koorayworks/7spromax-case/design/DESIGN_NOTES.md

# 7sProMax 3Dプリントケース 設計メモ v1（試作ラウンド）

> **v2 で大幅に作り直した（2026-11-04）。最新の設計内容は §16 を正とすること。**
> §1〜§15 は v1 の記録で、FR4 前提・図面一律 inset・FR4穴基準のネジ計画などは
> v2 では採用していない。

生成スクリプト: `build_case.py`（build123d 0.13 + shapely、寸法は冒頭パラメータに集約）
座標系: DXFテンプレートの半分ローカル座標。X=奥行（0..114.29、x=114側が背面）、
Y=長さ（short: y=0 が階段/中央側、y=143.36 が外側端 ／ long: y=0 が外側端、y=177.23 が階段側）、Z=ケース底面基準。

## 1. 構成（本人の確定仕様）

- パーツは片側ごとに3点：**トップフレーム（枠）／スイッチプレート（別体）／ボトムケース**。
  白FR4ボトムプレートはボトムケース底の浅い凹みに収め、底側の層として再利用する。
- 有線のみ・傾斜なし（フラット）・連結スロット無し。本家の積層
  （アルミトップ／基板／アクリル積層／FR4ボトム）のうち、アクリル層（基板周囲の
  スペーサー兼ライトガイド、実測の隙間 3〜3.5mm 相当）はボトムケースの壁で置き換えた。
- プレート別体の理由（本人指示）: スイッチ穴69個の層を枠と一体にすると印刷品質が
  出ないため。プレートは平板として単体印刷する。

## 2. Z方向の積み上げ（ケース底面 z=0、総高 16.1 = 本家側面図 16.1 と一致）

| z範囲 | 内容 |
|---|---|
| 0 〜 1.3 | ボトムケース床（FR4凹みの下）※ネジ頭ザグリはここに取る |
| 1.3 〜 2.5 | **FR4ボトムプレート 1.2**（凹みに収納、凹み底 1.3） |
| 2.5 〜 5.7 | 隙間 3.2（実測 3〜3.5、本家アクリル積層相当。基板裏面LED・TRRS下端の逃げ） |
| 5.7 〜 7.3 | **基板 1.6**（下端 5.7 はボトムケース壁天端＋支持レッジで受ける） |
| 7.3 〜 9.5 | 隙間（ソケット上面 = 基板表面+2.0 → 9.3 の上に 0.2 逃げ） |
| 9.5 〜 11.0 | **スイッチプレート 1.5（別体）** |
| 11.0 〜 12.85 | フレームのリップ（プレート外周を上から押さえる帯） |
| 12.85 〜 16.1 | フレームのウェル壁（天面開口 = 図面ポケット + 0.25） |

参考: スイッチのステム上端は基板表面+14.5 → z=21.8 でケース天面より上（本家も同様）。
タクトスイッチは基板**裏面**実装（写真 7315/7316 で確認）で、ボタン先端は基板裏面の
約 5.0 下まで届く前提 → 後述のタクト逃げ窓が必要。

## 3. 平面の設計値

- 壁厚 **WALL = 2.6**（外形→内腔）。基板外形はケース外形の約 3〜3.9 内側（実測中央値）
  なので、基板と内壁の間には概ね 0.5〜1.3 の余裕がある。階段部は基板輪郭データの
  信頼性が低いため、追加クリアランス `STAIR_CLR`（現状 0、壁一律）を用意した。
- スイッチプレート外周 = 図面ポケット輪郭 + **3.0**（`PLATE_UNDERLAP`、リップの下に
  隠れる分）、フレーム内壁との隙間 **0.25**。天面開口 = ポケット + 0.25。
- FR4凹み: 外形から inset **0.8**（FR4外形 141.1×103.1 / 174.7×103.5 がほぼ全面に
  広がるため薄壁になる。FR4実物の輪郭は未計測で、当たりは試作片で確認）。
- 基板支持レッジ: 外形から inset 5.2 の内側境界を持つ帯（z 4.5〜5.7）で基板端を
  下から受ける。裏面LEDはスイッチ位置（最寄り行で縁から約15mm）にあるため干渉しない想定。
- 背面のリムは約 10mm（ポケット x=104.24 ↔ 外形 114.29）あり、本家イメージの
  「厚めのベゼル」感に寄せた。外形の角Rは図面どおり（設計者CADの輪郭をそのまま使用）。

## 4. スイッチプレートの固定方法（選択と理由）

**採用: 挟み込み**。プレート外周の帯（ポケット+3.0 の部分）を、トップフレーム内側の
リップ（z 11.0〜12.85、下面がプレート天面に接する）が上から押さえ、下からは
69個のスイッチのフランジ＋ソケットが受ける。プレート自体にネジは通さない。

- 印刷しやすさ: プレートは完全な平板（吊りボス除く）で、反り・サポートの心配が
  最小。ツメ方式は薄いツメの印刷再現性と耐久に不安が残るため見送り。
- ガタつき: 周囲全周をリップで押さえるため点固定より面で効く。面方向の位置決めは
  フレーム内壁（隙間 0.25）とスイッチ穴そのもので決まる。
- 例外: 基板深部のFR4穴に対応する位置には、プレート裏面に**吊りボス**を一体成形
  した（§5）。これはプレート固定ではなくケース締結用で、プレートの支持点も兼ねる。
- 組み立て順: 基板にスイッチを挿す → プレートを被せる（スイッチが位置決めになる）
  → フレームを被せて裏からネジ締め。

## 5. ネジ計画（FR4プレート実測穴 19個の使い分け）

下からネジを通し、フレーム側ボス／プレート裏の吊りボスへタッピングする
本家同様のサンドイッチ締結。インサートなし。
下穴径: M3 = **Ø2.8**、M2 = **Ø1.7**。床側は通し穴 Ø3.4/Ø2.4 + 頭ザグリ
（FR4下面直下まで、低頭ネジ前提）。

| 分類 | 意味 | short | long |
|---|---|---|---|
| boss | フレーム側ボス（基板の外 or 端から4mm以内の帯） | L1(M3) L9(M3) L3 L4 L7 L8 (M2) | R1(M3) R2(M3) R3 R4 R5 R8 (M2) |
| hang | プレート裏の吊りボス Ø7/Ø5.5（基板に取付穴がある前提） | L2(M3) | （なし） |
| pin | ボトムケースの位置決めピン（ネジなし） | L5 L6 | R6 R7 R9 R10 |

- 本家キット実績（M3×8 ×6、M2×12 ×9、M2×7 ×4 = 穴数 大6/小13 と一致）が裏付け。
  本設計のネジ本数は M3 5本・M2 8本（残りはピン）。分類は基板輪郭（スキャン）と
  変換（§9）の両方が暫定のため、試作結果で入れ替わり得る。
- 推奨ネジ: 端部ボス M3 → **M3×8**、端部ボス M2 → **M2×7**、
  吊りボス → **M3×10 / M2×10**（キットの ×12 は本設計では長すぎる）。
  頭は低頭（頭高 約1.2 以下、頭径 M3 Ø5.5 / M2 Ø4 前提）。
- ゴム足: 大穴（M3）ネジ位置に Ø11×深さ1.0 の足逃げを兼用（ネジ頭を隠す）。
  追加で short (100,18) / long (100,160) にも足逃げのみ設定。要・足の実寸確認。

## 6. パドル（エクストラスイッチ）まわり ※実物写真 7353/7354 のはまり方を正とした

- 実態: 追加タクト×3 は基板裏面のタブ上（外側角、マイコン隣）にあり、金属パドルは
  基板端を巻いてケース背面の縁を乗り越え、先端が天面の縁の上に出る。押す面は外周側。
- ケース側の対応:
  - 背面縁の**ポケット×3**（図面外形そのもの、幅約4.7・深さ約8.0、
    short: y=103.4〜128.1 / long: y=15.1〜39.9）をそのまま壁の凹みとして再現。
  - フレーム背面壁はポケット位置で **z=9.6（プレート下面付近）より上を開けた**
    （`PADDLE_NOTCH_Z0`）。パドルの帯が壁を乗り越える通り道。
  - ボトムケースにはポケット位置に**タクト逃げ窓**（x=98〜112.3、床〜基板下端まで）
    を開け、裏面タクトのボタン（基板裏面−5.0 想定）とパドルの巻き込みを逃がす。
    窓の下は開放（本家もFR4が届かない帯域と推定）。
    窓の長手方向の範囲はポケットちょうど（マージン 0）。広げるとポケット間の
    壁（歯）が切り離されて浮きソリッドになるため（§15）。
- パドルの正確な帯幅・曲げ位置は未実測。**trial_corner_short**（ポケット×3＋窓＋
  TRRS＋USB を含む角の切り出し）で実物と当てること。

## 7. 開口（推定位置・要実物確認）

- **USB**: 外側端の壁、x 中心 97（マイコン帯域 85〜110）、幅 10、z 10.3〜15.3。
  ProMicro の USB が外側端を向く前提（基板写真から推定）。マイコン実装後に実測して
  `USB_XC / USB_Z0 / USB_Z1` を補正すること。
- **TRRS**: 背面壁、外側端から 55mm（`TRRS_OFFSET`）、幅 9、z 7.75〜13.15
  （ジャック中心 = 基板表面+3.0）。写真推定で ±10mm 級の誤差があり得る。

## 8. アンダーグロー（本人の案をパラメータ化）

- **薄壁帯**: ボトムケースの壁の下側の帯（z **2.8〜4.4**、本家アクリル層相当の帯域）
  だけ壁厚を **1.0mm**（`GLOW_T`）にし、白フィラメントで基板裏面LEDの光を
  壁越しに透過・拡散させる想定。パラメータ: `GLOW_ENABLE / GLOW_T / GLOW_Z0 / GLOW_Z1`。
- 強度との兼ね合い: 帯の上下には通常壁厚 2.6 の壁が残り、床（2.6）と基板支持
  レッジ（帯の上）も通常厚なので、ケース全体の剛性は主にそちらで保つ。
  薄くするのは高さ 1.6 の帯のみ。**GLOW_T の下限目安は 0.8**（0.4ノズルで
  2ペリメータ）。これ未満は印刷欠け・割れのリスクが上がる。光が弱ければ
  帯を広げる（Z1 を上げる）より先に GLOW_T=0.8 を試す。
- なお半透明フィラメントの別パーツ層（本家アクリルの直接の代替）を挟む案も
  あり得るが、パーツ点数と組み立てが増えるため今回は見送り、オプションとして残す。

## 9. 未確定・要実物確認（重要）

1. **FR4プレート座標変換 `PLATE_TF`（最重要）**: プレート単体座標→ケース座標の
   共通基準点が写真に無いため推定。現値 tx=11.0（両半分）、short ty=134.2（鏡像）、
   long ty=39.4。根拠: 穴の列がスイッチ列間のストリートに乗る値（tx=16 では
   全列が約+5.5 ずれてスイッチ開口に重なることを確認し棄却）。
   **trial_boss_* に実物FR4を重ね、穴とボス/通し穴のズレ量を測って補正すること。**
   ズレが分かれば tx/ty を直して再生成するだけ。
2. **階段境界**: ケース側は図面外形（信頼可）を壁一律 2.6 で内側オフセット。
   基板側の階段輪郭はスキャン信頼性が低く、当たりは **trial_stair_*** で確認。
   干渉すれば `STAIR_CLR` 相当の逃げを追加する。
3. **USB / TRRS 開口位置**: §7 のとおり推定。全体印刷の前にマイコン・TRRS を
   実装した基板で位置を実測するのが確実。
4. **端部ボスの基板干渉**: 基板端 4mm 以内のボス（L8 等）は、基板側に切り欠き/
   取付穴がある前提。特に L8（階段寄り）・L4/R4（ソケットまで約1mm）は
   試作片と実基板で干渉確認。吊りボスは基板に穴が無ければ単に未使用（無害）。
5. **タクト裏面実装の前提**: ボタン突出量（裏面から約5.0）は側面写真の読み。
   違えばタクト窓の深さ・位置を調整（窓はパラメータ化済み）。
6. **FR4凹み**: FR4輪郭そのものは未計測（最大寸のみ）。凹みは外形基準の
   inset 0.8 で、実物が入らない場合は inset を広げる。
7. **L3/R5（マイコン角の小ボス）**: マイコン/タクトタブとの近接を角試作片で確認。
8. プレートの tact_wide 開口（図面の横長穴×6）の用途は未確定のまま図面どおり
   抜いた（プレートは別体平板なので、用途が違っても組み立てを阻げない）。

## 10. 設計者イメージ（7349〜7352、実物 7353/7354）から取り入れた点・見送った点

取り入れた:
- 厚めの背面リム（約10mm）とフラットな天面、図面由来の角R → 全体のプロポーション。
- スイッチがウェルに沈む見た目（プレート上面から天面まで約 5.1 の段差）。
- 外側角の無地エリア（マイコンカバー部）: フレームのその部分は開口のない壁とした。
- 裏面: ネジ止め前提の構成、四隅相当の丸い窪み（ゴム足逃げ Ø11）。
- パドルポケット×3 と、その部分だけ壁が低く/切り欠かれる実物の作り（§6）。

見送った（本人の確定仕様を優先）:
- カップ状の一体成形（スイッチ部ポケット）→ プレート別体のため、見た目だけ
  ウェル＋平板で寄せた。
- 連結スロット（背面の溝）→ 作らない。ただしパドルポケットは別物として残した。
- 側面リブ表現・丸い側面開口・端部スロープ → 装飾要素として今回は入れない
  （要望があればフレーム外壁に追加可能）。
- 裏面中央の大きな窓 → 強度と防塵のため入れず、床は全面あり（タクト窓を除く）。

## 11. A1 mini（180×180）配置の注意

- long 半分は 177.23×114.28 で、軸平行だと長手方向の余裕が **2.8mm** しかない。
  スカート/ブリムは付けられない前提。つばなしで置くか、対角配置（回転）にする。
  プレート（long）は 172.7×109.8 で少し余裕がある。
- short 半分は 143.36×114.29 で余裕あり。
- 試作片はすべて 180×180 に収まる。

## 12. 印刷メモ

- スイッチプレート: 吊りボスがあるため、**ボスを上向き**（天面をベッド側）で
  印刷するとボスがサポートなしで立つ。天面の仕上がりはテクスチャプレート推奨。
- トップフレーム: 天面を下にして印刷するとベゼル上面が綺麗に出る（内側の
  チャネルは上向きの凹みになりサポート不要な範囲）。ボスは下向きに立つため、
  印刷方向は要検討（今回は形状のみ）。
- ボトムケース: 底面を下（通常姿勢）。グロー帯を使う場合は白フィラメント前提。
- ネジ頭は低頭タイプ前提（§5）。足は Ø11 逃げに合う市販ゴム足＋両面テープ想定。

## 13. 試作片の当て方（印刷順）

1. **trial_boss_bottom_short / frame_short**（最優先）: 実物FR4プレート（L）を
   凹みに置き、裏から通し穴・表からボスの位置がFR4穴と合うか見る。
   ズレたら方向と量を測る → `PLATE_TF` を補正して再生成。long 側も同様
   （trial_boss_bottom_long / frame_long、R10・R6 帯と R2・R8 ボスを含む）。
2. **trial_stair_short / long**: 階段側 50mm のフル積層切り出し。実基板（捨て板を
   割った後）を差し込み、階段・前後壁・レッジの当たりを見る。
3. **trial_corner_short**: 背面-外側角。パドル実物をはめ、ポケット・ノッチ・
   タクト窓の通りと、TRRS/USB 開口のだいたいの位置感を見る。

## 14. 再生成

```
~/workspace/.venv-cad/bin/python ~/workspace/7spromax-case/design/build_case.py
~/workspace/.venv-cad/bin/python ~/workspace/7spromax-case/design/render_previews.py
```
（所要: build 約90秒。出力STLはすべて design/ 直下。XYはケース座標のまま、
Zはパーツごとに最小z=0へ落として書き出す（§15）ので、スライサーでそのまま
ベッドに置ける。）

## 15. STL書き出しの正規化とソリッド接合（2026-11-03 修正）

初版STLは組立座標のまま書き出され、本体に融合していない浮きソリッドも
混ざっていたため、書き出しを正規化し、あわせて接合形状を直した。

- **Z落とし**: 各パーツは最小zが 0 になるよう平行移動して書き出す
  （向きは組立姿勢のまま）。XYはケース座標のまま。
- **単一ソリッド化**: 書き出し時に独立ソリッドを融合し、体積
  `DROP_VOL=10mm³` 未満の独立ソリッドは残骸として除去する。設計上意図した
  別ソリッドは存在しない（位置決めピンはボトムケースに融合、吊りボスは
  プレートに融合させる設計に変更）。試作片のクリップでも同じ処理を行い、
  積層試作では面接触で融合しない場合に僅かに重ねて融合し直す。
- **フレーム側ボスの接合アーム**（`ARM_*`）: ボス柱がフレーム本体に届かず
  浮いていた位置（short L4/L8/L9、long R2/R3/R4/R8）に、基板上面〜プレート
  下面の帯（z 7.35〜9.45）で柱から本体材料まで届く腕を追加した。この帯は
  ソケット上面（9.3）より上で基板とは干渉しない。L8 の腕は階段側へ
  ストリート沿いに伸びる形で、試作片での当たり確認対象。
- **吊りボスの食い込み**（`HANG_OVERLAP=0.5`）: 吊りボス上端をプレート
  スラブへ 0.5mm 食い込ませて確実に融合させる（従来は面接触のみ）。
  あわせて位置決めピンは FR4凹みの床へ 0.3mm（`PIN_EMBED`）、基板支持
  レッジはボトム壁へ 0.3mm（`LEDGE_EMBED`）食い込ませた。
- **R1 の再分類**: long の R1 はプレート外周から遠く「耳」が届かず、かつ
  その位置にはフレーム本体（ベゼル）があるため、吊りボスではなく
  フレーム本体への直接タップ（boss）に変更した（§5 の表を更新済み）。
  long 側の hang は無し。ネジ総数（M3 5本・M2 8本）は変わらない。
- **タクト窓マージン 0**: §6 のとおり。初版は窓の Y マージン ±3.5 で
  ポケット間の壁の歯が切り離され、44面の浮きソリッド×2 になっていた。
- **プレートのフィン除去**（`FIN_EPS=0.15`）: 階段際のキーなど、スイッチ穴が
  プレート外周に接する/近い箇所（実測の近接 0.002〜0.05、外周と平行な
  エッジ含む）は、穴周囲 0.15 を外形から除いて開口を外形の notch として
  取り込む。フィン（厚さ 0.02 以下）や穴壁と外周壁の接線接触があると
  STL が non-manifold になるための対策で、対象は short 4穴・long 5穴。
  該当キーの開口は材料側で最大 0.15 広がる。
- **検証結果**: 全13ファイルとも「単一コンポーネント・最小z=0・
  non-manifold エッジ 0（watertight）」を確認済み（頂点溶接ベースの
  独自チェッカで STL 実ファイルを検証）。

## 16. v2 への作り直し（2026-11-04）

v1 の実物合わせで3点の不適合が判明し、本人の新方針（FR4廃止）と新しい
実測データ（分割済み基板スキャン解析 `template/PCB_SCAN2_NOTES.md`、
基板外形 `pcb_outline2_*.csv`、基板ネジ穴候補 `pcb_screw_holes.csv`、
パドル実測 `PADDLE_MEASUREMENTS.md`）に基づき作り直した。

不適合の内訳（根拠は PCB_SCAN2_NOTES）:
- 階段: キャビティが図面外形の一律 inset で、実基板の歯と位相が合わず
  −0.7〜−3.6mm 級の干渉。「輪郭は合って見えるのに基板が入らない」状態だった。
- スイッチプレート穴: 14.95mm角（アルミトップのクリアランス開口の流用）では
  MX スイッチがパチ留めされず保持できない。穴位置自体は実測 RMS 0.17mm で正しい。
- パドル: ポケット幅が羽根込み 8.7mm に対して不足し、パドルが入らない。

### 16.1 構成と Z 積み上げ（FR4廃止）

- 構成は **トップフレーム／スイッチプレート／基板／ボトムケース** の3パーツ
  （白FR4ボトムプレートは使わない）。外形・総高 16.1 は v1 のまま維持。
- 床上面を旧 FR4 上面と同じ z=2.5 に置き、基板下面までの空間 3.2mm
  （基板裏面のダイオード・LED・裏面タブ上のタクト本体の逃げ）を確保した。

| z範囲 | 内容 |
|---|---|
| 0 〜 2.5 | ボトムケース床 |
| 2.5 〜 5.7 | 隙間 3.2（基板裏面部品の逃げ） |
| 4.4 〜 5.7 | 基板支持レッジ（キャビティ壁から基板縁の下へ 1.5 潜る帯） |
| 5.7 〜 7.3 | 基板 1.6 |
| 7.3 〜 9.5 | 隙間（ソケット上面 +2.0 の上に 0.2 逃げ） |
| 9.5 〜 11.0 | スイッチプレート 1.5（別体） |
| 11.0 〜 12.85 | フレームのリップ（プレート外周を上から押さえる帯） |
| 12.85 〜 16.1 | フレームのウェル壁 |

### 16.2 キャビティ（実測基板外形 + 0.5mm）

- ボトムケースのキャビティ壁は **実測基板外形（pcb_outline2）を全周
  +0.5mm オフセット**（丸ジョイント）した形状。階段も同じ規則で生成する
  ため、歯の位相は実基板と一致する。ケース外側の外形は従来どおり図面ベース。
- ただし基板が外形に 0.8mm 未満まで迫る箇所（階段の歯の側面・背面タブ先端）
  では、壁厚 0.8 を守るガード（外形の −0.8 との交差）が効いてクリアランスが
  0.5 を下回る。実測（基板輪郭 0.5mm 刻みサンプル、外形内側の点のみ）:
  中央値は両半分とも 0.500mm。最小は short ≈0.002（階段の歯側面、
  (64,14)・(83,23)・(93,25) 付近）、long ≈0.000（背面の張り出し部
  x≈113.5, y≈111〜113）。0.3 未満は全体の約 12% で、階段側面とタブ先端に
  集中する。ここは図面外形を維持する限り解消できないため、trial_stair で
  実物の入り具合を確認し、必要なら該当部の追加逃げを検討する。
- グロー帯（§8）は不変。ただし背面締結ネジの通り道はグロー帯と交差し、
  帯の高さではネジ軸が内側から見える（外側の 1.0mm 壁は残るため外観・強度
  への影響は小さいと判断）。

### 16.3 スイッチプレート穴（14.0mm角 + FDM補正）

- 穴は **14.0mm角（MX パチ留め標準）+ FDM補正 0.15 = モデル 14.15mm角**。
  位置は DXF 中心のまま（実測で正しいと確認済み、動かしていない）。
- 横長スロット（15.71×7.45mm、short 2 / long 4 = 計6か所）はスイッチ穴では
  ないため図面形状のまま抜く。スイッチ穴は short 28 + long 35 = 63。
- 外周近接穴の notch 取り込み（§15 の FIN_EPS）は継続（両半分とも4穴）。
- switch_plate_short は吊りボス下端（組立 z=7.35）が最下点になるため、
  書き出し STL の高さは 3.65mm。§16.6 のとおり溶接検証で単一ソリッドを
  確認済み（v1 で指摘された「浮き」は、耳がプレート外周に届かず union の
  最大ポリゴン選択で落ちてボスが単独化したのが一因。v2 では耳の可否を
  外周までの距離で判定し、届かない候補は採用しない）。

### 16.4 パドルまわり（実測エンベロープで再設計）

設計寸法（実測）: 羽根込み幅 **8.7**／ブロック幅 4.8／全長 **27.3**／
ブロック高さ約 8.5（推定）／バー厚 **2.7**（ファイル内の 1.5〜2.0 は
本人が実物で再読した 2.7 に置き換える）。

- ボトムケース: タクト中心（実測、short y=102.6/110.9/121.7、
  long y=14.0/23.5/35.9）基準で、幅 **9.9**（= 8.7 + 片側クリアランス
  0.6 ×2）の窓を床から基板下面まで全て抜く。近接する窓はマージされる
  （short: [97.6, 115.9] と [116.8, 126.7]、long: [9.1, 28.4] と
  [30.9, 40.8]）。窓間の壁の歯は床を介してつながるためボトム側は残す。
  窓の x 範囲は 97.0 〜 外形の外（ブロック占有 x≈101〜111 と
  バーの張り出しをカバー）。
- トップフレーム: パドル帯全体（short y=97.6〜126.7、long y=9.1〜40.8）を
  x≥100 で基板上面から天面まで全高で開ける。帯ごとに開けると帯間の歯が
  両側を切られて浮きソリッド化した（試作ビルドで short 18mm³ の薄片、
  long 127mm³ の歯を確認）ため、フレーム側は帯全体を 1 区間で開ける。
  バー（厚 2.7）の通り道は全高で確保される。
- パドル先端はケース背面の外まで達する想定（全長 27.3 に対し、
  タクト中心から背面外形まで約 8mm）で、開口は外側まで抜けている。

### 16.5 ネジ計画 v2（FR4穴基準を廃止）

v1 の前提（FR4 穴位置に基板の取付穴がある）は実測で否定された
（基板ネジ穴候補と FR4 穴の最寄り距離は最小でも 5.0mm）。組み直し:

**背面締結（ケース同士、主締結）**: 実測基板の背面縁は外形まで
1.7〜2.9mm に迫る区間が多く、背面リム一律には置けない。基板縁が
後退する「湾」の区間を y 方向に走査して自動検出し、階段側／中央／
外側の 3 帯域から M3 を選んだ（置けない帯域は M2 でも再走査）。
- short: M3 (111.54, 29) / (110.24, 129) の 2 本。中央帯域（y 50〜94）は
  TRRS 帯と基板縁の接近のため M3・M2 とも置けず、締結なし
  （レッジ＋キャビティ＋リップで位置決めする前提。試作で要確認）。
- long: M3 (111.50, 7) / (111.52, 87) / (111.53, 117) の 3 本。
- 仕様: 床側は通し穴 Ø3.4 + 頭ザグリ Ø6.5×深さ 1.3、フレーム側は
  タッピング下穴 Ø2.8・深さ 6.6。推奨ネジは **M3×12 低頭**
  （床下の壁 5.7 を通して約 6 かかる）。

**吊りボス（基板ネジ穴を通す、副締結）**: pcb_screw_holes の HIGH/MEDIUM
全候補を、ボス Ø7（M3）がスイッチ開口から 3.8 以上離れ、プレート上に
載る（または耳が外周まで 4.5 以内で届く）条件で自動判定した。
- short (52.62, 133.69) MEDIUM: **採用**（プレート内、開口まで 5.46）。
  プレート裏の吊りボス Ø7、タップ Ø2.8・深さ 3.3、推奨 **M3×10**
  （基板穴 Ø≈4.3 を通す）。
- short (16.49, 135.16) HIGH: 不採用。プレート外周まで 6.59 あり耳が
  届かない（コーナー部はプレートがカバーしない）。
- short (29.03, 129.78) / (29.22, 105.26) MEDIUM: 不採用
  （開口まで 1.52 / 1.33 < 3.80）。
- long (9.08, 110.36) / (9.85, 136.01) HIGH: 不採用（開口まで
  2.03 / 1.40 < 3.80。M2 用 Ø5.5 ボスでも必要 3.05 に届かない）。
- long (14.68, 3.31) MEDIUM: 不採用（プレート外周まで 8.68）。
- 結果: 前面帯にケース締結は無い（前面の壁は約 3.5mm で FDM タッピング
  には薄すぎるため。前面はレッジとリップで保持する）。v1 の位置決め
  ピン（FR4 穴基準）も廃止した。
- ゴム足逃げ Ø11×1.0 は全ネジ位置 + FEET_EXTRA に付く。

### 16.6 試作片と STL 検証（v2）

試作片の構成を変更した:
- **trial_stair_short / long**: 新キャビティの階段当たり確認（従来枠組み）。
- **trial_corner_short**: 新しいパドル窓・通路の当たり確認。
- **trial_screw_short / long**（新規、旧 trial_boss_* の後継）:
  背面締結と吊りボス帯のフル積層切り出し。short は y=118〜146.4
  （背面 M3 (110.24,129) と吊りボス (52.62,133.69) を含む）、
  long は y=100〜180.2（背面 M3 (111.53,117) を含む）。
- **trial_plate_holes**（新規）: 47.6×38.1×厚 1.5 の小片に実寸穴
  （14.15mm角）をピッチ 19.05 で 2×2。スイッチ単体でパチ留めの
  保持感だけを先に確認するためのもの。
- trial_boss_bottom / trial_boss_frame（FR4 重ね確認用）は廃止し、
  STL も削除した。

書き出し検証（`verify_stl.py`、頂点溶接ベースで STL 実ファイルを再解析）:

| ファイル | tris | コンポーネント | 最小z | non-manifold |
|---|---|---|---:|---:|
| bottom_case_short.stl | 10586 | 1 | 0.000 | 0 |
| bottom_case_long.stl | 8750 | 1 | 0.000 | 0 |
| switch_plate_short.stl | 2732 | 1 | 0.000 | 0 |
| switch_plate_long.stl | 2560 | 1 | 0.000 | 0 |
| top_frame_short.stl | 1458 | 1 | 0.000 | 0 |
| top_frame_long.stl | 2112 | 1 | 0.000 | 0 |
| trial_stair_short.stl | 8236 | 1 | 0.000 | 0 |
| trial_stair_long.stl | 3764 | 1 | 0.000 | 0 |
| trial_corner_short.stl | 2304 | 1 | 0.000 | 0 |
| trial_screw_short.stl | 5696 | 1 | 0.000 | 0 |
| trial_screw_long.stl | 6452 | 1 | 0.000 | 0 |
| trial_plate_holes.stl | 92 | 1 | 0.000 | 0 |

再生成コマンドは §14 に `verify_stl.py` を加えた以下:
```
~/workspace/.venv-cad/bin/python ~/workspace/7spromax-case/design/build_case.py
~/workspace/.venv-cad/bin/python ~/workspace/7spromax-case/design/render_previews.py
~/workspace/.venv-cad/bin/python ~/workspace/7spromax-case/design/verify_stl.py ~/workspace/7spromax-case/design/*.stl
```

### 16.7 v2 の未確定・要実物確認

1. 階段の実クリアランス（§16.2）: trial_stair で基板が入るか確認。
   干渉する場合は該当 flank のみ追加逃げ（外形側の壁を 0.8 未満にする
   局所変更）を検討する。
2. short 中央帯域（y 50〜94）に背面ネジが無い構成の効き具合。
3. USB / TRRS 開口位置は v1 の推定のまま（§7）。マイコン実装後に実測推奨。
4. パドルのブロック高さ約 8.5 は推定値。ただし通路は全高で開けてあり、
   窓も床まで抜けているため、高さ方向の余裕は十分なはず。
5. 吊りボス採用は short の 1 か所のみ。効きが弱ければ、開口近接で
   不採用にした候補を Ø5.5（M2）ボスで再評価する余地がある。

## 17. v2.1 への改修（2026-11-04）

v2 の実物・形状チェックで見つかった問題（§16.7 と本節冒頭）の修正に、
2つの追加方針を反映した改修:

- **試作回数の最小化**（本人方針）: 仮想検証を組立一括で厚くし、試作片は
  1回の印刷セッションに集約する（§17.6、§17.7）。
- **側面バンドの別パーツ化**（本人方針）: 本家のアクリル層に相当する
  白い側面バンドを独立パーツにする（§17.5）。

積層構成（色分け）: **黒ボトムトレイ → 白い側面バンド → 基板 →
黒プレート → 黒フレーム**。総高 16.1 は v2 から不変。FR4 ボトム
プレートは無し（v2 決定どおり）。
§13・§16.7 の試作片に関する記述は本節（§17.6、§17.9）で置き換える。

### 17.1 修正1: トップフレーム×基板の干渉（最重要）

- 症状: フレーム下帯（z 5.7〜7.3）が基板外形と **約1,559mm³ 干渉**し、
  基板を入れるとフレームが座らない。原因はフレーム内壁が
  「プレート外形+0.25」で、キャビティ輪郭（基板+0.5、ただし最小壁
  0.8mm のクリップ付き）より内側に入る箇所があったこと（背面帯で
  最大 6.2mm、クリップ起因でもタブ先端で 78.7mm³）。
- 修正: フレーム下帯（z 5.7〜9.5）の内壁を **クリップなしの
  基板+0.5（`cavity_full`）** に合わせた。プレート帯（9.5〜11.0）は
  従来のプレート帯域+0.25 のまま（境界は 0.05 重ね）。トレイ/バンド側は
  従来どおりクリップ付きキャビティで最小壁 0.8 を守る（基板下面より
  下なので干渉は起きない）。
- 再検証（§17.7）: フレーム下降スイープ（h=2.0/1.0/0.5/0.25/0）×
  基板は short/long とも **全て 0.000mm³**。基板→フレーム下帯内壁の
  平坦クリアランスは最小 0.499 / 中央値 0.500、0.3 未満のサンプル
  **0件**（クリップ付きキャビティに残っていた継ぎ目・タブ先端の
  ≈0 点は、フレーム側では解消）。

### 17.2 修正2: パドル通路のタクト別スロット化

- 現状の帯全高開放を廃止し、実物写真 7354 の完成形（バーが背面壁を
  横向きに貫く）に合わせてタクト別スロットにした: 中心 **y±3.0
  （幅6.0）、z 6.2〜10.1、x 内側端 104**。上壁（10.1〜16.1）・下壁・
  タクト間の壁が残る。
- バンド/トレイ側のパドル窓（幅 9.9）は、**窓間隔 3.0mm 未満を連結**
  して1区間にした（short y 97.65〜126.65、long y 9.05〜40.85）。
  窓間に残っていた細い歯・孤立した島は消滅。
- 再検証（配置Bエンベロープ、§17.7）:
  - バー単独 × フレーム = **全6タクト 0**（スロットを正しく通る）。
  - 静止/押下−0.5 × トレイ/バンド = **全タクト 0**。
  - スロット上壁の材料体積は全タクトに存在（24.6〜41.6mm³）。
    ブロック幅 8.7 > スロット幅 6.0 の関係が z 9.5〜10.1 のリップで
    効き、抜け止めになる。
  - 残存（2件、§17.9 の実物確認項目）:
    1. **long タクト1（y=14.0）: 静止 39.15 / 押下 34.50mm³**
       （対フレーム）。基板タブ（y12〜16、x≤113.21）の脇で基板縁が
       x=103.32 まで後退し、エンベロープ（short タブ基準の最悪値
       ボックス）のブロック角がタブ脇の内壁に当たる。エンベロープ
       特有の局所的な窮屈さで、設計は仕様どおりとした。
    2. 傾き +2.5°（中央タクト）: フレーム 1.09/1.23mm³、プレート
       約6.3mm³（厳密ブーリアンの参考値）。極端な姿勢での軽い接触。

### 17.3 修正3: 階段壁の塊化

- 外形側を段差のラン（踏面/蹴上）ごとの直線ブロックに量子化し、
  各ランでキャビティ（基板+0.5、クリップなし）から **壁厚 2.2mm** を
  確保する位置まで一律に外形を出した。内側は基板+0.5 のまま。
  踏面/蹴上の継ぎ目（±1.2mm）は図面の R≈1 アークが残り壁厚約1.8mm。
- ラン別 push 量（=図面外形からの逸脱、階段側のみ）:

| half | ラン | T1 | R1 | T2 | R2 | T3 | R3 | T4 | R4 | T5 | フェイス壁厚の最悪値 |
|---|---|---:|---:|---:|---:|---:|---:|---:|---:|---:|---:|
| short | push (mm) | 2.04 | 1.52 | 2.04 | 2.02 | 1.93 | 0.01 | 0.00 | 2.16 | 0.95 | 2.170 |
| long | push (mm) | 0.08 | 1.79 | 1.82 | 1.78 | 1.99 | 0.57 | 1.74 | 0.91 | 0.00 | 2.193 |

  （T=踏面、R=蹴上。long の R2/R3/R4 は −x 方向（内側の歯側）への push）
- 左右間: 図面レイアウト座標での最接近は 外形↔外形 **14.68mm**、
  基板↔相手側外形 18.62（short 基板）/ 21.60（long 基板）。
  量子化の食い込み（最大 2.16mm）では接触しない。

### 17.4 修正4: フィン/スリバーの除去

- ボトム（現バンド）の窓端フィン: データ駆動で分岐する。背面ネジと
  窓端が 6mm 以内の箇所で、壁領域（外形−キャビティ、ネジ穴+0.9 を
  除く）が **5mm² 未満ならフィンごと切り取り**（short: 窓端 126.65 ×
  M3 (110.24,129)、壁領域 3.5mm² → 切除）、**広ければウェブで埋める**
  （long: (111.50,7) 付近に 27.2mm² のウェブ）。
  切り取り範囲はネジ中心 ±1.35 まで: ノッチ角ではバンドのスカート
  （§17.5）のアーク部が切り取りで孤立残片（0.69mm³）になったため、
  残片ごと除くよう拡張した。
- プレートのスリバー: 角穴の fin-fix 閾値を **0.5mm** に拡張し、
  方式は **穴の全周バッファ**（帯限定方式・無修正では階段側の縁が
  穴カットだけで首部 0.5mm 未満となりプレートが分離するため）。
  除去量は short −943mm² / long −1217mm²（プレート帯域比）。
  long プレート角の 1.2mm² の小片は最大ソリッド選択で脱落（許容）。
  再検証: 穴→外形の最小正距離は short 2.24 / long 2.52mm で、
  0.5mm 未満の首は残っていない（ノッチ化した穴は外形と合体）。

### 17.5 側面バンドの別パーツ化

- 旧ボトムケースの外周壁（床上面 z=2.5 〜 基板下面 z=5.7）を
  **side band** として切り出した。ボトム側は床＋内側の造形
  （パドル床窓、ネジ通し穴+ザグリ、ゴム足逃げ、位置決め溝）だけの
  浅い **bottom tray** になった。ファイル名:
  `bottom_tray_<half>.stl` / `side_band_<half>.stl`
  （`bottom_case_*` は廃止）。
- バンド形状: **全周を一周する閉じたリング**（背面・階段側を含む）。
  外形はフレームと同一輪郭（階段の塊化を含む）。
  - 薄壁部（光漏れ）: z 2.5〜4.4、**壁 1.2mm**（内側を
    inset(1.2) まで拡大）。基板下面より下は中央の部品が壁に
    届かないため広げてよいが、背面はパドルブロック（x≤111）に
    対し内側 x≈113.03 で **2.03 の隙間**を確保。
  - レッジ帯: z 4.4〜5.7 は基板支持レッジを支えるため内側を
    キャビティ輪郭のままにし、レッジはバンド側に付けた。
  - パドル窓はトレイと共通（§17.2 の連結窓で両パーツを抜く）。
  - 背面ネジ（M3）はバンドに **Ø3.4 の逃げ**を通した。吊りボス用
    ネジは内側の開放空間を通るため逃げ不要。
  - 位置決め: バンド下面の**スカート**（inset 0.9〜1.7 のリング状
    リブ、z 1.9〜2.8）がトレイ上面の**溝**（inset 0.75〜1.85、
    深さ 0.65）にはまる。横隙間は片側 0.15、底隙間 0.05。
    バンド↔フレームは背面ネジ＋レッジの挟み込みで位置が決まる。
  - ネジ有効長の再確認: 積層の高さ配分は不変（トレイ 2.5 +
    バンド 3.2 = 5.7）で、M3×12 低頭のフレームへの到達は
    6.3mm ≤ タップ深さ 6.6mm（§17.7 のネジ経路で確認）。
  - v1〜v2 のグロー帯パラメータ（壁を 1.0mm に薄くする帯）は
    バンド薄壁部に統合して廃止した。
- バンド STL の z 範囲は 0〜3.80（組立座標では 1.9〜5.7、
  スカート下端が最小）。

### 17.6 試作片の集約（1回の印刷セッション、全9片）

必須の確認だけを A1 mini のベッドに同時配置できる小片にした。
全てパーツ別クリップ（積層クリップは廃止）。

| ファイル | 元パーツ | 切り出し範囲 (x, y) | 確認内容 |
|---|---|---|---|
| trial_plate_holes.stl | （単体小片） | 47.6×38.1、穴2×2 実寸 | プレート穴のパチ留め |
| trial_stair_band_short.stl | バンド | x −3〜117.3, y −3〜50 | 階段の当たり（基板の歯・レッジ） |
| trial_stair_band_long.stl | バンド | x −3〜117.3, y 127.2〜180.2 | 同上 |
| trial_corner_tray_short.stl | トレイ | x 80〜117.3, y 80〜146.4 | パドルまわり（床窓・溝） |
| trial_corner_band_short.stl | バンド | 同上 | パドルまわり（窓・スカート） |
| trial_corner_frame_short.stl | フレーム | 同上 | パドルスロット・USB/TRRS 開口 |
| trial_corner_tray_long.stl | トレイ | x 80〜117.3, y −3〜50 | 同上（long 側） |
| trial_corner_band_long.stl | バンド | 同上 | 同上 |
| trial_corner_frame_long.stl | フレーム | 同上 | タクト1 の当たりを特に確認 |

- 角試作片は3パーツを手で重ねる（トレイ→バンドはスカート/溝で
  位置決め、フレームはバンドの上に載せる）。実物パドルと基板を
  当てて挿入・保持・タクト逃げを見る。
- 廃止した試作片: trial_screw（ネジ経路は §17.7 の仮想検証で
  確認）、trial_stair のプレート/フレーム片（フレーム×基板は
  スイープで干渉0、階段の当たりはレッジと外形を持つバンドで
  判定できる）、旧 trial_corner_short / trial_stair_*（積層・
  ボトム版）。
- 注意: trial_corner_band_* は **2ピース**で出力される。クリップが
  パドル窓の位置でバンドのリングを切断するためで、両片とも
  watertight（§17.8）。そのまま2片として印刷してよい。

### 17.7 仮想検証の結果（組立一括、check_v21.py）

全パーツ（トレイ/バンド/基板スラブ/パドル配置B/プレート/フレーム）を
組立位置に重ねた厳密ブーリアン計測（STL は書き出し形状を使用）。

| 項目 | short | long |
|---|---:|---:|
| フレーム下降スイープ × 基板（h=2.0/1.0/0.5/0.25/0） | 全て 0.000 | 全て 0.000 |
| 基板→フレーム下帯内壁クリアランス（最小/中央値、<0.3 の数） | 0.499 / 0.500、0件 | 0.499 / 0.500、0件 |
| パーツ間干渉（トレイ/バンド/フレーム/プレート/基板の全10ペア） | 全て 0.000 | 全て 0.000 |
| バンド着座スイープ（バンド +1.0/+0.5/0 × トレイ） | 全て 0.000 | 全て 0.000 |
| パドル静止/押下 × トレイ・バンド（全タクト） | 0.00 | 0.00 |
| パドル静止/押下 × フレーム | 0.00 | タクト1 のみ 39.15 / 34.50（§17.2） |
| バー単独 × フレーム（全タクト） | 0.000 | 0.000 |
| スロット上壁の体積（タクト1/2/3、mm³） | 31.6 / 41.6 / 38.9 | 32.8 / 38.2 / 24.6 |
| 背面ネジ: クリアランス経路 × トレイ+バンド / タップ径 × フレーム | 0.000 / 0.000（2本） | 0.000 / 0.000（3本） |
| 吊りネジ: クリアランス経路 / タップ径 × プレート | 0.000 / 0.61 ※ | （吊りなし） |
| 左右間（図面レイアウト）: 外形↔外形 / 基板↔相手側外形 | 14.68 / 18.62 | （同左）/ 21.60 |
| プレート穴→外形の最小正距離 | 2.24 | 2.52 |

※ 吊りネジの 0.61mm³ は、テスト円柱が止まり穴の天井より 0.1mm
高くまで伸びた分の見かけで、実際の通り道の障害ではない
（穴は Ø2.8 × 深さ 3.3 で、円柱は同径・同深さ+0.1 で計測）。

### 17.8 STL 検証（verify_stl.py、頂点溶接ベース）

| file | tris | comp | minz | non-manifold |
|---|---:|---:|---:|---:|
| bottom_tray_short.stl | 4514 | 1 | 0.000 | 0 |
| bottom_tray_long.stl | 4706 | 1 | 0.000 | 0 |
| side_band_short.stl | 2342 | 1 | 0.000 | 0 |
| side_band_long.stl | 3258 | 1 | 0.000 | 0 |
| switch_plate_short.stl | 2728 | 1 | 0.000 | 0 |
| switch_plate_long.stl | 2684 | 1 | 0.000 | 0 |
| top_frame_short.stl | 7986 | 1 | 0.000 | 0 |
| top_frame_long.stl | 5588 | 1 | 0.000 | 0 |
| trial_stair_band_short.stl | 1610 | 1 | 0.000 | 0 |
| trial_stair_band_long.stl | 824 | 1 | 0.000 | 0 |
| trial_corner_tray_short.stl | 1098 | 1 | 0.000 | 0 |
| trial_corner_band_short.stl | 592 | **2** | 0.000 | 0 |
| trial_corner_frame_short.stl | 1368 | 1 | 0.000 | 0 |
| trial_corner_tray_long.stl | 1178 | 1 | 0.000 | 0 |
| trial_corner_band_long.stl | 1034 | **2** | 0.000 | 0 |
| trial_corner_frame_long.stl | 1420 | 1 | 0.000 | 0 |
| trial_plate_holes.stl | 92 | 1 | 0.000 | 0 |

本体パーツ（8点）は全て コンポーネント=1 / 最小z=0 /
non-manifold=0。trial_corner_band_* の 2 は §17.6 のとおり
クリップによる切断で、欠陥ではない。

### 17.9 実物なしでは決めきれない項目

仮想検証で潰しきれず、試作・実機でしか決まらないもの:

1. **long タクト1 のパドルブロック角**（§17.2）: 実物パドルの角が
   エンベロープより小さければ無接触。trial_corner_*_long に実物を
   当てて確認し、必要ならフレーム内壁へ局所逃げを追加する。
2. プレート穴 14.15mm のパチ留め感（フィラメント収縮・個体差）。
   → trial_plate_holes。
3. 階段の最終当たり（印刷誤差込み）。→ trial_stair_band_* に
   実基板を当てる。フレーム側は仮想で干渉0だが実物未確認。
4. バンドの光透過（白フィラメントの銘柄と壁 1.2mm の透け具合）と、
   スカート/溝のはめ合い（片側 0.15mm の印刷再現性）。
5. ネジのタッピング感（フレーム Ø2.8 × 深さ 6.6 への M3 セルフ
   タップ、吊りボス short 1か所の効き）。
6. USB / TRRS 開口位置（写真推定のまま。マイコン実装後に実測）。
7. パドル実物（ブロック高さ・羽根の実形状）と配置Bエンベロープ
   （最悪値ボックス）との差。実測は PADDLE_MEASUREMENTS.md。

### 17.10 再生成（v2.1）

```
~/workspace/.venv-cad/bin/python ~/workspace/7spromax-case/design/build_case.py
~/workspace/.venv-cad/bin/python ~/workspace/7spromax-case/design/check_v21.py
~/workspace/.venv-cad/bin/python ~/workspace/7spromax-case/design/render_previews.py
~/workspace/.venv-cad/bin/python ~/workspace/7spromax-case/design/render_guide.py
~/workspace/.venv-cad/bin/python ~/workspace/7spromax-case/design/render_guide_paddle.py
~/workspace/.venv-cad/bin/python ~/workspace/7spromax-case/design/verify_stl.py ~/workspace/7spromax-case/design/*.stl
```

### 17.11 v2.2: 階段内側のトゲ除去＋USB/TRRS 開口の是正（2026-11-04）

本人指摘3件＋実物情報1件への対応。生成側（build_case.py）で一括修正し、
全8パーツ＋試作片を再生成した。

**A. 階段内側のトゲ（top_frame／side_band／switch_plate の指摘）**

- 正体: キャビティ（基板+0.5）とレッジ内側が pcb_outline2 の階段帯の
  「大きな三角形の湾」に追従し、上面視で外形・キーウェルの矩形ステップと
  重なって三角形のトゲに見えた。フレームではキーウェル間の仕切りではなく
  下帯内壁（cavity_full 由来）の歯型が正体。
- outline2 の階段帯には幻影がある証拠: 実測ソケット（ドーム重心法）の
  中心が outline2 の外側にはみ出すものが short で4点（S27 −2.52mm、
  S26 −2.40、S19 −1.66、S25 −1.12。符号は内側が正）。内側にある階段帯
  ソケットも最小 +2.21 で、ドーム半径 2.75 を下回る＝実縁は outline2 より
  壁側にある。マット写真の実縁は綺麗な矩形ステップで、§5 のエッジ探索が
  基板表面の配線グルーブを実縁と誤認した可能性が高い。
- 対策（生成側の一括修正）: 外形側の quantize_stair と同じラン列
  （stair_chain に分離して共有）を使い、キャビティとレッジ内側を
  ランごとに直線フェイスへ寄せる bridge_stair を追加した。フェイス位置は
  ラン内で輪郭が壁側へ最も張り出す点に合わせ（和集合フィルなので
  outline2 に対する 0.5 クリアランスは割らない）、階段帯の実測ソケット
  中心から半径 3.25mm（ドーム半径 2.75＋0.5）の円盤も呑む位置まで寄せる
  保険付き（今回のデータでは円盤は拘束にならず、顔は輪郭極値で決まった）。
  外形の量子化はブリッジ済みキャビティ（cavity_q）を基準に壁厚 2.2 を
  確保し直したため、long の階段フェイス押し出しは最大で約 +1.1mm 増え、
  左右間最接近（外形↔外形）は 14.68 → 15.59mm。
  （訂正 2026-11-04: 初版の「11.74mm」は誤り。check_v21.py §6 が
  スキャン fit 用の原点（short を x に +11.552mm ずらす）を使ったための
  原点混用で、公式図面レイアウト（両半分とも背面が揃い相対 x オフセット
  0、dy=183.414）での正値は 15.59mm。§6 の原点は図面レイアウトに
  修正済み。詳細は §17.12。）
- 検証: check_v21 全項目 v2.1 と同等（フレーム下降スイープ干渉 0、
  cavity_full クリアランス最小 0.499、パーツ間干渉 全ペア 0、バンド着座 0、
  ネジ経路 0、パドルの既知残件 long tact1 39.15/34.50 は不変）。
  verify_stl は本体8点すべて単一ソリッド／最小 z=0／non-manifold 0。
  断面比較は guide_stair_fix_v22.png（赤=v2.1、緑=v2.2）。旧境界の
  窓内点数は frame_short で 7740→2271 に減少（湾の迂回の消滅）。
- 残る実物確認: 実歯が outline2＋ブリッジ面よりさらに張り出す箇所では
  実クリアランスが 0.5 を割る可能性がある。trial_stair_band の実物当てが
  その判定になる（従来版より悪化する方向ではない）。

**B. スイッチプレートの端（「切れてない？」への回答）**

- 実測照合: プレート STL の外周は設計定義（plate_bnd_p＝
  outset(pocket, 3.0) ∩ inset(outline, 2.25)＋fin-fix ノッチ）と
  両方向最大 0.07mm で一致。切り残しや生成バグではない。
- プレートの縁は基板の歯型には追従せず、ポケット＋外形オフセットの
  滑らかなステップで歯の上を橋渡しする設計形状（スイッチ穴を全面で
  支えるため）。階段側で基板の歯が見える箇所はプレートが歯先まで
  届いていないだけで、ケース外形より内側（2.25mm 以上）に収まる。
  照合図は guide_plate_edge_v22.png。

**C. USB 開口（本人実物情報: コネクタはタブ先端＝外側端面を向く）**

- 面は従来どおり外側端の壁で正しかった。中心 x を写真計測で是正:
  7378/7379 のピン列2列（ピッチ実測 ≈30.4px／2.54mm）と列間のスイッチ
  穴列（x=93.72、Hough／目視で同定）を基準に、両半分ともコネクタ中心
  x≈93.7 と計測。旧値 97.0・幅 10 ではコネクタ（幅 8.9）左側が約 2.7mm
  塞がれる状態だった。
- 変更: USB_XC 97.0→94.0、幅 10→13、z 10.3〜15.3→9.8〜15.3
  （プラグ胴体の逃げを確保、上端の壁 0.8 は維持）。
- 比較図は guide_usb_trrs_v22.png 上段。

**D. TRRS 開口（タブ位置の実測是正）**

- 細いタブの中心 y を写真計測: short はタブ穴の既測値 (107.06, 64.07) と
  整合して y≈64.5、long はタブ穴2個の既測値 y≈83.4/83.6 と整合して
  y≈83.5。旧値（外側端から 55 ＝ short 88.4／long 55.0）は short で
  約 24mm、long で約 28mm ずれていた。
- 変更: TRRS_OFFSET を廃止し TRRS_Y = {short: 64.5, long: 83.5} に。
  開口サイズ（幅 9、z 7.75〜13.15）と背面壁の面は不変。
  比較図は guide_usb_trrs_v22.png 下段。
- ついでに判明: outline2 の背面縁もタブ脇の凹みを捉えられていない
  （一様に x≈114）。タブ先端は outline2 の最大値と一致し干渉方向の
  問題はないため、今回は開口位置のみ是正した。

### 17.12 v2.3: 階段輪郭の再構成（outline3）＋三角形の厚い壁の除去（2026-11-04）

本人決定: 「階段の深い段差のところにできる三角形の厚い壁部分は不要
なので削る」（trial_stair_band_short を目視しての指摘）。根本原因は
階段部の基板輪郭データ（pcb_outline2）にスキャンのノイズが乗っている
ことなので、順序として (1) 輪郭データを作り直し、(2) その上で壁厚
上限を適用した。

**1. 輪郭の再構成（template/pcb_outline3_{short,long}.csv）**

- outline2 の階段帯はマット写真の局所エッジ探索（PCB_SCAN2_NOTES §6）が
  基板表面の段差状グルーブを実縁と誤認したもので、境界が最大 26.98mm
  （short、頂点 (59.0, 41.2)）も基板内側へ zigzag に食い込んでいた。
  実物の縁は綺麗な矩形ステップ（階段が向かい合う実物写真 7373 でも確認）。
- 再構成（template/make_outline3.py、詳細は template/OUTLINE3_NOTES.md）:
  踏面の x 区切りは公式図面のケース外形の段位置（≒ソケット列中線）に
  合わせた6段構成（5列＋背面寄り踊り場）。各段の先端は3アンカーの
  突き合わせで決定: A=outline2 の包絡極値・平坦ラン、B=端ソケット中心
  （ドーム重心実測）∓ハーフ内一定マージン（short 8.63／long 9.05）、
  D=公式図面の段レベル＋基板インセット（short +0.7 で段3〜5と一致）。
- short のタブ（列2）: トレースされた先端 3.96 は溝の誤認と判定し、
  B・D が独立に指す 0.65 を採用。根拠は (a) ソケットドームの物理条件
  （先端 ≤ 中心−2.75 = 6.53)、(b) マージン・インセットの一致、
  (c) リスクの非対称性（逆に誤ると基板がキャビティを約3.3mm突き破る）。
- 置換範囲は階段側 x∈[3.2, 113.7] の帯のみ。非階段部は outline2 と
  幾何学的に完全同一（対称差 0.0000 mm²）。long 背面寄りの実在する
  矩形ノッチ（x≈103.4–114, y≈128–164.5）は充填せず保存
  （ステップ縁に接する連結成分だけを充填する方式で担保）。
- 面積差: short +802.2 mm²／long +202.1 mm²（谷の充填）、削り取りは
  両半分とも 0.1 mm² のみ。全ソケット中心が新輪郭の内側に収まり、
  階段端ソケットの縁までの距離は最小でも long L21 の 4.08mm
  （ドーム半径 2.75 を引いた余裕 1.33mm、正）。
- 比較図: design/guide_outline3_compare.png（赤=outline2、緑=outline3）。

**2. 生成側の変更（build_case.py）**

- キャビティ／レッジから bridge_stair を引退させた。矩形ステップの
  outline3 に対しては、fill 矩形が隣接蹴上の円弧や窓外の境界点を
  拾ってキャビティ面を最大約1.2mm引っ張る副作用の方が大きい
  （実測: short 段3の面 9.75→8.59、前面段 10.5→8.29、タブ南側への
  はみ出し等）。キャビティは outset(pcb3, 0.5) そのものになり、
  ソケット円盤の保険は check_v21 §8 で検証する形に変更。
- quantize_stair の矩形 union が蹴上脇に残していた「湾」を閉じた
  （踏面矩形の x 範囲・蹴上矩形の y 範囲を、隣接ランのフェイス位置と
  図面位置の外側いっぱいまで拡張）。湾があると inset クリップが
  キャビティを基板際まで食い込ませていた（v2.2 からの既存欠陥で、
  v2.3 の回帰ではない）。量子化の最悪フェイス壁厚は両半分とも
  2.200 に収束（修正前は short 1.274 で未収束）。
- 壁厚キャップ（STAIR_WALL_CAP）: 階段帯（階段ラン列のセグメントを
  4.7mm 膨らませた帯）では「外形から 2.2mm より深い領域」を
  キャビティへ和集合し、壁厚を 2.2mm 以下に制限した。広げる方向
  のみの変更なので基板+0.5 は割らない。背面ネジ・吊りボスの周りは
  保持円盤（タップ半径+1.5）で除外し、ネジの肉を残す。
  結果: 本人が指摘した箇所では、v2.2 のバンドはレッジ内側
  （ledge_in_q）が outline2 の深い溝の谷を保持して三角形の指状に
  基板側へ張り出していた（タブ脇 x≈40 で先端 y≈37 付近まで、
  guide_band_stair_compare.png 左上）。v2.3 では内側境界も矩形
  ステップになり指は消滅。タブ部の壁（外形フェイス −2.05 対
  キャビティ面 +0.15）は 2.20mm。check_v21 §8（保持円盤を
  除外した階段帯サンプリング）では p99 が short 2.19／long 2.36、
  最大は short 2.88／long 3.10 で、いずれも蹴上コーナーの対角点
  （理論上限 2.2×√2≈3.11）。フェイス対フェイスは全段 2.2。
- 外形フェイスの変化（v2.2 比）: short タブ −2.20→−2.05。
  long の背面側踏面（図面 177.222）は v2.2 ではブリッジの引っ張りで
  179.42 まで膨らんでいたが、図面フェイスどおり 177.22 に戻った
  （壁厚は 5.1 で余裕あり）。外形面積は short 15210→15107、
  long 19169→19010。
- ネジ計画の変化: short の背面ネジが 1本→2本（(111.54, 29) を追加
  検出。キャビティが綺麗になり背面リムの湾が成立したため）。
  long は従来どおり3本、吊りボスは両半分とも従来と同じ位置。

**3. 記録の訂正（左右間最接近）**

- §17.11 の「11.74mm」は check_v21.py §6 の原点混用による誤りで、
  正しくは 15.59mm（§17.11 に訂正注記済み）。§6 の原点は
  build_case と同じ図面レイアウト（相対 x オフセット 0、
  dy=183.414）に修正した。v2.3 の外形での §6 実測は
  外形↔外形 16.40mm（基板↔相手外形 19.10／19.12、基板↔基板 21.81）。

**4. 検証（check_v21.py 全項目＋verify_stl）**

- フレーム下降スイープ干渉 0（両半分・全高さ）。
- §2 基板→フレーム下帯内壁クリアランス: 最小 0.499／p1 0.500／
  中央値 0.500／0.3 未満 0件（両半分、outline3 基準で全面 0.5）。
- パーツ間干渉 全10ペア 0、バンド着座スイープ 0、ネジ経路 0、
  スロット上壁あり、プレートのスリバーなし（最小正距離
  short 3.21／long 2.38）。
- パドルの残件は v2.2 から不変: long タクト1 の静止干渉
  39.15mm³／押下 34.50mm³（エンベロープ側の保守性の可能性、
  実物確認項目 §17.9 のまま）、傾き ±2.5° で軽い接触
  （short タクト2 1.09／long タクト2 1.23）。
- §8 ソケット円盤: 中心→キャビティ面の最小は short 9.09／
  long 4.58（要求 3.25 以上）。
- ビルド時診断のクリップ済みキャビティ（バンド用）で 0.3 未満の
  サンプルは、階段帯からは消え、残りは全て背面リム
  （基板背面縁が外形に 0.25〜0.65 まで迫る箇所の MIN_WALL 挙動、
  v2.1 以来の既知事項）。実干渉は §4 の band×pcb=0 で否定済み。
- verify_stl: 本体8点＋試作片は単一ソリッド／最小 z=0／
  non-manifold 0。例外は既知のものだけ: trial_corner_band
  （パドル窓で2ピースに分かれる、v2.2 と同じ）と trial_all
  （11ピース統合ファイル）。
- trial_all_v22.stl は v2.2 の配置スロットを再利用して再レイアウト
  （占有 169.9×168.7mm、ピース間最小間隔 3.9mm、各ピースの体積は
  個別ファイルと一致）。配置図 guide_trial_all_v22.png も更新。
- バンド階段部の修正前後比較: guide_band_stair_compare.png
  （レッジ帯断面。v2.2 の内側境界の三角形の突起が v2.3 では
  矩形ステップになっている）。

**5. 留保（実物確認待ち）**

- short 段1（前面コーナー歯）はアンカーAのみに基づく（Bと 1.6mm
  乖離）。short タブ先端 0.65 は上記の判定による。long 段5/6の境
  （x=103.4）は short の蹴上位置に合わせた推定。いずれも
  trial_stair_band／trial_all の実物当てで判定する。
- キャビティ（outset の円弧）が蹴上コーナーで外形を突く微小成分
  （両半分とも各蹴上約1.4mm²）は、ソリッド生成上は無害
  （外形プリズムの外側の減算は no-op で、バンド側はクリップ済み
  キャビティを使う）ため残置した。

### 17.13 v2.4: 左右ドッキング（案2）の実装（2026-11-04）

本人決定: DOCKING_STUDY の案2（継ぎ目整形）を採用する。ただし
**磁石は入れない**（本人指示「磁石はいらんよ」）。バーマグネットの
ポケット等は一切作らず、噛み合いの形だけで一体型風にする。
根拠検討は design/DOCKING_STUDY.md。

**1. 変更内容（build_case.py に seam_stair を追加）**

- v2.3 の量子化外形を土台に、階段帯（x 3.2〜113.7）の輪郭だけを
  基板ステップ（make_outline3 の STEPS が正本）から作る階段状
  プロファイルで置き換えた（cut/fill ポリゴンの差集合・和集合）。
  - 踏面フェイス = 基板レベル ∓ 2.7 で統一（= キャビティ 0.5 + 壁 2.2。
    SEAM_PROJ）。段1〜4 の両半分が対象。
  - 蹴上フェイス = 基板の共有境界 x（26.6/46.2/65.2/84.4、両半分で
    同一位置）。v2.3 では両半分とも歯が x 方向に ±2.85 太り、歯同士が
    5.7mm 重なっていたのが噛み合わない主因だった（DOCKING_STUDY §2）。
  - 実測では踏面の大半は既に ±2.7 の位置にあり、実際の移動は主に
    蹴上の棚（コーナーの張り出し）の切り取り: long の段2/3 境の棚は
    y 方向 9.5mm 分を切り戻した。外形面積は short 15107→15099、
    long 19010→18927。
- 背面ラン（x>=84.4、段5+6 を1ランに統合）は DOCKING_STUDY 案2 の
  例外扱いをそのまま実装した:
  - long は現行フェイス 177.222 を維持（整形は x<84.4 で打ち切り）。
    理由はフレームのウェル制約: ウェル境界（ポケット+0.25）は
    x 90〜112 で y=177.47 にあり、現行フェイスを既に超えている
    （リム帯は現行でも背面ランで開いている）。フェイスを段5の
    統一位置 174.30 へ引くと、この開きがさらに広がる。
  - short は段5の統一フェイス 21.76（現行 T1 と一致）を 2.0mm
    延長した 19.76 とし、long の現行フェイスとの隙間もドッキング
    位置で約 0.3 に合わせた（SEAM_BACK_EXT）。
- 階段帯以外は v2.3 のまま: キャビティ（outline3+0.5、壁厚キャップ
  含む）、パドルスロット、USB/TRRS 開口は不変。背面ネジは両半分とも
  v2.3 と同一位置（short (111.54,29)/(110.24,129)、long 3本）、
  吊りボスも short 1か所 (52.62,133.7) で不変。
- 波及で変わるもの: スイッチプレート外周は設計ルール（外形−2.25 の
  キャップ）どおり階段側で追随した。fin-fix のノッチ数は short
  4→3 件（外周面積 11681→12000）、long 1→4 件（15508→14748）。
  ノッチ化自体は v2.1 以来の確立した扱い（保持できない縁ストリップを
  開口側へ吸収）で、スイッチ穴の位置・寸法は不変。フレームの
  プレート帯域内壁（ch）もプレート外周から再計算されるため整合する。
- 壁厚キャップ用のラン列（halves["chain"]）はシーム側のラン列に
  差し替えた（stair_strip の対象を新しいフェイス位置に合わせる）。

**2. ドッキング検証（新設 check_dock.py、実 STL から計測）**

- シルエット（side_band z=1.5 断面の外周）同士を図面レイアウトの
  向きのまま寄せると接触オフセット D_c = 157.480。ドッキング位置
  D* = D_c + 0.30 = **157.780**（検討時の到達値と一致）。
- D* での継ぎ目隙間プロファイル（0.25mm 刻みサンプリング）:
  主階段（x 26.6〜84.4）で **最小 0.300／平均 0.363／最大 0.410**、
  背面ラン（x 84.4〜113.7）で 0.307／0.320／0.723。
  段1（前面コーナー歯、x 3.2〜26.6）だけは 3.33 で均一に開く:
  これは基板同士でもテッセレーションの必要 dy が主階段より
  3.03 小さい（前面の歯が届かない）ことに由来する基板固有の値で、
  ケース側の整形では埋まらない（検討時の「ランアウト最大約1.4」は
  主階段両端の遷移部を指す値で、段1 踏面そのものは 3.33 が実測）。
- 全体寸法: D* で y スパン **301.14mm**（本家 296.7、+4.44）、
  x スパン 114.29mm（本家 114.2）。接触（D_c）では 300.84mm。
- 実 3D 干渉: 組立座標の全パーツ左右間干渉は D* で 0.000mm³、
  D_c−0.5（押し込んだ状態）では 550mm³（接触検出の裏付け）。
- 描画: guide_dock_v24_3d.png（ドッキング状態の斜め図）、
  guide_dock_v24_top.png（上面図＋継ぎ目拡大、render_dock_v24.py）。

**3. 仮想検証（check_v21.py 全項目、v2.3 との比較）**

- フレーム下降スイープ 0、§2 クリアランス最小 0.499／中央値 0.500／
  0.3 未満 0件、パーツ間干渉 全10ペア 0、バンド着座 0、ネジ経路 0、
  スロット上壁あり — いずれも v2.3 と同等。
- §8 壁厚キャップ: 階段帯の壁厚は最大でも short 2.208／long 2.200
  （v2.3 は蹴上コーナー対角で 2.88／3.10）。蹴上を共有境界に
  揃えたことで、コーナー対角の膨らみも消えて均一 2.2 に収束した。
  ソケット円盤は short 9.08／long 4.58 で不変。
- パドルの残件は v2.3 から不変（long タクト1 静止 39.15／押下
  34.50、傾き時 1.09／1.23、実物確認項目のまま）。
- §6 図面レイアウトでの左右間最接近は 16.41mm（v2.3 は 16.40。
  short 段1 フェイスが 7.881→8.30 に 0.42 引いた分）。
- verify_stl: 本体8点＋試作片は単一ソリッド／最小 z=0／
  non-manifold 0。例外は既知のものだけ（trial_corner_band の
  2ピース、trial_all の11ピース）。

**4. 既知の特性（案2 の幾何に由来）**

- 蹴上フェイスが基板の蹴上面と同一平面にあるため、キャビティ
  （基板+0.5 のバッファ）が蹴上平面を 0.5 越える成分が各蹴上に
  1.2〜4.0mm² ある（short 計 11.46／long 計 8.48mm²、階段側のみ。
  全体の突き出しは背面リム由来の既存分と合わせて short 132.94／
  long 120.42mm²）。ソリッド生成上は §17.12 と同じく無害
  （外形プリズムの外側の減算は no-op）だが、フレーム下帯
  （z 5.7〜9.5）では谷側の壁面が蹴上位置だけキャビティ面
  （外形面から 0.5 奥）になる。バンド／トレイは外形追随のため
  外面の継ぎ目は設計どおりで、ドッキング時は相手の歯がこの
  谷を覆う。単体使用時に谷の奥で基板の蹴上縁が 0.5 奥に
  見えるだけの見た目の話であり、干渉・強度の問題はない
  （§1/§4 で干渉 0 を確認済み）。

**5. 試作まわり**

- trial_stair_band_short/long は新しい階段形状で再生成済み。
  クリップ範囲は継ぎ目に関わる全ラン（全踏面・全蹴上）を含むため、
  左右の試作片同士を机の上で向き合わせれば噛み合いを実物で
  確認できる（磁石はないので、手で寄せて継ぎ目を見る）。
- trial_all_v22.stl は v2.4 のピースで再レイアウト済み
  （配置スロットは v2.2 のものを再利用、占有 169.9×168.7mm、
  ピース間最小間隔 3.9mm、体積は個別ファイルと一致）。
  配置図 guide_trial_all_v22.png も更新。
- 実物確認の残件は従来分（§17.12 の留保、パドル long タクト1）に
  ドッキングの噛み合いが加わる。いずれも trial_all の実物当てで
  判定する。

### 17.14 v2.4.1: プレート階段縁のブリッジ（穴サポート不足の修正、2026-11-04）

発端は本人の目視指摘（上面図で「short の中央部分、スイッチプレートの
階段側の端が欠けている」）。数値でも確認した欠陥であり、本節の方法で
測ると不足は階段列の穴に集中していた。

**1. 測定方法（新設 check_plate_ring.py、リングテスト）**

- 各スイッチ穴の中心から半径 8.2mm の円周上 24 点（15°刻み）を、
  書き出し済みプレート STL の実材内にあるかで数える。穴（14.15 角）の
  角方向の 4 点は穴内部に落ちるため、満点は 20/24。
- v2.4 のベースライン: 不足は short 3 穴（(36.6,9.3)=8、(55.6,18.8)=12、
  (74.7,23.6)=11）と long 4 穴（(93.7,167.4)=7、(55.6,153.2)=11、
  (17.5,150.8)=12、(74.7,157.9)=12）。他の穴は全て満点。

**2. 原因の切り分け（2D 再現が STL のスコアと全穴で完全一致）**

- (a) プレート外周がポケット（スイッチ配置）の歯形に沿うため、階段列
  の穴では縁が内側へ入り込み、リング点が外周の外に出る（例: short
  (36.6,9.3) の 0°/180°/195°/345°、long (93.7,167.4) の 150°/165°/180°）。
- (b) fin-fix の moat: 穴が外周 0.5mm 以内に近づくと発動し、穴の全周に
  0.5mm の堀を切るため、角に隣接する 8 点（30°/60°/120°…）が常に
  失われる。不足穴は fin-fix 発動穴（short 3 件・long 4 件）と完全一致。

**3. 変更内容（build_case.py に PLATE_BRIDGE を追加）**

- ネジ計画の確定後・fin-fix の前に、階段側の外周へ橋渡しフィルを
  和集合する（歯に沿わせず湾を塞ぐ）。
  - 追加範囲の上限は、階段側では外形キャップ（外形−2.25）ではなく
    フレーム下帯内壁（cavity_full）から 0.2mm の隙間を残す範囲
    （PLATE_BRIDGE_CLR）。欠陥方向では外形キャップが先に効いていた
    （例: (36.6,9.3) の 0° は外形キャップで半径 7.39 止まりだが、
    cavity 基準では 9.94 まで可）。ケース内に収める最小ガードとして
    inset(outline, 0.5)（PLATE_BRIDGE_GUARD）を併用。
  - 効かせる帯は基板階段プロファイル（make_outline3 の STEPS）から
    15mm 以内（PLATE_BRIDGE_STRIP）。階段側以外は変えない。
  - フィル量: short 181.0mm² のうち本体に接続した 80.8mm² を採用。
    背面ラン東端（x 107.2〜113.8, y 29.6〜45.0）の 100.2mm² は一点
    接触のみで分離するため不採用で、その部分は v2.4 のまま（穴
    サポートには無関係）。long は 115.6mm² の全量が接続。
  - fin-fix 発動は short 3→0 件、long 4→1 件に減少。プレート体積は
    short 10238→10486（+248）、long 12179→12468（+289）。
  - フレームはプレート帯域の内壁（ch）がプレート外周から再計算
    されるため階段帯だけが追随（体積 short −118／long −173 で、
    接続フィル面積×板厚と一致）。ケース外形は不変。
  - 背面ネジ・吊りボスは変更前の外周で確定しており v2.4 と同一
    （short 背面 (111.54,29)/(110.24,129)・吊り (52.62,133.7)、
    long 背面 3 本）。穴位置・穴寸法（14.15 角）も不変。

**4. 検証**

- リングテスト（実 STL）: **short 28/28 全穴満点、long 34/35 満点**。
- check_v21 全項目は v2.4 と同等: フレーム下降スイープ 0、§2
  クリアランス最小 0.499／中央値 0.500／0.3 未満 0 件、§4 パーツ間
  干渉 全 10 ペア 0（プレート×フレーム／バンドの新規干渉なし）、
  バンド着座 0、§5 ネジ経路 0、§6 左右間最接近 16.41、§8 壁厚
  最大 short 2.208／long 2.200・ソケット円盤 short 9.08／long 4.58。
  パドルの既知残件（long タクト1）も不変。
- check_dock は v2.4 と完全一致（D*=157.780、主階段の継ぎ目
  最小 0.300／平均 0.363／最大 0.410、D* で干渉 0）。
- verify_stl: プレート両半分とも単一ソリッド／最小 z=0／
  non-manifold 0（フレーム・トレイ・バンドも同様）。
- 試作まわり: trial_plate_holes はバイト一致で不変。他の試作片も
  形状不変（体積一致）で、trial_all_v22.stl もバイト一致のため
  再レイアウト不要。

**5. 残差: long (93.7,167.4) は 9/24（v2.4 の 7 から改善）**

- この穴は実測ソケット L21（ドーム重心 (93.70,167.52)）で実在する
  が、outline3 の段5 踏面（y=171.6）から中心が約 4.2mm しかなく、
  14.15 角穴の +y 側の縁は再構成した基板の縁を約 2.9mm 越える。
  165°/180° はブリッジで回復したが、残りは上限に阻まれる:
  - 75°/90°/105° の 3 点: 必要な半径 8.2 に対し、到達上限は cavity
    基準で 4.46（中心から cavity 面まで 4.66 − 隙間 0.2）。外形
    キャップ（−2.25）でも 90° は 7.53 までで、どちらの上限でも
    届かない。
  - 角隣接の 8 点: 穴の縁が到達可能なプレート縁を越えるため
    fin-fix が発動し続け、moat が残る。moat は v2.1 以来の確立した
    扱い（保持できない縁ストリップを開口側へ吸収）であり、本修正
    では変更していない。回復には fin-fix の例外扱いが別途必要。
  - 段5 踏面レベルは §17.12 の推定留保であり、試作の実物当てで
    基板の縁が外側と分かれば cavity 自体が動き、到達範囲が広がる
    可能性はある。

### 17.15 v2.4.2: 輪郭の直線化（形状の乱れ一掃、2026-11-04）

発端は本人の目視指摘 5 件（GitHub 3D ビューアのスクリーンショット）:
(1) top_frame_short の外側端リップ（y≈143 側）のノッチ・段差
（x≈55〜114、特に x≈68 の垂れ下がりと x≈95〜114 の角の段差）、
(2) top_frame_long の外側端（y≈0 側）リップ下面の歯状突起
（x≈72／x≈100）、(3) switch_plate_long の階段×背面角
（x≈100〜113、y≈163〜176）の櫛状の割れ（スリット＋細いプロング
2 本）、(4) side_band_short の外側端リム内側の大きな乱れ
（x≈55〜114）、(5) side_band_long の外側端リムの小さな突起
（x≈55〜90）。あわせて「直線であるべき縁は全パーツで全部直す」
「最終形で試作セットを作り直す」の追加指示があった。

**1. 根本原因**

- `template/make_outline3.py` は階段帯以外を outline2（未分割
  パネルのスキャントレース、short 746 点／long 189 点）の点列の
  まま流用していた。非階段チェーンに残ったトレースの失敗:
  - short 端辺: 直線ラン（y≈138.1）の後に谷（(71.02,135.92)）、
    偽の plateau（x 84〜98、y 140.5〜140.8）、MCU ピン列部で境界が
    y=132.1 まで内側へ潜る絡まり。
  - long 端辺: MCU 部の縦スパイク対（(85.71,4.14) 等、直線から
    0.98mm の落ち込み）。
  - short 背面: タクト付近のジグザグ（ fitted 直線から最大 1.31mm）。
  - long 背面: 切り欠き壁の揺れ（最大 0.48mm）、TRRS タブ上面が
    ジャックのフットプリントをなぞった落ち込み（最大 1.36mm）、
    y≈58 の段差部の偽の細いスパイク（最大 1.75mm）。
- 実基板の裏面写真（`user/files/7378_1_r3ix.jpg` short／
  `7379_0_xzt9.jpg` long）で、端辺・前面辺とも「1 本の直線＋
  小さな半円ノッチ 1 個（基板内側への切れ込みのみ）」であることを
  確認した。plateau／谷／絡まり／スパイクはいずれも写真に存在
  しない（未分割パネルスキャン由来＋ピン列部でのエッジ探索失敗）。
- 派生形状への伝播が指摘 (1)(2)(4)(5) の正体: cavity（=pcb＋0.5）
  と ledge（=pcb−1.5、バンド内側薄壁）がノイズを継承し、フレーム
  のリップ／バンドのリムに増幅されて出ていた。2D ポリゴン頂点の
  直線残差（最大）は cavity 端 short 6.33／long 4.76、ledge 端
  short 9.09／long 8.38。
- 指摘 (3) は別系統で、§17.14 の橋渡しフィルが階段×背面角に作った
  歯（tooth）: 範囲 (107.24,164.15)-(113.77,171.10)、44.75mm²。
  最寄り穴 (93.7,167.4) まで 13.5mm あり、リング盤（r=8.2）の外
  なので縁サポートに無寄与。その上下の bite は pre-bridge の
  ポケット切り欠き（outset(pocket,3.0) ∩ inset(outline,2.25)）
  由来で、§17.14 のエンベロープ上 bite を埋めることはできない。

**2. 変更内容**

- (a) `template/straighten_outline3.py`（新規）: outline3 の端辺・
  前面辺を直線フィットで再構成する（make_outline3.py は不変、
  階段帯は §17.12 のまま。階段ストリップの対称差 0.0000 で無傷を
  検証）。フィット規則: クリーンな直線ランの点で最小二乗し、真正
  点の外側への突出が 0.1mm 以下になるようクランプする
  （＝キャビティクリアランスは真正トレース点に対して ≥0.4mm）。
  - short 端: y = 138.008 + 0.00387x（真正スパン x 8〜80 の最悪
    クリアランス 0.50）。角 C1=(3.60,138.02)、C2=(113.07,138.45)。
  - short 前面: x = 3.003 + 0.00436y（クランプ shift 0.078、最悪
    クリアランス 0.40、(3.10,45.00) で拘束）。
  - long 端: y = 5.110 + 0.00012x（fit 5 点、shift 0.126）。
    C1=(2.85,5.11)、C2=(113.21,5.12)。
  - long 前面: トレース自体が 1 直線だったため x = 2.833 +
    0.00263y を採用。
  - 監査可能な除外（写真根拠で「基板の縁ではない」と判断し、
    クリアランス保証の対象から外した点）: short 端の plateau
    区間（新直線から最大 2.50mm 外側）と MCU 絡まり部、long 端の
    (85.71,4.14)（新直線に対して −0.48mm）。いずれも写真では
    その位置に基板の縁は存在しない。
  - 点数: short 110→47、long 115→70。面積: short 13630.2→
    13729.4、long 16351.1→16505.2。
- (b) `template/straighten_back.py`（新規）: 背面チェーンも直線化。
  - short 背面: x = 113.561 + 0.001748y（ラン 2 点
    (113.78,125.10)/(113.64,45.00) を通る）。端×背面の角は両直線
    の交点 C3=(113.80,138.45) に再計算。ジグザグは全て直線の
    内側にあったため保証はラン点で poke 0。
  - long 切り欠き壁: x = 103.431 + 0.000331y（LSQ＋クランプ
    shift 0.173、真正点の最大 poke 0.273→0.1 以下）。
  - long 背面プレーン（タブ面 3 つ＋本ランは同一平面）:
    x = 113.175 + 0.002620y（fit 5 点の最大 poke 0.002＝ほぼ
    共線で、同一平面であることの裏付けになった）。タブ A
    （y 107.86〜113.10）／TRRS タブ（y 77.92〜85.91）／y≈58 の
    段差を、壁ラインと背面プレーンの間の矩形として再構成。
    端×背面の角は C2'=(113.19,5.12)。
  - 保持したもの: 角の半径ファン（long 階段×背面 y 164.45〜
    164.88、short 末端 y 29.95〜45）は滑らかな半径トレース
    （偏差 ≤0.05）であり直線ではないため対象外。ブロック縁
    x=103.40 は元々直線。
  - 最終点数: short 41、long 59。面積: short 13740.5、long
    16519.7。ソケット余裕は不変（short 最悪 8.58=S26、
    long 4.08=L21）。
- (c) build_case.py にプレート角クリーンアップを追加: §17.14 の
  橋渡しフィル追加分のうち、階段×背面角ゾーン（最後の段
  `PCB_STEPS[half][-1]` の x 以遠、踏面レベル ±0.35mm）に入る
  分を除去する。long で 44.8mm²（tooth ちょうど）を除去し、
  short は 0.00 で厳密に無変化（2D ポリゴンで事前検証済み）。
  §17.14 のエンベロープ（cavity−0.2）は不変。
- (d) build_case.py に背面ネジの最小間隔ガード
  （`BACK_SCREW_MIN_SEP = 12.0`）を追加: 背面直線化で slack が
  帯域境界の両側で同点タイになると、隣接帯域が境界付近に寄って
  ボス同士が重なる配置（y=59 と y=62）を選ぶことが判明したため、
  既配置から 12mm 以上離れた候補を優先する（候補が尽きる場合は
  従来どおり）。発動は long の第 2 帯域のみ（35→26 候補）。

**3. 辺ごとの偏差（最大、mm、旧→新。PCB チェーン／派生ポリゴン頂点の fitted 直線からの残差）**

| 辺 | short | long |
|---|---|---|
| cavity 端辺 | 6.33 → 0.00 | 4.76 → 0.00 |
| ledge 端辺 | 9.09 → 0.00 | 8.38 → 0.00 |
| cavity 前面辺 | 0.09 → 0.00 | 0.00 → 0.00 |
| PCB 背面ラン | 1.31 → 0.00 | — |
| PCB 切り欠き壁 | — | 0.48 → 0.00 |
| PCB 背面プレーン（偽スパイク含む） | — | 1.75 → 0.00 |
| TRRS タブ上面 | — | 1.36 → 0.00 |

- プレート階段×背面角（long、box (97,158)-(114.4,177.3)）: 境界
  頂点 46・微小セグメント（<0.3mm）37 → 35・28。残る微小
  セグメントは角の半径ファンのサンプリング（0.03〜0.05mm 刻み、
  滑らかな弧）で、スリット／プロングは消滅した（図
  `fig_v242_zoom_plate_long_corner.png`）。short の対応角は
  元々頂点 5・微小 0 で無変化。
- ケース外形・ポケット・プレートの端辺／前面辺は DXF 由来で
  元々直線（偏差 0）。全 8 パーツの上面図フル周スキャン
  （`fig_v242_top_all.png`）でも残存する櫛・突起・スリット状の
  乱れはなかった。
- クリアランスへの影響: フィットは上記のクランプにより真正
  トレース点に対して cavity ≥0.4mm を保証する。実測は §5 の
  check_v21 §2（最小 0.499）のとおり。

**4. 数値が変わった項目（理由付き）**

- long 背面ネジ: v2.4.1 の (111.5,7.0)/(111.5,91.0)/
  (111.5,117.0) M3 → **(111.5,59.0)/(111.5,71.0)/(111.5,117.0)
  M3**（slack は全て 2.09）。理由: (i) 旧 (111.5,7.0) の「湾」は
  端の絡まった角が作った見かけの余地で、正しい直角コーナーでは
  M3 ボスが食い込むため成立しない（端直線化のみの中間形では
  プランナが M2 (110.42,61.0) slack 1.00 に正しく振り替えた）。
  (ii) 背面直線化で slack が均一化し、第 1 帯域の最大は段差部
  の湾（y=59）に移った。(iii) 帯域境界への集中は (d) のガード
  で解消。実基板に対しては新配置が正しい。short は不変
  （背面 (111.5,29.0)/(110.2,129.0) M3、吊り (52.6,133.7)）。
- プレート体積: long 12468→12401（tooth 除去 −44.8mm²×1.5 が
  主因）、short 10486 のまま（背面直線化の追随で −0.6）。
- ケース外形・全体幅・ドッキング幾何は不変（下記 check_dock）。

**5. 検証（最終形）**

- check_v21 全項目が v2.4.1 と同等: §1 フレーム下降スイープ 0、
  §2 クリアランス最小 0.499／中央値 0.500／0.3 未満 0 件、
  §4 パーツ間干渉 全ペア 0・バンド着座 0、§5 ネジ経路 0
  （新配置 59/71/117 とも screw reach 6.3 ≤ tap_depth 6.6）、
  §6 左右間 outline↔outline 16.41、§8 壁厚最大 short 2.208／
  long 2.200・ソケット円盤 short 9.080／long 4.580。パドルの
  既知残件（tact2 tilt+ のフレーム接触）も不変。
- check_dock は v2.4.1 と完全一致: D*=157.780、主階段の継ぎ目
  最小 0.300／平均 0.363／最大 0.410、全体幅 301.14、D* で
  干渉 0。
- check_plate_ring: short 28/28・long 34/35 で v2.4.1 と同一。
  残差穴 (93.7,167.4) は 9/24 のまま（§17.14 §5 の上限どおり、
  tooth 除去はリング盤の外なので無影響）。
- verify_stl: 本体 8 点すべて単一ソリッド／最小 z=0／
  non-manifold 0。
- 図: `fig_v242_zoom_frame_short_end.png`／`_frame_long_end`／
  `_band_short_end`／`_band_long_end`／`_plate_long_corner`／
  `_plate_short_corner`（前後ズーム 6 枚）と `fig_v242_top_all.png`
  （全 8 パーツ上面図）で、指摘 5 箇所の解消を確認した。
  なお switch_plate_short のスラブは吊りボスの分だけローカル
  z が 2.15〜3.65 にある（書き出し仕様は従来どおり）ため、その
  ズーム図は z=2.90 断面。

**6. 試作セットの再生成**

- 試作片 9 ファイル（trial_stair_band 両半分、trial_corner_tray／
  band／frame 両半分、trial_plate_holes）は最終形から再生成した
  （build_case.py の通常エクスポート）。体積は band 系を中心に
  v2.4.1 から変化（例: trial_corner_band_short 687.7→538 は
  ledge ノイズの除去分）。
- trial_all_v22.stl は make_trial_all.py で再レイアウト: 11
  ピース、全ピース watertight／z=0 着座、最小間隔 3.90mm、占有
  x[2.0,171.9]・y[2.0,170.7] で A1 mini の 180×180 内。
  trial_corner_band が 2 ソリッドなのは従来どおり（角箱が
  バンドの 2 つの塊を切り取るため。両塊とも watertight な実体で、
  trial_all 内では別ピースとして配置される）。
- staging から旧世代の trial_boss_bottom_*／trial_boss_frame_*
  （現行ビルドでは生成されない残存ファイル）を削除した。

**7. 観察事項（本ラウンドでは変更しない、未確認）**

- フレーム下帯の背面壁は、基板背面（x≈113.7）とケース外形
  （x=114.29）の間が狭く、cavity_full 基準で 0.0〜0.1mm の膜状に
  なる区間がある（実測: z_local=1.0、y=60 で壁 [114.17,114.28]、
  y=100 では断面に現れない）。v2.4.1 以前からの性質で、本
  ラウンドの直線化はこれを均一化したが厚くはしていない。
  基板モデルの x 方向の置き方（前面マージン約 3.1 に対し背面は
  約 0.6）の再検討が要るなら別ラウンドで扱うこと。

### 17.16 v2.4.3: プレート角穴の開口復元（2026-11-05）

本人の目視指摘（「コーナーのスイッチ、これじゃはまらない」）を受けて
実測し、生成コードで直した記録。※本人が指していたのは第一義には
パドル側（§17.17）だったが、このプレート穴の欠陥も実在した。

- **実測（欠陥の確定）**: switch_plate_long の穴 (93.72, 167.44)
  （階段×背面の角）だけ、板厚中央断面で中心を通る開口幅が
  x=15.15 / y=19.57（親側の別測定では x 15.0 / y 22.5）に拡大して
  いた。設計は 14.15 角。他の全穴（short 28＋long 34）は正常。
  MX スイッチのパチ留めタブが掛かる +y 側の縁が無かった。
- **原因**: fin-fix の堀（§17.14）。この穴は fin-fix 前の
  フットプリントでは開口 14.15 角ちょうど（全周に壁あり）だったが、
  穴の +y 辺〜外周の壁が 0.452mm しかなく、0.5mm の堀が壁を断ち
  切って開口が外側の切り欠きとつながった。long で fin-fix が発動
  した角穴はこの1つだけ（short は 0）。§17.14 の橋渡しフィルでは
  直せない: エンベロープ上限（cavity−0.2）はこの穴の位置で
  y=171.9 までしか届かず、穴の上端 174.52 に届かない（基板段5踏面
  y=171.6 が上限の源泉。穴自体が基板外周より外にはみ出す配置）。
- **修正**: build_case.py の fin-fix の後に復元ステップを追加。
  fin-fix が発動した角穴のうち、fin-fix 前のフットプリントで中心
  走査の開口が設計値（14.15）±0.05 だった穴（＝全周に壁があった
  穴）だけ、堀が削った材料（fin-fix 前の外周 plate_bnd の内側のみ）
  を戻す。もともと縁に開いた notch 型の穴は対象外（堀が残る）。
  戻す材料は plate_bnd の内側だけなので §17.14/§17.15 の
  エンベロープは超えない。定数 FIN_RESTORE_TOL=0.05、ヘルパー
  opening_at() を新設。復元量は collar 227.2mm²（穴の内側を含む
  ため、正味の材料増は体積で +40.4mm³）。
  - 代償として、この穴の +y 辺の壁は 0.45mm 厚で復活する
    （fin-fix が消したかったフィンそのもの）。ただし穴を 14.15 に
    閉じるにはこの壁が必須で、0.4mm ノズルの1周分として印刷可能
    な範囲。下のフレームのウェルにも支えられる。実物での確認は
    試作・本印刷で行う。
- **検証**:
  - 新規 check_plate_openings.py（全63穴の開口幅 x/y を板厚中央
    断面で測定）: **全穴 14.15±0.00** で合格。v2.4.2 の STL に
    対してはこの角穴だけを NG（x15.15/y19.57）として検出する
    ことも確認済み（チェック自体の健全性）。
  - check_plate_ring: short 28/28・long 34/35（v2.4.2 と同数）。
    残差穴 (93.7, 167.4) は **9/24 → 17/24 に改善**（+y 辺の縁が
    戻った分。満点にならないのは基板踏面より外にはみ出す配置の
    ためで、従来どおり実物当て待ちの留保は残る）。
  - switch_plate_long の体積: 12400.8 → 12441.2（角周辺のみ）。
    switch_plate_short は不変（10485.8）。
  - 比較図: fig_v243_plate_corner.png。
- **試作片への影響**: 角穴 (93.72, 167.44) はどの試作片の切り出し
  範囲にも入らない（trial_plate_holes は独立生成の合成ピース）。
  trial_all はプレート関係では不変。ただし §17.17 のフレーム修正で
  trial_corner_frame 両半分が変わったため、trial_all_v22 は最終形で
  再レイアウト済み。

### 17.17 v2.4.3: パドル総点検とマイコンまわりの見直し（2026-11-05）

本人の追加指示2件（パドルがはまらない気がする／マイコンが中央に
寄っている気がする）への実測ベースの回答と、見つかった実欠陥の修正。

**A. パドル総点検 — ケース側の修正は不要だった**

- 実測寸法（PADDLE_MEASUREMENTS: 全長27.3／ブロック 9.75×4.8×8.5／
  羽根込み幅8.7・羽根は軸厚2.5でブロック前面寄り／バー厚2.7）から
  実モデルを作り直し（check_paddle_real.py、配置Bと同じ軸配置）、
  6タクト全てで静止／押下（−0.5z）／押下スイング（付け根軸で
  +1〜+4°）／ロール ±2.5°／挿入（垂直降下・軸方向スライド）を
  トレイ・バンド・フレームと干渉測定した。
- **結果: 静止・押下・スイング・ロール・垂直降下は全タクト全て
  0.00mm³。** 羽根の高さ方向の推定を z 5.0〜7.5 にずらした感度
  ケースでも 0.00。本人の「はまらない気がする」はモデル上は
  裏付けられなかった（クリアランスは設計どおり各所 0.6mm:
  バー↔スロット y・z とも ±0.6、羽根↔バンド窓 片側 0.6）。
  実物で渋い場合は印刷公差側の問題として試作片で判定する。
- **旧残件の訂正**: §17.2 以来「不変」として引き継いできた
  long タクト1 の配置Bエンベロープ干渉（静止 39.15／押下
  34.50mm³）は、現行形状ではエンベロープ自体でも **0.00** に
  なっていた（check_v21 §3 の実測）。outline2 時代の基板縁
  （タブ脇 x=103.32 へ後退）が outline3／直線化で是正された際に
  消えていたもので、§17.11〜§17.15 の「不変」の記述は再測定を
  伴わない引き継ぎだった。ここに訂正する。残る既知の接触は
  極端な傾き +2.5°（中央タクト）の 1.09／1.23mm³ のみ（従来
  どおり軽微・実物確認項目）。
- **挿入経路の特性（手順の注意として記録）**: 軸方向スライドは、
  ブロック後端がトレイ窓の内側端（x=97）に達する Δx=−4 以内
  から始めれば 0。それより手前（Δx=−6）から最終高さのまま
  滑らせるとブロック底（z=1.0）がトレイ床（上面 2.5）を擦る
  （14.40mm³、1mm あたり 7.2mm³）。1.5mm 浮かせれば全域 0。
  つまり「上から窓に置いて短く滑らせる」が正しい入れ方で、
  床の上を引いてくる入れ方はできない。形状変更はしていない。

**B. マイコンまわり — USB 開口が貫通していない実欠陥を発見・修正**

- **コネクタ中心 x の再検証**: §17.11 の 93.7 を、裏面スキャン
  （7373）から基板エッジ＋ピンピッチで独立に再計測すると
  short 93.5〜94.3／long 92.6〜93.5、列間隔も 15.1〜15.7mm
  （標準 15.24 と整合）。設計 USB_XC=94.0 は妥当で、開口幅 13 対
  コネクタ 8.9 の余裕（片側約 2.05）の中に全推定値が収まる。
  → x 位置の変更なし。
- **天井・床の確認（実モデル）**: フレームのモジュール上は
  z≈16.05 の表皮まで開いており、基板上面からの余裕は 8.8mm。
  トレイ床はモジュール域で最高 z=2.40（基板裏から 3.2mm の空間）。
  バンドのレッジは基板縁の下のみ。ピンヘッダ尾（〜2mm）や
  モジュール積層高さで当たる箇所は無し。
- **実欠陥: USB 開口が貫通していなかった。** 従来の開口カットは
  外面から 1mm の深さしかなく、端壁（内側ポケット面まで約
  4.2mm）の内側に **2.8mm 厚のウェブ**が残っていた（断面実測:
  short は y 139.4〜142.2、long は y 1.2〜4.0 が開口中心線上で
  材料。fig_v243_usb_channel.png）。外面には 1mm の窪みがある
  だけで、プラグは物理的に刺さらない状態だった。本人の
  「USB させないよ」は正しかった。v2.2 で開口の位置（x/z）は
  直したが、壁を貫く深さの検証が抜けていたのが原因。
  なお端壁が厚い理由は、ケース外形の長さ（テンプレ由来
  143.36／177.23）に対して基板端が約 4.4mm 内側にあるため。
  ドッキング全長も本家比 +4.44mm（check_dock）で、この差の
  主因は両端壁の厚みとみられる（外形自体は今回は動かさない）。
- **修正（フレームのみ）**: (1) 開口カットを外面から 7mm まで
  深くして端壁を貫通（USB_CUT_IN=7.0）。(2) 外面にプラグ
  ポケット（座ぐり）を追加: 幅 22（中心 ±11）、z 8.6〜15.3、
  深さ 3.0。プラグ胴体がポケットに入り、コネクタ面（基板端＋
  モジュールの出っ張り）までの実効距離が約 1.4mm になる。
  フレーム体積: short 23377.7→22969.6、long 33363.8→32955.6。
- **回帰チェック新設**: check_usb_channel.py（USB／TRRS の
  チャネル中心線を断面サンプルし、壁帯域に材料が無いことを
  確認）。修正後は USB（両半分）・プラグポケット・TRRS とも
  OK。TRRS は従来から貫通していた（背面壁が薄く、カット深さ
  6.5 で足りていた）。
- **未確認（実物計測が要る点）**:
  1. コネクタ中心の z: 開口 z は 9.8〜15.3。モジュールの実装
     方法（ピンヘッダ直付け／スペーサ使用）でコネクタ中心高さが
     約 ±1.5mm 動く。実装後に「基板上面からコネクタ中心までの
     高さ」を実測し、9.8〜15.3 の中央（12.55）から大きく外れる
     なら開口 z を寄せる。
  2. コネクタ面の出っ張り: モジュール端が基板端からどれだけ
     出るか（想定 0〜1.5mm）。ポケット深さ 3.0 は出っ張り 0 でも
     実効 1.4mm になる計算だが、実物でプラグの嵌合深さを確認。
  3. ピン列の端壁側の端のピン位置: バンドのレッジは基板縁の
     下だけにあることをモデルで確認済みだが、端から約 6.5mm
     以内の範囲はバンドの端壁ブロックと基板端が近接する。
     実装時に端寄りピンの尾がレッジに乗らないか目視確認。
- **試作片**: trial_corner_frame 両半分に USB 開口部が含まれる
  ため最終形で再生成済み（プラグの刺さり具合はこの角ピースで
  先行確認できる）。trial_all_v22 も再レイアウト済み。
- **全検証（v2.4.3 最終形）**: check_v21 は §1 スイープ 0・§2
  クリアランス最小 0.499・§3 パドル残件なし（傾き 1.09／1.23
  のみ）・§4 全ペア 0・§5 ネジ経路 0・§7 スロット上壁
  24.6〜41.6（保持不変）・§8 壁厚キャップ 2.208／2.200、
  check_dock は D*=157.780・継ぎ目 0.300〜・全長 301.14・干渉 0
  で v2.4.2 と同等。verify_stl は本体8点すべて単一ソリッド／
  z=0／non-manifold 0。不変パーツ: トレイ・バンド両半分と
  プレート short（体積一致）。

### 17.18 v2.4.4: 試作実物確認の是正一括（パドル不使用・タクト上面・マイコン裏面・階段実測、2026-11-05）

試作片の実物確認で出た指摘（パドルが全然はまらない／long 下段の
歯が入らない／short 上段の隙間が広い）を、本人のノギス実測と
注記付き写真（7455〜7466）で一括是正した。本人決定・訂正も多い
ため、確度を分けて記録する。

**A. パドル: 実測・原因・不使用決定（§17.17 の訂正を含む）**

- **実測（写真 7455/7456、ノギス、本人が正）**: 全長 25.2（旧
  モデル 27.3 は誤り）／バー幅 4.8／バー厚 2.8（旧 2.7）／ブロック
  高さ 8.6。8.2 の対応づけは羽根込み幅（推定・有力、端面写真の
  画素比でも整合）とブロック長さで競合し未確定。設計は安全側に
  羽根込み 8.7 を保持（PADDLE_MEASUREMENTS 追記2）。
- **タクトの向き（確認済み・本人確認）**: タクトスイッチは
  キースイッチ側（基板の**上面**）に付き、ボタンは上向き、押す
  方向は下向き。厚さ実測 6.8mm（写真 7463）は「基板裏面から
  スイッチ上面まで」の総厚で、上面から約 5.2mm 突出し、
  スイッチ上面はケース座標 z≈12.5（基板上面 7.3）、フレーム
  天面 16.1 まで約 3.6mm。内訳は本体約 3.3（推定のまま）＋
  プランジャ約 1.9。旧前提（裏面実装・先端 z=0.5）は全て誤り。
- **高さ不一致の数値（不使用の根拠）**: 上面前提では、パドルの
  チャネル内腔はタブ＋スイッチのスタック 6.8mm を要し、天板厚
  1.0〜1.8 を引くとブロック下端 zb ≥ 4.9〜5.7 が必要。一方バー
  （上端 zb+8.6）が試作スロット（v2.4.3: z 6.2〜10.1）を通る
  には zb ≤ 1.5。**矛盾は約 3.4〜4.2mm**（バーは壁位置で
  z≈10.7〜13.5 を要求し、スロット上端を約 3.4mm 上回る）。
  実寸モデル（check_paddle_real、配置スイープ）でも両立する
  配置は無かった。
- **「傾斜前提」は推定**: 純正ケースは約 5° 傾斜した基板前提で
  背面壁・スロットが作られており、フラットな本ケースでは合わ
  ない、という解釈。部品単体では証明できないため推定と明記。
- **本人決定: 金属パドルは取り付けない**（「高さが合わんで
  全然だった」）。v2.4.3 §17.17 の「パドルは問題なし」は旧推定
  モデル前提で**無効**と訂正する。ケース側を削って無理に合わせ
  る修正はしない。
- **タクト実体の干渉確認（新規）**: 実体ボックス（x 103.5〜
  109.5、y 各中心 ±2.5、z 7.3〜12.5）で確認したところ、フレー
  ムはスロット上端より上の材料が約 33〜38mm³ 当たっていた
  （上面実装は従来設計の前提外だったため）。逃げとしてスロッ
  ト上端を 10.6 → **13.2**（先端 12.5＋0.7）、内側端を 104.0 →
  **102.0** に広げ、全 6 タクトで干渉 0 を確認した。この逃げは
  次項プランジャ穴の土台になる。プレートは同ボックスで
  7.4〜10.4mm³ の接触（x 103.5〜107.2 の帯、プレートのタクト
  スロット縁）。ボックスが x 方向に保守的（実体は約 5mm 幅で
  中心 x 未実測）なため断定せず未確認に残す（H-3）。

**B. 代替機構（パドルなしでタクトを押す）— 候補比較と推奨案**

前提: タクトは上面・ボタン上向き、上面 z≈12.5、天面 16.1 まで
約 3.6mm。作動量は一般的なタクトで約 0.25〜0.5mm（推定）。

| 候補 | 指の動き | ストローク | ケース側変更 | 印刷・組付け |
|---|---|---|---|---|
| (A) 印刷製プランジャ（小ボタン）**推奨** | 天面の小ボタンを上から押す | ボタンの上下動で確保（下記寸法） | フレームに穴＋既存スロット／窓を壁に戻す | 小部品 6 個を追加印刷。落下防止はフランジで確保 |
| (B) フレームに窓を開けて指で直接押す | 窓から指先でボタンを押す | 指の入る窓が要り天面の開口が大きくなる | フレームに大きな窓 | 追加部品なし。ただしボタン面まで 3.6mm 深く、指が届きにくい |
| (C) フレーム一体ヒンジ式フラップ | 天面のフラップを押すと先端がボタンを押す | ヒンジのたわみで確保 | フレームに薄肉ヒンジ＋フラップ造形 | 一体で部品増なし。薄肉ヒンジの耐久と印刷方向が課題 |
| (D) 背面壁からの片持ちアーム | 背面側のレバーを押す | アームのたわみ次第 | 背面壁にアーム＋逃げ | 押す場所が背面で分かりにくく、構造が複雑 |

- **推奨 (A) の寸法の当たり**（次ラウンドでそのまま作れる形）:
  軸 Ø4.6／フレーム穴 Ø5.4（片側 0.4 逃げ）、フランジ Ø7
  （穴より大きく抜け止め）、キャップ Ø9×厚 3、天面 16.1 から
  キャップ上面が約 +1 出る高さにし、ボタン上面 12.5 と軸下端
  の間隔は静止時 0.3、押下量は作動量 0.5＋オーバートラベル
  0.5 見込み。中心は是正後のタクト中心（E）に置く。
- **スロット／窓の戻し方（記録のみ、今ラウンドは残置）**:
  プランジャ実装時に、フレームのパドルスロットカットと
  トレイ／バンドのパドル窓（merged_spans）を除去して壁・床を
  固体に戻し、タクト中心位置にプランジャ穴（Ø5.4）を開ける。
  A の逃げ（A 項のスロット拡大）は穴の土台として流用できる。

**C. マイコン／USB: 裏面実装＋RP2040 標準寸法（本人確定）**

- **本人確定**: マイコンはスイッチ側ではなく、ソケットのある
  裏面側にヘッダで接続する。使うのは **RP2040 の ProMicro
  互換ボード**（33×18mm 級、USB-C、基板厚 1.6 級）。実物は
  未入手のため標準寸法＋余裕で設計し、実測依頼は終了。
- **ヘッダ高さは 2.5mm で確定**（2026-11-05 本人決定、保留を
  解除）。設計は 3mm でも収まる余裕で作ってあるため変更なし。スタック（基板裏 5.7 から
  下向き）: ヘッダ 2.5 → モジュール基板 z[1.6, 3.2]、3.0 →
  z[1.1, 2.7]。コネクタ中心（ミッドマウント前提）は z 1.5〜2.8、
  レセプタクル半高約 1.6 で上端最大約 4.4。
- **USB 開口の作り替え（実装済み）**: フレームの旧開口
  （z 9.8〜15.3、スイッチ側前提）は廃止して壁に戻し、開口は
  トレイ＋バンドの端壁へ移設: 中心 x=94、幅 13、**z 0〜4.5**
  （USB_Z1 は当初案 3.4 から 4.5 に拡大し、上記マージンを
  明記）。どの互換ボードでも刺さる余裕: 中心 1.5〜2.8 の
  ばらつきに対し開口は上下とも 1.7 以上の余裕。
- **トレイの MCU ポケット（実装済み）**: x[83, 105]、端から
  38mm、床 0.3（MCU_POCKET_FLOOR、当初案 0.45 から変更。
  モジュール基板下面との間隔は 0.8〜1.3）。コネクタ帯（端寄り
  13mm）は床貫通。部品面を基板側に向ける裏返し装着（ProMicro
  の通例）が前提。逆向き装着でもコネクタ帯は不変だが、部品が
  下向きになる場合はポケット床との間隔が詰まる（未確認 H-4）。
- **検証**: check_usb_channel で両半分とも、新チャネル貫通
  （z=2.25）／旧フレーム開口の閉塞／モジュール・コネクタ
  ボックス干渉 0（ヘッダ 2.5・3.0 両ケース）／TRRS 貫通を確認。

**D. 階段: 段境界を実測で是正＋short 最上段の深さ問題の原因特定**

- **段境界（長さ方向）— 両半分とも実測で置き換え（確認済み）**:
  本人の区間長（写真 7461/7462）は「背面端から」とされたが、
  注記線の画素位置（ソケット穴の既知座標で校正）とソケット
  中心余裕の整合から、基準は背面プレーン (x=114.0) ではなく
  最背面段の背面側の段境界（x=103.4、DXF アンカー不変）と
  確定。区間はキーのある 5 段に 1:1 対応する。
  - long: 17.2/19.1/19.1/**22**/17.2。段境界 84.4/65.2/46.2/
    26.6 → **86.2/67.1/48.0/26.0**（差 +1.8/+1.9/+1.8/−0.6）。
    最深段 T2（SW32）が 19.6→22.0 で、これが「下段の歯が
    入らない」原因（クリアランス 0.5 に対し最大 1.9mm のずれ）。
  - short: 20/19/19/16/20。段境界 → **83.4/64.4/45.4/29.4**
    （差 −1.0/−0.8/−0.8/+2.8）。タブ段 T2（SW28）が 19.6→16.0。
  - 再生成（make_outline3 → straighten_outline3 →
    straighten_back）で新旧対称差は階段帯の段境界付近のみ
    （short 49.9mm²／long 38.8mm²）。ドッキングは check_dock
    で再確認し不変（G）。
- **深さ（level）の扱い（本人判断）**: long は「たぶん大丈夫」
  で現行維持に確定。short は「概ね大丈夫、ただし一番上の段
  （T5・SW25）だけ浅かった」という実物判定。
- **short T5 の原因特定（モデル実測で確定）**: 当初の想定
  （基板の歯がモデルより出っ張る）とは逆だった。基板側の歯は
  スキャン輪郭（outline2 の T5 最小 y=24.346）でもモデル
  （level 24.46）と 0.11mm しか違わない。一方ケース側は、
  フレーム下帯キャビティの断面実測で T1〜T4 と landing が
  クリアランス 0.50 なのに対し **T5 だけ 2.50**（壁が
  y=21.96、設計 23.96）。原因は壁厚キャップ（§17.12）と
  背面ラン延長（SEAM_BACK_EXT=2.0、§17.13）の相互作用:
  背面ランのフェイスが 19.76 に延びた分、キャップが「壁厚
  2.2 以下」を守ろうとしてキャビティまで 2.0 広げていた。
  7460 で上段の隙間が広く見えたのはこの 2.0mm 分。
- **補正（T5 のみ、他段は変更なし）**: 壁厚キャップの対象から
  背面ランを除外（stair_strip で back ランを skip）。T5 の
  クリアランスは 2.50 → **0.50** に復帰（断面再実測で確認）。
  背面ランの壁厚は 4.2mm の厚壁のままになるが、long の背面
  ラン（5.6〜6.4mm）と同じ扱いで問題なし。補正量の根拠は
  「現行キャビティ壁 21.96 − 設計壁 23.96 = 2.0mm の過剰拡大」
  で、基板側の歯深さ自体は変更していない。

**E. TRRS・タクト位置: 旧前提→実測→差分（確認済み）**

| 項目 | 旧前提 | 実測（是正後） | 差分 | 根拠 |
|---|---|---|---|---|
| TRRS 軸 long | 83.5 | **80.3** | −3.2 | 写真 7465 の 91.2（階段端 171.6→中心）＋画素計測（中心 y≈80.1）。旧値はピン列だった |
| TRRS 軸 short | 64.5 | **67.2** | +2.7 | 写真 7466 の 33.6 = SW25 穴左端 (30.38) → ピン線 (63.98、スキャン穴 64.07 と一致)。軸はピン線から外側へ long と同じ +3.1（開口幅 9 の範囲内、軸オフセット分は推定） |
| タクト中心 long | 14.0/23.5/35.9 | **15.0/24.5/34.0** | +1.0/+1.0/−1.9 | 写真 7464 注記チェーン: ピン線 83.5 −6.2→ 77.3（ジャック外面）−36.6→ 40.7 −29.5→ 11.2。9.8 = 端面 (5.11) → 最寄り中心 14.91（背面列ソケット y=15.01 と一致）。間隔は画素計測 ≈9.5 |
| タクト中心 short | 102.6/110.9/121.7 | **109.5/119.0/128.5** | +6.9/+8.1/+6.8 | 本人明示「位置関係はロング側と一緒」を鏡像適用。写真 7466 の 10 = SW1 中心 (128.45) → 外側端面 (138.45) で確定。旧 §8 は short で約 7mm の系統ずれ |
| 2.6（long、写真 7464_26） | — | 切り欠き中心 y≈12.4 | 記録のみ | 左線 = タクト1 中心線 (15.0)、右線 = 基板前端の半円切り欠き中心。タクト1 線から端方向へ 2.6。基板側の凹みで設計変更なし |

- フレームのスロットはタクト中心に追従（TACT_CENTERS 差し替え）。
  TRRS 開口も新軸に移動し、check_usb_channel で貫通確認済み。

**F. プレート穴のパチ留め（確認済み・本人実物確認）**

- trial_plate_holes でスイッチのパチ留め OK。プレート穴
  14.15 角は変更不要。check_plate_openings は全 63 穴が
  許容内（最悪偏差 0.00）。check_plate_ring は前ラウンドから
  不変（short (36.6,9.3) 17/24、long (93.7,167.4) 14/24、
  (55.6,153.2) 19/24 が deficient のまま既知）。

**G. 全検証（v2.4.4 最終形）**

- check_v21: §1 フレーム降下スイープ 0、§2 キャビティ
  クリアランス最小 0.499（T5 も 0.50 に復帰）、§3 旧パドル
  モデル参考値（静止で frame 0.14〜0.25、押下 0、傾き + で
  0.95〜0.96。パドル不使用のため参考記録）、§4 パーツ間
  干渉 全ペア 0、§5 ネジ経路 0（short 背面 1 本・long 3 本、
  吊りボス short 1 件は従来どおり tap-d 0.613 の既知値）、
  §7 スロット上壁 37.7〜45.8（逃げ拡大後も保持壁あり）、
  §8 壁厚キャップ max 2.190／2.200。
- check_dock: D*=157.780、全体幅 301.14、継ぎ目最小 0.300、
  D* での干渉 0（段位置が左右で数 mm ずれても不変）。
- check_usb_channel: 全項目 OK（C 項）。
- check_paddle_real: タクト実体ボックスはフレーム・トレイ・
  バンドで干渉 0（プレートのみ H-3）。
- verify_stl: 本体 8 点＋試作片は単一ソリッド／z=0／
  non-manifold 0。例外は trial_corner_band 両半分（comp=2）
  で、これはリングを角クリップで切り取った際の分割で従来
  どおりの試作片アーティファクト（製品パーツではない）。
- **トレイの孤立片の修正**: 窓端と端壁の間の床の帯（約
  9.5mm）が MCU ポケット貫通帯と挟まれて別ソリッドになって
  いた（両半分）。トレイだけ窓を端壁まで延長して切り取り、
  単一ソリッドに復帰（体積 short 34459／long 43849）。
- **試作片**: trial_all_v22 を再レイアウト（11 片、間隔
  3.00mm、180×180 内）。バンド角フラグメントの寸法変化で
  v2.2 スロット再利用が破綻したため、make_trial_all は棚置き
  パッキングに変更した。階段バンド両半分（段境界＋T5 の
  確認用）と角ピース両半分（タクト逃げ・USB 低開口・MCU
  ポケットの確認用）が含まれる。

**H. 未確認事項**

1. ~~ヘッダ／ソケット高さ~~ → **2.5mm で確定**（2026-11-05
   本人決定）。設計変更なし（3mm 対応の余裕のまま）。
2. RP2040 互換ボードの個体差（コネクタ中心 z・基板端からの
   出っ張り）。開口 z 0〜4.5 のマージンで吸収する前提で、
   実装後に実測確認。
3. プレートとタクトの接触（A 項）: ボックス前提で 7.4〜
   10.4mm³。実体の中心 x（背面端からの距離）が分かれば確定
   できる。次ラウンドのプランジャ設計と合わせて実測する。
4. 逆向き装着（部品下向き）時のポケット床との間隔（C 項）。
5. 羽根込み幅 8.2 vs 8.7 とブロック長さ 8.2 の確定（パドル
   不使用のため実用上の影響は無くなった。記録として残す）。
6. 代替機構は推奨案 (A) の寸法当たりまで。具体形状の実装は
   次ラウンド。

### 17.19 v2.4.5: プランジャ（小ボタン）実装（§17.18 の推奨案 A を具体化、2026-11-05）

本人の指示「試作片に小ボタンも入れる」を受けて、印刷製プランジャを
本実装した。本人が現行 v2.4.4 の試作を印刷中のため、本節の成果は
次回印刷分として準備する位置づけ。

#### A. 設計値（§17.18 の当たりからの変更点つき）

- 軸位置: タクト中心 (x=106.5〔TACT_X〕, y=TACT_CENTERS)。
  中心 x は未実測のため、§17.18 のタクト実体ボックス
  x[103.5, 109.5] の中心を **推定** で採用した。実体は約 5mm 幅で、
  中心のずれは ±1mm 級の見込み（ガイド穴 Ø5.4 に対しフランジ Ø7
  が逃げスロット内を動き、受け凹み Ø4.0 が先端 Ø2 級を ±1.0 まで
  受けられる寸法にしてある）。今回の試作で実物確認する。
- フレーム側の受け: ガイド穴 Ø5.4（軸 Ø4.6 に片側 0.4）。
  キャップ座ぐり Ø8.6・床 z=14.1（天面から深さ 2.0）。
  §17.18 の座ぐり Ø9.6 はタクト間隔 9.5 と同等で座ぐり間に
  ウェブが残らないため Ø8.6 へ縮小（間に 0.9 のウェブ）。
  座ぐり床は背面側（+x）だけ実体で、内側（−x）は屋根の井戸が
  開いており、キャップの当たりは背面側の半月状になる点に注意
  （check_plunger で確認済み。押し心地への影響は試作で確認）。
- プランジャ本体（左右・6 タクト共通、`build_plunger()`、
  plunger.stl、体積 166mm³）: キャップ Ø8×厚 2.0／軸 Ø4.6×
  長さ 2.3／フランジ Ø7×厚 1.0（ガイド穴より大径の抜け止め）。
  フランジ下面に受け凹み（Ø4.0×深さ 0.9）を付け、タクト先端を
  逃がす。全高 5.3mm。
- z スタック（静止時）: キャップ z[15.2, 17.2]（天面 +1.1）、
  軸 z[12.9, 15.2]、フランジ z[11.9, 12.9]（屋根天井 13.2 まで
  遊び 0.3＝静止位置はフランジ上面が天井に当たって決まる）。
  凹み天井 12.8 とタクト先端 12.5 の間隔 = 0.3（§17.18 どおり）。
- ストローク: 静止間隔 0.3 + 作動 0.5 + オーバートラベル 0.3
  = 1.1 でキャップ下面が座ぐり床に当たりストッパになる
  （スイッチの OT 予算 0.5 を使い切る前に止まる）。フランジ下面
  とスイッチ本体上面（z≈10.6、推定）の間隔は静止 1.3 で、
  ストッパが先に効く。

#### B. 屋根の分離問題と連結帯（本ラウンドの主障害）

ガイド穴を開けるとトップフレームが 3 ソリッドに分離した。
切り分け（trimesh での単独実験）: 分離の原因は座ぐりではなく
ガイド穴のみ。屋根ブロック（タクト上の屋根）は外形の段差
コーナー（基板タブ付け根、x≈106.25）で細く括れており、穴が
その括れを断ち切っていた。対策として屋根の内側縁（キャビティ
縁 x≈104.5）に沿う連結帯 x[102.0, 104.6] × z[13.2, 16.1] ×
y[タクト列両端 ±6] を追加した。穴（内側端 103.8）と座ぐり
（同 102.2）の下層 z[13.2, 14.1] に幅 1.8 の連結糸が残り、
座ぐり床の支持も兼ねる。帯は天面開口の背面側に約 1.7mm
張り出す唇状になる（タクト先端との間隔 0.7 = スロット上面と
同じ）。修正後の体積: フレーム short 23041（v2.4.4: 23141）、
long 32851（同 32947）、両半分とも 1 ソリッドに戻った。

#### C. 既存逃げの扱い

- タクト逃げスロット（v2.4.4）は **残置**。タクト実体の逃げとして
  現役であり、プランジャのフランジ Ø7 もこの空間で動く。埋めると
  タクト実体との干渉確認ができなくなるため、試作で確認できる形を
  優先した。
- トレイ／バンドのパドル窓も本ラウンドでは残置（窓の撤去は
  フィン対策・MCU ポケットとの相互作用があり別件）。

#### D. 試作ピースへの組み込み

- trial_corner_frame（両半分）は再生成され、タクト 3 個分の
  ガイド穴＋座ぐりが含まれ、1 ソリッドに戻った。
- trial_all: 従来 11 ピース + プランジャ 6 個 = 17 ピース。
  180×180 内（bbox 179.6×178.3）、ピース間最小 3.0mm。
  実基板のタクトに角ピースを当て、プランジャを差して押し心地・
  ストローク・戻りを確認できる構成。

#### E. 検証（check_plunger.py 新設＋既存一式）

- check_plunger（6 タクト全数）: ガイド穴・座ぐりの軸上開口 OK。
  静止／接触 (−0.3)／作動後 (−0.8)／ストッパ (−1.1) でプランジャ
  ×フレーム・先端・本体すべて干渉 0。過押下 (−1.3) ではフレーム
  干渉 4.0〜4.3mm³ > 0（ストッパが効くことの証明）。プランジャ
  ×プレート（静止）0。先端モデルは接触後に追随させて測る
  （固定すると押下量が食い込みとして出るモデル上の都合）。
- 回帰: check_v21 §1〜§6・§8 は §17.18 G と同値。§7 スロット
  上壁は short 39.3〜43.9／long 38.7〜43.3 で従来範囲
  （37.7〜45.8）内（穴の減少分を連結帯がほぼ補う）。
  check_dock は全幅 301.14・干渉 0 で不変。check_plate_ring の
  deficient 3 件は既知のまま不変。check_usb_channel は全 OK。
  check_paddle_real のタクトボックス×フレーム 0・プレート
  7.4〜10.4 で不変。verify_stl は本体 8 点＋プランジャ＋
  角ピースフレーム 2 点がすべて 1 コンポーネント・non-manifold 0
  で OK（trial_all の 17 コンポーネントはピース数どおり）。
- 印刷方向: プランジャはキャップ上面をベッドに置く向きで
  モデリング済み（STL の z=0 が組立座標 17.2）。段差は軸→
  フランジの片側 1.2mm のみでサポート不要の想定。

#### F. 未確認事項

1. TACT_X = 106.5 は推定（A 項）。実物のタクト中心 x と今回の
   試作で照合する。ずれている場合は軸位置の再設定が必要。
2. 座ぐり床が背面側半月のみであることの押し心地・傾きへの影響。
3. プランジャの戻りはタクトスイッチのバネ頼み（ケース側にバネ
   なし）。実物の戻り感は試作で確認。
4. 連結帯の唇（天面開口背面側 1.7mm 張り出し）が実物の見た目・
   基板タブの抜き差しに影響しないか。
5. §17.18 H の残件（RP2040 互換ボードの個体差、逆向き装着時の
   ポケット床との間隔）は継続。

### 17.20 v2.4.6: v2.4.4 試作の不具合 4 件の修正とタクトまわりの一体再検討

#### A. 実物報告（v2.4.4 試作、本人の実物確認）

1. short 階段は基板と同サイズで「はまるというより全体が乗っかる」
   状態（特定の段ではなく全体、本人追加回答）。
2. タクトスイッチ幅 6mm に対し、ケース側の開口がそれより小さい。
3. long 階段ははまりがきつい。
4. long の一番上の段がスイッチとかぶる。
5. 追加写真 7470〜7473（フレーム角ピースをタブに当てた状態）:
   フレームの窓（タクト逃げスロット）に対してタクトが中央に来て
   おらず、端のタクトがフレームの実部に半分かかっている。横から
   見るとフレームの歯がタクト間に基板面まで降り、タクト側面に
   触れているように見える。

#### B. 切り分け: 逃げ寸法の問題か、座り位置（中心ずれ）の問題か

結論: 階段とタクトで原因が違う。階段は「座り位置」= キャビティ
実効クリアランスの目減り、タクトは「逃げの中心ずれ」が主で、
どちらも逃げ単体の公称寸法は CAD 上足りていた。

階段（報告 1・3）:
- バンド側キャビティは MIN_WALL クリップ（外形から 0.8 内側）が
  階段の蹴上面で cavity_q（基板+0.5）を削り、蹴上クリアランスが
  -0.8（干渉）になっていた（両半分共通、最悪は蹴上面）。
  基板下面より下の帯域のため、蹴上近傍の裏面ソケット（例: short
  タブ段ソケットで最大 0.68mm 突出、断面 14.1mm² の重なり上限）が
  バンド壁に当たり、基板が正規位置まで落ちない主因候補。
- 踏面方向は設計どおり +0.5（フレーム側）だが、印刷収縮（壁 1 面
  0.1〜0.2 級）と実物歯レベルの不確かさで実効 0〜0.2 まで目減り
  していたと推定。long の「きつい」と short の「乗っかる」は同根。
- フレーム側キャビティ（クリップなし）は +0.5 で無事だった。

タクト（報告 2・5）— 座標チェーン照合:
- ケース側チェーン（DXF 図面座標 ⇔ スキャン fit の outline3）は
  ソケット fit RMS 0.11mm 級で整合し、系統オフセットは見つから
  なかった。プレート穴（DXF 由来）が実物に合っている（パチ留め
  OK）こととも一致する。
- 一方、組み立て写真 7471 の画素計測（タクトピッチ 9.5mm で校正）
  では、フレーム窓中心がタクト中心から外側端方向へ +1.1/+1.3/
  +1.5mm と 3 個とも一様にずれていた（ピッチは一致）。7473 では
  +1.4/+0.2/+0.6mm で同じ向き（手持ち撮影の傾きでばらつき大）。
  角ピースの当て方にはキャビティ余裕 0.5mm 分の遊びがあるため
  全量を設計チェーンの誤りとは断定できないが、約 1mm 級の中心
  ずれが実在する可能性が高い。
- 旧スロット幅 7.2 はタクト 6.0 に対し片側 0.6 の余裕しかなく、
  中心ずれ約 1mm で片側が接触する。これが報告 2・5 の mechanism
  で、幅そのもの（7.2 > 6.0）は CAD 上不足していなかった。
  フレームの歯がタクト間に降りて側面に触れる見え方（7472）も
  このずれで説明が付く（歯の降下自体はスロット壁として設計どおり）。

L21（報告 4）: long 最上段の角スイッチ L21（中心 93.70, 167.52、
DXF 穴中心は (93.72, 167.44)）は 14.0 角の占有域が歯の踏面
（y=171.60）を 2.92 越え、フレーム内壁（cavity_full 面 172.10）を
2.42 突き破る実干渉（z=8 断面 32.2mm²）。バンド側でも同位置で
裏面ソケットの逃げが不足していた。

#### C. 修正内容

1. 階段帯クリアランス拡大＋蹴上クリップ解消（build_case）:
   階段帯（キャップ用ストリップ＋基板階段プロファイル線から
   3.2mm 以内の和集合）に限ってキャビティを基板+0.8 に広げ
   （新定数 STAIR_CAV_CLR=0.8）、同帯ではバンド側の MIN_WALL
   クリップを無効化した。壁厚キャップの再クリップ後にも再適用
   して解消を維持する。外形フェイス・SEAM_PROJ は変えていない
   （階段の壁は公称 2.2 → 1.9）。ネジ計画は v2.4.5 と同一に
   保つため、拡大は plan_screws の後に適用する。
2. L21 逃げノッチ（long のみ）: 14.3 角相当（14.0 + 全幅 0.3
   余裕）の箱で、フレームは z 5.7〜11.0、バンドはレッジ帯
   z 4.4〜5.7 を切り欠いた。フレーム上端は当初 9.55 で切った
   ところプレート帯 z 9.55〜11.0 の角に 4.5mm³（bbox
   x[86.70,88.20] y[172.45,174.52]）の食い込みが残ったため、
   スイッチ占有域の全高（PLATE_TOP=11.0）まで広げた。
3. タクト逃げスロット拡大: PADDLE_SLOT_HW 3.6 → 4.0（幅
   7.2 → 8.0）。タクト 6.0 に片側 1.0、プランジャフランジ Ø7 に
   片側 0.5（従来 0.1 で「擦る見込み」だった分を解消）。中心ずれ
   約 1mm までならスロット内で吸収できる。
4. プレート背面縁のタクト逃げノッチ（§17.18 未確認#3 の解消）:
   プレート縁がタクト上にかかる重なり（幅 6.0 モデルで全タクト
   7〜11mm³、x 103.5〜107.2 の帯）を、タクト中心ごとの局所切り
   欠き（x 102.5〜111.5、中心 ±4.0）で解消した。内側端 102.5 は
   タクト実体ボックス内側端 103.5 まで 1.0 の逃げ、最寄り穴列
   （穴縁 100.80）との壁 1.7。当初案 101.5 では隣接穴のリング
   サポートが 20/24 → 17/24 に落ちたため 102.5 に詰め、干渉 0 と
   リング回復の両立を確認した（D 項）。吊りボスは MCU ゾーン
   （タクト帯を含む）を避ける配置のためノッチと干渉しない。

タクトまわり一体再検討の判断（本人の重ねての指示への回答）:
- タクト中心 x（TACT_X）: あえて変えなかった。根拠の追加調査:
  タブ先端の背面縁はスキャンで x≈113.2（タクト y 範囲で直線）。
  ピンヘッダ列は x=86.10/101.34（行間 15.24、中心 93.72）。
  写真 7464 の拡大ではスイッチ殻がタブ縁の輪郭から約 1mm 張り
  出して見え、中心は §17.18 の実体ボックス [103.5, 109.5] の
  中心 106.5 と ±1.0 以内で矛盾しない。手持ち斜め写真の画素
  計測では ±1mm を切る精度が出なかったため、不確かさ ±1.0 と
  数値化した上で現行値を維持する（受け凹み Ø4.0 が先端 Ø2 を
  ±1.0 まで呑む設計と一致）。
- TACT_CENTERS（y）: あえて変えなかった。§17.18 のアンカー
  （本人の注記 9.8/10 と画素チェーン）の方が、角ピース手当て
  写真のずれ量（遊び ±0.5 を含む）より根拠が強い。ずれ対策は
  中心移動ではなくスロット拡大（C-3）で受ける。
- プランジャの当たり直し: 座ぐり／凹みの寸法は変えなかった。
  スロット 8.0 化でフランジ可動域は片側 0.5 に拡大。座ぐり床の
  支持が背面側半月のみである点は据え置き: 静止時のフランジ
  天井遊び 0.3 と軸（Ø4.6／ガイド穴 Ø5.4、片側 0.4）＋キャップ
  （Ø8／座ぐり Ø8.6、片側 0.3）の 2 点案内で傾きは小さく、
  check_plunger の全行程で干渉 0（D 項）。受け凹みとタクト
  先端の位置関係は中心 x 不確かさ ±1.0 でも凹み Ø4.0 が先端
  Ø2 を呑む範囲内。
- 戻りと押し心地: ケース側バネなし（タクトのバネ頼み）を維持。
  プランジャ質量は体積 166mm³（PLA で約 0.2g、重さ約 2mN）で、
  タクトの復帰力（0.5N 級）に対して無視できる。軸とガイド穴の
  片側 0.4mm は FDM の表面粗さ（0.1〜0.2 級）に対して十分で、
  摩擦で戻りが妨げられる見込みは低い（いずれも推定、実物の
  戻り感は試作で確認）。

座り位置の成立（修正後のモデル確認）: フレーム下降スイープ×
基板 = 全高さで 0（check_v21 §1）、バンド着座スイープ = 0、
パーツ間干渉オール 0。蹴上干渉の解消で、モデル上は基板が正規
位置まで落ちる前提が成立した。残る座り阻害候補は L21 裏面の
ソケットプロキシ残存（F 項）のみ。

#### D. 検証数値

階段（基板ステップ正本から段ごとに実測、解析と同じ符号付き
距離。踏面はレイ法、全体は基板境界の密サンプリング）:
- 踏面: 全 6 段 × 両半分 × バンド／フレーム両キャビティで
  +0.800 ちょうど。
- 階段帯全体（符号付き）: バンド側 最小 -0.000（食い込み解消、
  旧 -0.8）・中央値 +0.800・負値 0 件。フレーム側 最小 +0.500・
  中央値 +0.800・負値 0 件。フレーム側の最小 +0.5 は、段の向き
  が反転する蹴上（R1/R2）の中点で外形ステップ自体が上限に
  なる箇所（共有平面設計、従来から同値）。
- 壁厚（check_v21 §8）: 階段帯 p99 = short 1.94 / long 1.85、
  最大 2.19 / 2.05（公称 1.9、角の斜め距離で増える分を含む）。

ドッキング（check_dock）: 外形フェイスを変えていないため
D_c = 157.480、継ぎ目 min = 主階段 0.300／背面ラン 0.307、
全体幅 301.14、D* 干渉 0 で v2.4 系と同一。解析時の副作用予測
（継ぎ目 0.6〜0.7 へ拡大）は、拡大をキャビティ側だけに閉じた
ため発生しなかった（代わりに壁が 1.9 になる）。

L21: スイッチ 14 角 × フレーム（z 5.7〜11.0）= 0.000、
× バンド（z 4.4〜5.7）= 0.000。基板裏ソケット側はレッジ帯で
解消（同上）。薄壁帯 z 3.7〜4.4 の残存は F 項。

タクト: 幅 6.0 モデル（check_paddle_real、従来の幅 5.0 から
更新）× トレイ／バンド／フレーム／プレート = 全 6 タクト
0.00（プレートの 7〜11mm³ は解消）。check_plunger はスロット
拡大込みで ALL OK（静止〜ストッパ干渉 0、過押下 -1.3 で
フレーム 4.29 > 0 = ストッパの効き、プランジャ×プレート 0）。

回帰: check_v21 §1〜§8 すべて従来範囲（§4 パーツ間オール 0、
§5 ネジ経路 0、§7 スロット上壁 44.6〜49.1 で健全。long プレート
の min positive hole->outline 距離 0.04 は正値で、開口・リング
の合格と併せて観察事項とする）。check_plate_openings は
全 63 穴 14.15・偏差 0.00。check_plate_ring は short deficient
1 件（(36.6, 9.3) 17/24、従来どおり）／long 2 件（(93.7,
167.4) 15/24 = v2.4.5 の 14/24 から改善、(55.6, 153.2)
19/24 不変）で v2.4.5 基準と同等以上。check_usb_channel 全 OK。
verify_stl は本体 8 点＋プランジャ＋試作が単一コンポーネント・
non-manifold 0（既知例外: trial_corner_band 両半分の 2
コンポーネント、trial_all の 17 コンポーネントはピース数
どおり）。
試作: 階段バンド両半分・角ピースを再生成。trial_all は
17 ピース（プランジャ 6 個込み）、bbox 179.6 × 178.6 で
180 × 180 内、ピース間隔最小 3.0。

#### F. 未確認事項

1. タクト窓中心と実タクトの中心ずれ（約 1mm 級、写真計測）。
   スロット 8.0 化で片側 1.0 まで吸収するが、実ずれが 1.3mm
   級だった場合は片側が約 0.3 触れる計算。今回の角ピース試作で
   どちらの側が触れるか（または触れないか）を確認し、必要なら
   次ラウンドで TACT_CENTERS を実測分だけ寄せる。
2. L21 基板裏ソケット: 薄壁帯（z 3.7〜4.4）では 14 角プロキシ
   （最悪形）で 3.0mm³ の重なりが残る（bbox x[86.70,87.40]
   y[168.40,174.52]、幅 0.7mm の角の薄片）。実ソケットは
   14 角より大幅に小さいため実害は低い見込みだが未確認。
   角ピース（バンド）で実物確認する。
3. TACT_X = 106.5 ± 1.0（推定のまま）。プランジャ試作で
   受け凹みと先端の当たりを実物照合する（§17.19 F-1 の継続）。
4. 階段の実効クリアランス 0.8 化で実物の「きつい／乗っかる」が
   解消するかは試作の実物当てで判定する。ドッキング時の階段
   の見た目（壁 1.9 化の影響）は本印刷で確認。

### 17.21 v2.4.7: タクト列端の全高壁の切り上げ（2026-11-06）

#### A. 経緯（本人の実物観察 → 実測）

v2.4.6 試作の角ピースを見た本人から「タクトスイッチのとこの
フレームの厚みが基板のぶんだけ厚い」との指摘。現行設計
（v2.4.6）の top_frame をレイキャストで断面実測すると、
タクト列の端（short y≈141〜143／long y≈2〜4、タクト帯
x≳104）ではフレームが z 5.7〜16.1 の全高で残っており、
下端 5.7 は基板上面 7.3 から基板厚ちょうど 1.6 下（＝基板
下面）で、指摘どおりの寸法だった。一般部の内壁の下端は
下帯キャビティ上端の z 9.55 で止まる。
原因は意図した設計ではなく生成方法の副産物: フレームは
prism（外形, 5.7, 16.1）からキャビティ等を引いて作るが、
基板端より先（short は基板端 y=138.45 より先、long は
y=5.11 より手前）では基板が無いためキャビティが届かず、
タクト帯では列端の先にブロックが全高で残っていた。
本人の判断は「だめ」で、切り上げを指示された。

#### B. 修正内容

タクト帯（x >= PADDLE_SLOT_X0 = 102.0）かつ基板端より先の
領域に限り、フレームの z < 9.55（= PLATE_BOT + 0.05、
一般部の下帯キャビティ上端と同高）を切り上げた:
- short: y [138.95, 144.36]（基板端 + CAV_CLR 〜 外形端 + 1）
- long: y [-1.00, 4.61]（外形端 - 1 〜 基板端 - CAV_CLR）
切り上げ範囲の根拠: 背面ネジは plan_screws で y <= ymax-6
かつパドル帯域回避で計画され、この領域には入らない。
屋根とプランジャ連結帯は z >= 13.2 で無関係。切り上げ部の
上部（9.55〜16.1）は背面壁・天面と連続するため、フレーム
の単一性は保たれる（C の検証で確認）。
対象外の部分（x < 102 の端部スラブ、基板のある範囲の
周囲壁）は従来どおり触っていない。

#### C. 検証

断面再実測（レイキャスト、ケース座標）: 切り上げ帯の内側
（x 102.4〜113.5、端部 y 帯）でフレーム下端は 9.55／11.0
のみとなり、9.5 未満の列はゼロ。基板上面 7.3 より下に
降りる部分は対象帯から消えた。
フレーム体積: short 22647mm³／long 32317mm³、export 時
solids=1。verify_stl は本体 8 点＋プランジャ＋試作が
単一コンポーネント・non-manifold 0（既知例外は従来どおり:
角バンド両半分の 2 コンポーネント、trial_all の 17
コンポーネントはピース数どおり）。
回帰: check_v21 全節が従来範囲（フレーム下降スイープ・
パーツ間干渉 0、ネジ経路 0、階段壁厚 p99 short 1.94／
long 1.85）。check_dock は v2.4 系と同一（継ぎ目 min
0.300、全体幅 301.14、D* 干渉 0）。check_plunger ALL OK。
check_plate_openings 全 63 穴 OK（偏差 0.00）。
check_plate_ring は v2.4.6 と同一（short deficient 1 件
17/24、long 15/24・19/24）。check_usb_channel 全 OK。
試作: 角フレーム両半分を再生成。trial_all は 17 ピース
（プランジャ 6 個込み）、bbox 179.6 × 178.6、間隔最小 3.0。

#### D. 注記: §17.20 の窓中心ずれ計測の格下げ

§17.20 B／F-1 でタクト窓中心ずれの根拠にした写真 7471
の画素計測（フレーム窓中心がタクト中心から外側端方向へ
+1.1/+1.3/+1.5mm）について、本人の指摘「今までの試作は
基板の裏表が逆だった気がする。LED は基板の裏から光して
いる」を受けて写真を再確認した。基板の構成自体は設計
前提と一致する（LED・ソケット・TRRS・マイコンは Light
Side = 裏面、タクトは反対のスイッチ側 = 表面。写真
7466／7471 で確認）。ただし写真 7471 では、フレーム角
ピースが基板の裏側（LED 側）に回った状態で写っており、
画素計測には裏表逆の当て方による見かけのずれが混ざって
いる可能性を否定できない。
このため、§17.20 F-1 の「必要なら TACT_CENTERS を
実測分だけ寄せる」という判断は格下げする。タクト中心を
寄せるかどうかは、次回試作で正しい向き（タクトのある
表面にフレームを当てる）で当て直して再確認してから
判断する。スロット 8.0 化（片側余裕 1.0）自体は、ずれの
有無によらず余裕の拡大として維持で問題ない。

#### E. 未確認事項

1. 切り上げにより、ケース端面の背面寄り（x >= 102、
   基板端より先）に z 5.7〜9.55 の開いた帯ができる。
   実物での見え方は試作で確認する。
2. タクト窓中心と実タクトの中心ずれ（§17.20 F-1）は、
   D の注記のとおり正しい向きでの再確認待ちに変更。
   TACT_X = 106.5 ± 1.0 の推定も継続（プランジャ試作で照合）。

### 17.22 v2.4.8: TRRS ジャックの裏面前提是正（開口新設・逃げ・旧開口廃止、2026-11-06）

#### A. 経緯（監査で前提誤りが判明）

設計の従来前提（ジャック本体は基板の上＝表面側、フレーム背面壁に
開口 z 7.75〜13.15、軸 z 10.45）は v1 期のレンダー推定で、z は
実基板で未測定だった。監査で写真 7466／7477 を確認したところ、
ジャックは裏面（Light Side）実装だった。本人実測で基板込みの
全厚 6.7mm が確定し、ジャックは基板裏面から 5.1mm 張り出す
（ケース座標の占有は z 0.6〜5.7）。位置（x/y）は §17.18 の是正値
（軸 short 67.2／long 80.3）が正しいことを再確認した。

#### B. 軸 z の推定

軸 z = 3.0（推定、±0.4）。根拠: 本体高さ 5.1 に対し穴 Ø3.5 の
中心は、本体下端から穴半径 1.75＋下壁 0.5〜0.8 ＝ 2.25〜2.55
上が物理的範囲で、取り付け面（裏面 z 5.7）からの軸オフセットは
2.55〜2.85 になる。一般的な SMD 3.5mm ジャックの軸オフセット
（2.6〜3.1）とも整合し、写真 7466 でも軸は本体ほぼ中央で
裏面寄りに見える。開口と逃げは、軸 2.6〜3.4 の全域で干渉 0 に
なる寸法にした（未実測分の余裕）。

#### C. 修正

1. **プラグ開口の新設**（幅 11.0＝中心 ±5.5、x は背面フェイス
   から 14.3mm 内側＝x ≥ 100 から）:
   - トレイ: 床貫通スロット（z −0.1〜2.6）。ポケット（残り床
     0.6 目安）ではなく貫通を選んだ。全厚 6.7 は目安値で
     ±0.2 級の振れがあり、ポケットでは最悪ケースでジャック
     下端が床に当たって基板が座らない恐れがあるため。開口は
     背面縁の小さいスロットで大半はジャック本体が塞ぎ、
     ジャック下端は下面から 0.6 奥まる。
   - バンド: 全高開口（z 1.8〜5.8）。監査で見つかった
     「z 2.5〜4.4 でバンド薄壁が基板背面ふちの内側へ最大約
     1.2mm 入り込む（TRRS タブ帯を含む）」件も、タブ帯域ごと
     開口になるため解消する（レッジ帯 z 4.4〜5.7 はジャック
     占有と重なるため元々壁がない）。
   - フレーム: プラグ胴体（Ø6.5 級）の逃げとして、背面壁の
     下帯 z 5.6〜6.9・x ≥ 100 を切り取った（タブ部のフレーム
     下帯に残っていた膜状区間の解消も兼ねる）。
2. **旧前提の後始末**: フレーム背面壁の旧 TRRS 開口
   （z 7.75〜13.15）は塞いだ（壁に戻した）。開口の役割
   （基板上のジャック＋上からのプラグ）は前提是正で消滅して
   おり、塞ぐことで背面壁が連続して強度・外観とも改善する。
   フレーム体積は short 22,647→22,857／long 32,317→32,513。
3. **島セグメントの扱い**: バンド背面壁は TRRS 開口とパドル窓
   の 2 箇所が全高で切れるため、その間の壁（short y 72.7〜
   104.1／long y 39.4〜74.8、レッジ含む）が独立片になる。
   ジャックの影（裏面から 5.1・幅 ±3.25）がバンド断面
   （z 1.9〜5.7 の壁＋レッジ）全体に重なるので、バンド内には
   橋渡しできる箇所がない。対策として、バンド側は開口を
   パドル窓まで連続させて 1 ソリッドを維持し、壁＋レッジの
   形状は同じ断面のままトレイの付属として同じ位置に作った
   （基板支持・外形・内面は従来のバンド島と同一で、色だけ
   トレイの黒になる）。セグメント内を通る背面ネジ
   （long y 59／71）は通し穴をセグメント上端まで延長した。
   副次効果として、角試作のバンドピースにあった独立フラグ
   メント（従来 2 ソリッドだった既知例外）も消えた。

#### D. 検証

新規 check_trrs.py で検証し、回帰一式も実施した。

- ジャック実体エンベロープ（裏面から 5.1、下端 z 0.6、
  y ±3.25、x はタブふち＋0.3〜外面＋0.3）×トレイ／バンド／
  フレーム: 両半分とも干渉 0。
- プラグ模擬（胴体 Ø6.5・ピン Ø3.5、軸 z = 2.6／3.0／3.4）
  ×全パーツ: 干渉 0。開口幅走査（x = 外面 −0.4、z = 3.0）で
  中心 ±5.4 まで空き・±7.0 で壁が残ることを確認。
- check_usb_channel（§4 を新前提に更新）: 新低チャネル
  （軸 2.6／3.0／3.4）が外面まで貫通、旧開口中心 z 10.45 の
  背面壁帯域は材料で閉塞。MCU／USB の従来チェックも全合格。
- 回帰: check_v21（パーツ間・基板との干渉すべて 0、主要値は
  v2.4.7 と一致）／check_dock（継ぎ目最小 0.300・全幅
  301.14・干渉 0）／check_plunger 全 OK／
  check_plate_openings（63 穴すべて公差内）／verify_stl
  （全ファイル comp=1・nonmanifold=0・OK）。
- 並行実施された v2.4.9（§17.23、レッジ×キーソケットの
  局所切り欠き）と統合した状態でも全チェック合格を確認した
  （切り欠き対象ソケットはすべて島範囲外にあり、トレイ付属
  セグメントと干渉しない）。

#### E. 再生成と試作構成の変化

- 影響パーツ（トレイ／バンド／フレーム、両半分）と試作
  ピース（角トレイ／角バンド／角フレーム、階段バンド）を
  再生成した。trial_all はピース数が 17 → 15 に変わる
  （バンド島フラグメント 2 個が角トレイ側に統合されたため）。
  配置検証（180×180 内・間隔最小 3.0・watertight・体積一致）
  は合格、bbox 179.6 × 178.6。
- TRRS 帯（short y 67.2／long y 80.3）は、どの試作ピースの
  切り出し範囲にも含まれない。TRRS 部の初の実物確認は
  本印刷になる点に注意。

#### F. 未確認事項

1. 軸 z = 3.0 は推定（±0.4）。実物でのプラグ挿入確認は
   本印刷後。開口は軸 2.6〜3.4 の全域で通る寸法にしてある。
2. トレイ床貫通スロットの見え方（背面下縁）は本印刷で確認。
3. トレイ付属セグメントは黒になるため、バンドの白い帯は
   背面の TRRS 開口〜パドル窓間で途切れる。実物での見え方は
   本印刷で確認。

### 17.23 v2.4.9: レッジ×キーソケット干渉の全数チェックと局所切り欠き（2026-11-06）

発端は本人の指摘: 「バンドを下から当てるやり方だと、ロング側は
キーソケットが基板のフチぎりぎりに来ているのでできない」。
階段ふち列のシルク↔設計 ID 対応（証拠写真 42e3...jpg と
pcb_sockets.csv から確定）: SW29=L21 (93.70,167.52)、
SW30=L32 (74.63,157.97)、SW31=L33 (55.43,153.23)、
SW32=L03 (36.50,143.68)、SW33=L31 (17.48,150.86、180°回転実装）。

#### A. チェック方法（新規 check_socket_ledge.py）

- ソケット包絡は裏面スキャン（7346、オルソ・6.9px/mm）の実測に
  基づく。金属接点は中心から対角 (+4.4,+6.5)/(+5.3,-6.4) 前後
  （L21・L29・S27 で確認）＝ MX 標準ピン配置。
  - 包絡 A（主判定）: バー x[+1.5,+7.5]・y ±7.8 ＋ ドーム半径 2.75。
  - 包絡 B（感度参考）: 写真 bbox 由来の攻撃形。バー x[+0.75,+6.9]・
    y[-8.0,+9.7]。B のみで当たるものは計測不確かさとして分離。
  - 張り出し高さは裏面から 3.0mm 仮定（z 2.7〜5.7）。
- 全 63 ソケット × 現行バンド（v2.4.8 統合状態）× 両向き
  （std/rot）で 3D 照合し、レッジ帯（z 4.4〜5.7）分を分離集計。

#### B. 修正前の干渉（包絡 A、体積 mm³）

- short: S27 47.5（レッジ帯 29.8）／S19 9.5／S26 6.6／S13 4.9。
- long: L33 36.1（同 21.6）／L21 23.8（同 9.3）／L32 16.0／
  L31 7.0／L03 2.0。
- B のみ: S25 7.8／S09 8.6／L17 9.1／L34 9.8（いずれも小）。
- 階段帯以外も含め、ふちに近いソケットではレッジの潜り帯
  （ふちから 1.5mm）がソケットのバー端と実際に重なることを確認。
  本人の指摘は正しかった。

#### C. 修正（build_case.py、SOCK_NOTCH_PAD=0.3）

- 干渉する 13 ソケット（A 干渉 9 + B のみ 4）だけ、包絡
  （A∪B・両向き）を +0.3 膨らませ基板外形 +0.9 でクリップし、
  レッジ帯 z[4.4,5.7] を局所的に切り欠く（データ駆動: 輪郭や
  ソケット位置が変われば自動で追随）。対象: short S09/S13/
  S19/S25/S26/S27、long L03/L17/L21/L31/L32/L33/L34。
- 階段クリアランス（+0.8、§17.20）・壁厚・z 4.4 未満の薄壁は
  不変。レッジ支持の喪失は包絡∩リング換算で short 約 95/
  736 mm²・long 約 117/936 mm²（各 ~13%）で、残りは連続し
  基板受けとして十分。

#### D. 検証（修正後）

検証は2系統: (1) OCC ブーリアン（check_socket_ledge.py、
モデル座標）、(2) 書き出し STL への独立メッシュ検証
（点包含、格子 0.3mm）。STL 書き出しはベッド合わせで
z が −1.9 ずれる（export の moved）ため、(2) では
mesh z = model z − 1.9 に換算して判定した。

- 実向き（std）での干渉は **L21 の帯域のみ**に残る:
  A-std でレッジ帯 5.1 mm³、場所は y 172.8〜175.2 の全量が
  outline3 誤差帯（踏面 171.6 より外、§F）の中。L21 以外の
  全ソケットは std で A/B ともゼロ（rot 実装の L31 も
  両向きゼロ）。
- 向きの実測: 階段列のソケットはスキャンの接点輝度で
  向きを確定した。L21・L29・L33・S27 とも std 対角が明瞭
  （輝度 120〜190 対 rot 対角 5〜88）。したがって次項の
  rot 残存は物理的には当たらない。
- rot 包絡でのみ残るもの（参考）: 蹴上壁ストリップ
  （外形蹴上フェイスと同一面から内側 1.2mm の薄壁が
  z 2.5〜4.4 で基板平面内に入る帯）との接触が S27
  18.1／L33 14.9／L32 4.5 mm³（いずれも z<4.4 のみ、
  レッジ帯はゼロ）。切り欠きを z 2.7 まで広げれば消える
  が、壁リングの断面連続性（check_dock のシルエット
  前提）が壊れるため採らない。実向き std では当たらない。
- 包絡 B のふち外オーバーリーチ: S26 B-rot 2.3（y=9.3、
  踏面 10.25 の外）／S27 B-rot のレッジ帯分 2.2
  （y=−0.3、基板外）。いずれもハウジングが存在し得ない
  領域での接触で、実害なし。
- OCC 直接照合では S19 0.46 等の小残存も出るが、メッシュ
  検証では同箇所ゼロで、OCC 側の誤差と判定した（L21 の
  OCC 残存 bbox が包絡の外に出る例も確認）。
- 回帰: check_v21（階段ソケット円盤の最小距離 4.880 ≥ 3.25
  等、全項目従来どおり）／check_dock（シルエット面積
  485/574・D* 干渉 0・押込み 483.7 と基準値に一致）／
  verify_stl（バンド両半分・階段バンド試作・角バンドとも
  comp=1・nonmanifold=0・OK）。trial_all 再生成済み
  （15 ピース構成は §17.22 のとおり）。

#### E. 組み立て可否

- 基板を真っ直ぐ落とす場合に拘束になるのはレッジ帯
  （z 4.4〜5.7、潜り 1.5mm）のみ。z 2.5〜4.4 では基板
  平面内にバンド材が入り込む箇所がある（薄壁スラィバと
  蹴上ストリップ、体積は short 122.1／long 66.8 mm³、
  大半が階段帯）が、天井は z 4.4 以下＝基板裏面まで
  1.3mm 以上の隙間があり、基板自体の挿入は妨げない。
  裏面部品との当たりはソケットで上記 D のとおり検証済み。
- 切り欠き後は、実向きのソケット列はレッジに当たらず、
  真っ直ぐ落とす／下から当てる、どちらの手順でも入る
  （L21 の歯だけ §F の輪郭誤差が残る）。
- 斜め・スライド挿入はレッジの潜り分だけ当たりやすいので
  非推奨（従来どおり真っ直ぐが確実）。

#### F. 重大な副次発見: outline3 の long 最上段の歯が約 4.4mm 短い（未修正・要別ラウンド判断）

- 裏面スキャンの厳密プロファイル測定（ドーム重心フィット
  残差 最大 0.006mm）でふち位置を全歯再測定した結果、
  他の歯はすべて outline3 と ±0.5mm で一致（L03 ≈152.2／
  設計 152.7、L31 ≈160.4／159.6、L32 ≈166.5／166.6、
  L33 ≈160.5／160.7、short S13 ≈24.6／24.5、S19 ≈15.1／
  14.9、S26 ≈10.3／10.25、S27 ≈0.8／0.65）するのに対し、
  **long 最上段の歯（L21 の歯、x ≈85〜103）だけ実基板の
  踏面が約 176.0 で、outline3 の 171.6 より約 4.4mm 長い**。
  公式 DXF の同歯（177.2）とも方向が一致する。
- 影響: この歯ではキャビティ自体が実基板より小さいため、
  本節のレッジ切り欠きだけでは基板は入らない。本人の
  「long 階段がきつい」「一番上の段がスイッチと被る」
  （§17.20 の発端）の主因はこの輪郭誤差とみられる。
  本人の言う「フチぎりぎり」も実態に近く、L21 のバー端
  （実ふちまで約 0.7mm）まで実基板は届いている。
- 本節では outline3 本体には触っていない（§17.12 の
  「L21 中心→ふち 4.08mm」は実測約 8.4mm で、§17.20 の
  L21 ノッチ等の前提数値の見直しを含む是正ラウンドが
  別途必要。是正案: 当該歯の踏面 171.6 → 約 176.0、
  x∈[85.4,103.4]。103.4 以右の 170.8 帯は実測 ≈170.5 で
  現行どおり）。

### 17.24 v2.4.10: outline3 の long 最上段の歯（L21 の歯）の踏面是正（2026-11-06）

§17.23 F の是正案を実施した。対象は当該歯のみで、他の歯・
short 側・非階段部には触っていない。

#### A. 是正値と根拠

- 踏面: **171.60 → 176.00**、範囲 **x∈[85.4, 103.4]**。蹴上は
  隣接歯（166.90）との境界で x=86.2 → **85.4** に移動（隣接歯の
  踏面レベルは不変、区間が 67.1〜85.4 に変わる）。103.4 以右の
  踊り場 170.80 は実測 ≈170.5 で許容内として現行どおり。
- 根拠（4 系統が 176.0 前後に収束）:
  1. §17.23 F の裏面スキャン厳密プロファイル測定（ドーム重心
     フィット）: 当該歯のみ実基板 ≈176.0、他の全歯は設計と
     ±0.5mm で一致。
  2. 同スキャンの L21 中心→ふち実測 約 8.4mm（167.52 + 8.4
     = 175.9）。§17.12 の「4.08mm」は誤りだった。
  3. 公式 DXF の同歯 177.2 − 基板インセット約 1.1 ≈ 176.1。
  4. 本ラウンドの独立追認（work_scan2/step23b、スキャン 7346
     のチャンネル帯プロファイル）: short を対照に取ると全 6
     段が設計どおり（スケール 6.92px/mm で ±0.15mm）に収まり
     手法を検証できた。同手法で long は T2〜T4 が ±0.2mm で
     一致する一方、L21 の歯の段だけが 171.6 予測より約
     +4.9mm 深く、176.0 予測とは約 0.6mm で一致した。
- 蹴上 85.4 の採用理由: ノギス実測チェーン（§17.18）は 86.2
  だったが、スキャンフィットの 85.4 を採った。実物が 85.4 で
  モデルが 86.2 だと当該帯でキャビティが実基板より小さく
  ハード干渉になる一方、逆は蹴上クリアランスが増えるだけで
  実害がないため。

#### B. 適用方法（重要: 正本 CSV の直接編集）

- build の入力は template/pcb_outline3_*.csv が正本である。
  make_outline3.py の再実行は現行コード経路では正本 CSV を
  再現しない（頂点数 114 対 正本 45/61、全面積で約 0.8% の差）
  ことが本ラウンドで判明したため、再生成は使わず、long の
  正本ポリゴンへ矩形 [85.4,103.4]×[166.90,176.00] を合体する
  直接編集で適用した（short CSV はバイト同一のまま）。検証:
  是正前に正本 CSV で再ビルドすると short 4 パーツが staging
  （v2.4.9 統合状態）と体積完全一致し、正本性を確認した。
  make_outline3.py の STEPS は build_case のシーム整形の正本
  として (85.4, 176.00) に更新し、再生成への警告文を同ファイル
  と STEPS のコメントに残した。
- 是正後の long ポリゴン: 面積 16480.9 → 16563.8mm²。プロ
  ファイル実測（x=85 で 166.90／86〜103 で 176.00／105 以右
  170.80）で意図どおりを確認。

#### C. 波及

- **L21 逃げノッチ（v2.4.6）**: 不要になった。スイッチ占有域
  （14.0 角、y 最大 174.52）は歯の内側に収まり、階段キャビ
  ティ面（176.8）まで 2.28mm の余裕がある。現行輪郭では
  ノッチ箱はフレーム／バンドとも実在材料と交わらない
  （交差体積 0.0mm³ を実測）。コードは将来の保険として残し、
  コメントに無効化を明記した。
- **レッジ切り欠き（v2.4.9、データ駆動）**: 新しい輪郭で自動
  再計算され、L21 の ring_overlap=22.85mm² で切り欠きが入る。
  check_socket_ledge の結果は D 節。
- **ドッキング（check_dock）**: 継ぎ目最小 0.300 は不変、D*
  での干渉 0。**全体幅は 301.14 → 302.61mm（+1.47）** に
  変わった（歯が実基板どおり長くなりシーム面が押した分。
  旧値は誤った輪郭基準）。押し込み（D_c−0.5）の干渉は
  219.3mm³（frame×frame 144.6 が最大）。
- **壁厚**: 階段帯の最大壁厚（cap 検査）long 2.000 ≤ 2.2。
  当該歯のフェイスは y=178.7（踏面 176.0 + キャビティ 0.8 +
  壁 1.9）で、§17.20 の階段壁 1.9 と同一構成。
- **階段クリアランス +0.8**: ビルドで階段帯に一様適用され
  （long の追加面積 585.5mm²）、是正歯でも踏面・蹴上とも
  維持される。check_v21 §1 のフレーム降下スイープ（是正後
  輪郭の基板モデル対フレーム）が全高で干渉 0。
- **プレート**: L21 穴のリングサポートが **15/24 → 19/24 に
  改善**（歯が伸びて +y 側の材料が増えた）。開口は全 63 穴
  14.15 角・偏差 0.00（check_plate_openings）。

#### D. 検証（全て合格）

- check_v21: §1 降下スイープ 0、§2 キャビティ最小 0.499、
  §4 パーツ間・対基板の干渉すべて 0、§8 階段ソケット円盤の
  最小距離 long **8.230**（旧 4.880 から改善、要 3.25）。
- check_socket_ledge: 実向き（std）の包絡 A 干渉は全ソケット
  **ゼロ**（OCC／メッシュ点包含の両方式）。§17.23 で残って
  いた L21 std のレッジ帯 5.1mm³（旧輪郭誤差帯の中）は消滅。
  残存はすべて従来から許容してきた区分のみ: rot（実在しない
  向き）の蹴上ストリップ接触（L33 14.44／L21 5.10／L32 4.20、
  いずれもレッジ帯分 0.00）、L31 std 1.61（同ソケットは rot
  実装で実向きは 0、場所も z<4.4 のストリップ）、包絡 B の
  ふち外オーバーリーチ（L21 B-std 2.69、y 176.9〜177.1 =
  実基板ふち 176.0 の外でハウジングが存在し得ない領域）。
- check_dock: 上記 C。check_plunger: ALL OK。
  check_plate_openings: 全 63 穴公差内。
  check_plate_ring: short (36.6,9.3) 17/24・long (55.6,153.2)
  19/24 は従来どおり、L21 穴のみ改善（C 節）。
  check_usb_channel: 全 OK（TRRS 低チャンネル z 2.6/3.0/3.4
  貫通、旧開口は閉塞）。check_trrs: 干渉 0・開口幅 OK。
- verify_stl: 全 19 ファイル comp=1・nonmanifold=0・OK。
  trial_all は 15 ソリッド・全 watertight・最小間隔 3.00・
  ベッド内（173.9×169.6）。
- 実基板スキャン輪郭との階段全段照合: A 節 4. のチャンネル
  プロファイル測定が相当し、是正歯は実測一致・他の全段は
  設計一致（±0.5mm 以内、§17.23 F と本ラウンド追認）を確認。
  残る段差方向の不確かさ（最大 ±0.5mm）は階段クリアランス
  +0.8 の内側に収まる。

#### E. 再生成と trial_all

- 再生成: long の 4 パーツ（plate 12399／frame 32662／tray
  44033／band 5130mm³、frame・tray・band の y 最大 178.7、
  plate は 176.6）と試作ピース（階段バンド long 2053mm³、
  y 127.2〜178.7 で歯全体を含む）。short は全パーツ・全試作
  ピースとも v2.4.9 から不変（体積一致で確認）。
- trial_all: 階段バンド long の奥行き増（50.0 → 51.5）で従来
  の棚置きグリーディがベッドに収まらなくなったため、
  make_trial_all の詰め方を MaxRects 方式に変更した。検証
  アサーション（体積・watertight・間隔 3mm 以上・ベッド内・
  z=0 着座）は従来どおり全て通過。

#### F. 未確認として残すもの

- TRRS 軸 long 80.3 の導出チェーン（§17.18 E）に「階段端
  171.6 から 91.2mm」という記述があり、もし写真 7465 の
  測定原点が L21 の歯の踏面だった場合、軸は 84.8 になる
  計算が成り立つ。一方で画素計測（中心 y≈80.1）と §17.22 の
  再確認は 80.3 を支持しており、本ラウンドでは変更しない。
  TRRS 帯は試作ピースに含まれず実物確認は本印刷が初になる
  ため、その際に軸位置もあわせて確認すること。
- 是正歯の実物当たりは、再生成した階段バンド long の試作
  ピースで確認する（本印刷前の必須確認）。

### 17.25 v2.4.11: TRRS 確認ピース追加・スイッチ穴ピース除外・trial_all 2ファイル分割（2026-11-06）

#### A. 経緯

- §17.22 E／F の残リスク（TRRS 帯がどの試作ピースの切り出し
  範囲にも含まれず、実物確認が本印刷で初になる）の解消として、
  本人の指示で TRRS 確認ピースを追加した。
- あわせて本人の指示で、スイッチ穴ピース（trial_plate_holes、
  プレート穴のパチ留め確認用）を trial_all から除外した
  （パチ留めは v2.4.4 試作で実物確認済みのため）。
- さらに、従来の単一 trial_all_v22.stl が ASCII 変換後に
  約 5.68MB となり、GitHub への push（push-files）のサイズ
  上限（HTTP 413）に当たることが判明したため、trial_all を
  2 ファイルに分割した（各ファイル ASCII 4MB 以下を目安）。

#### B. TRRS 確認ピース

- trial_trrs_{tray,band,frame}_{short,long} の 6 点を、
  build_case.py の試作セクションにクリップ追加した。
- クリップ範囲: x 95〜117.3（トレイ床スロットの内側端
  x=100 の 5mm 内側から背面クリップ上限まで）、y は TRRS
  中心 ±13（short 54.2〜80.2／long 67.3〜93.3）。ジャック
  占有（x 106〜背面、y 中心 ±3.25）とプラグ開口（幅 11.0、
  逃げの内側端 x=100）を含み、開口の両側に壁が残る最小限の
  範囲とした。実基板のタブ＋ジャックをはめ、プラグの
  挿し込みまで試せる。
- 体積: short tray 889／band 42／frame 1,562、long tray
  906／band 144／frame 2,165 mm³。band_short が小さいのは、
  開口脇の壁フラグメントだけがバンド材料として残るため
  （開口〜パドル窓間は §17.22 のトレイ付属セグメントで、
  バンド材料がない）。
- 検証（新規 check_trrs_trial.py）: 全ピースが単一ソリッド・
  watertight。ピースを組立座標に戻した状態で、ジャック
  実体エンベロープ（裏面から 5.1、下端 z 0.6）との干渉 0、
  プラグ模擬（胴体 Ø6.5・ピン Ø3.5、軸 z 2.6／3.0／3.4）
  との干渉 0、開口幅走査（中心 ±5.4 が空き・±7.0 で壁が
  残る）も OK。これにより §17.22 F-1 の扱いは「軸 z 推定
  （±0.4）の実物確認は、本印刷前に TRRS ピースで可能」に
  変わる（軸自体は未実測のまま）。

#### C. スイッチ穴ピースの除外

- build_case.py での trial_plate_holes 生成を停止し、
  design 側の trial_plate_holes.stl は削除した。
  make_trial_all の構成からも除外した。

#### D. trial_all の 2 ファイル分割

- trial_all_1.stl: short 系 7 点（階段バンド＋角トレイ／
  バンド／フレーム＋TRRS トレイ／バンド／フレーム）＋
  プランジャ 3 個 ＝ 10 ピース。バイナリ 614,284 bytes／
  ASCII 2,876,414 bytes。
- trial_all_2.stl: long 系 7 点＋プランジャ 3 個 ＝ 10
  ピース。バイナリ 723,084 bytes／ASCII 3,387,701 bytes。
- 合計 20 ピース（従来 15 − 穴ピース 1 ＋ TRRS 6）。
  make_trial_all.py は系ごとの 2 グループ構成に書き換えた。
- 配置検証: 各ファイルとも 180×180 内・全ピース watertight・
  z=0 着座・間隔の実測最小 3.05。なお予約間隔（GAP）は
  3.0 → 3.05 に微増した（浮動小数点とハル距離の丸めで
  公称 3.0 を僅かに割り、検証アサーションに落ちたための
  余裕分。検証側の要求は実測 3.0 以上のまま）。
- verify_stl: TRRS ピース 6 点は comp=1・nonmanifold=0 で
  OK。分割ファイルは comp=10（ピース数どおり）・
  nonmanifold=0・minz=0。
- ガイド図 guide_trial_all_v22.png は、2 ファイル分の配置を
  並べた 2 パネル（各パネルにファイル名とピース数入り）に
  再生成した。
- 旧 trial_all_v22.stl は削除候補: design 側は削除済み。
  リモートに残る旧版（v2.4.7 の 17 ピース版）および
  staging 側の旧版・trial_plate_holes.stl の削除は、
  push 側の判断に委ねる（本ラウンドでは staging の
  既存ファイルは削除していない）。

#### E. 変更ファイル

- build_case.py（試作セクション: TRRS クリップ追加、
  穴ピース生成停止、コメント更新）
- make_trial_all.py（2 ファイル分割構成に書き換え）
- check_trrs_trial.py（新規）
- 新規 STL: trial_trrs_{tray,band,frame}_{short,long}
  （6 点）、trial_all_1.stl、trial_all_2.stl
- guide_trial_all_v22.png（2 パネルに再生成）
- 削除（design 側）: trial_plate_holes.stl、trial_all_v22.stl
- 本体パーツ（プレート／フレーム／トレイ／バンド、両半分）は
  本ラウンドで形状変更なし（再書き出し時の体積が v2.4.10 と
  全て一致することを確認済み）。

### 17.26 v2.4.12: タクト中心の実測是正・プランジャ差し込み口・タクト帯フード・試作ピース作り替え（2026-11-06）

#### A. 経緯

- v2.4.11 試作の実物確認（2026-11-06 夜、本人）: 階段バンドの
  当たりは両側とも良好。一方タクト部は両側とも NG で、フレーム
  角ピースのタクト用穴が全部 USB 側（奥フチ側）へずれて余裕が
  なく、プランジャを入れてもタクト中心に合わない（写真
  7485〜7487）。
- 本人が short 基板で実測（写真 7488）: タクトの奥行き
  （x 方向）= 3.4mm、基板の背面フチからタクトの近い側の端まで
  = 0.5mm。あわせて「マイコンのフットプリントの端からタクト
  タブまで = 10mm」（short 実測、long も同じとの本人申告。
  照合は F）。
- 本人からの追加指示: (1) 試作ピースは角／TRRS の小片でなく
  「タクトから TRRS まわり、バンドまでつなげたやつ」に作り
  替える、(2) 試作ピースに番号を浮き彫りで入れる（「パズル
  すぎて難しい」）、(3) サポートなしで印刷できる向きにする、
  (4) 「フレームにしたらプランジャはめられなくない？」の
  確認（→ C で組立不能が判明）。

#### B. タクト中心 x の実測是正

- 中心は基板背面フチから 0.5 + 3.4/2 = 2.2mm 手前。換算の
  基準は基板背面プレーン（outline3 の straighten_back 直線、
  template/OUTLINE3_NOTES）: short は x = 113.561 + 0.001748y
  （タクト帯中心 y=119 で 113.77）、long は x = 113.175 +
  0.002620y（帯中心 y=24.5 で 113.24）。帯内での変動は
  ±0.03 未満で無視した。
- 採用値: **TACT_X = {short: 111.57, long: 111.04}**（半分別に
  変更）。検討過程で出た 112.09（= 114.29 − 2.2）はケース
  外形（DXF）の背面フェイス基準で、キャビティ（outline3
  基準）に座る基板に対して short +0.52／long +1.05 の残留
  ずれになるため採用しなかった。
- 旧推定 106.5 との差は short +5.07／long +4.54。これが
  「穴が全部ずれてる・余裕がない」の主因。
- タクト形状モデルも実測に是正: 平面 3.4(x) × 6.0(y)（従来は
  x 6.0 幅ボックス）。波及先: フレームのガイド穴・座ぐり
  （中心のみ）、タクト逃げスロット（不変更で被覆）、プレート
  背面ノッチ（TACT_NOTCH_X0/X1 = 102.5/111.5 → **108.3/
  115.3**、実体内側端 −1.0／背面端 +2.0 の従来ルール）、
  check_paddle_real／check_plunger のタクトモデル、
  render_guide_onboard の描画。
- プレート体積は short 10363.2 → 10443.3（+80.1）、long
  12398.8 → 12478.2（+79.4）。ノッチ縮小分のみ。

#### C. プランジャが入らない問題と差し込み口（本人の指摘が正しかった）

- 現行（v2.4.5〜）の受けはガイド穴 Ø5.4・座ぐり Ø8.6 の閉じた
  穴で、プランジャのキャップ Ø8 もフランジ Ø7 も穴を通らず、
  上からも下からも入れる経路が存在しなかった（組立不能）。
  check_plunger は従来、組立状態と押下スイープしか見ておらず、
  挿入経路は未検証だった。本ラウンドで挿入スイープを追加。
- 新中心では座ぐり Ø8.6 が背面フェイス（タクト帯で 114.23）
  へ開く（残壁 short −1.64／long −1.11 = 貫通）。ただし開口の
  弦幅（short 約 6.8）ではキャップ Ø8 が通らないため、座ぐりと
  ガイド穴に背面までの差し込み口を意図的に整形した:
  座ぐり帯（z 14.1〜天面）は幅 **8.4**、ガイド帯（z 12.9〜
  14.15）は幅 **5.0**。座ぐり間のウェブは最小 1.1（ピッチ
  9.5 − 8.4）になる（報告事項）。
- プランジャ側の変更（左右共通部品のまま）:
  - 背面を D 字にクリップ（中心 +2.36、short 基準で組立背面が
    フェイス −0.3 = 113.93 に収まる。long では 113.40）。
    軸 Ø4.6 と受け凹み Ø4 はクリップに触れない。
  - 受け凹みから差し込みの進行方向（前面側 −x）へ幅 2.6・
    深さ 0.9 の通り溝を追加。後ろから差し込むとき、先端
    （Ø2、先端 z 12.5）はプランジャの前面側から相対的に
    入って溝を通り、中心の凹みに収まる。溝天井は凹み天井と
    同一面（z 12.8）で、押下時の当たり・静止間隔 0.3 は不変。
  - 体積 165.9 → 143.3mm³。
- 入れ方（確定）: フレームを基板に載せたままでも、載せる前
  でも、プランジャの平らな面を後ろに向けて背面の差し込み口
  から水平に差し込む。抜け止めは従来どおりフランジ（±3.5 >
  ガイド穴 ±2.7）、ストッパはキャップ下面→座ぐり床（1.1）。
  フレーム単体ではプランジャは 1.1 落ちるがキャップが座ぐり
  床に当たって保持される（軸のガイド帯かかり 1.2 が残る）。
- 検証（check_plunger 拡張）: 差し込みスイープ（中心 +8 →
  0、0.5 刻み）で、フレーム単体（静止高さ／落下高さ −1.1）と
  基板載せ状態（タクト実体＋先端が実在）の全行程で干渉 0。
  押下スイープ・ストッパ（−1.3 で食い込み >0）・受け凹み
  間隔 0.3 も従来どおり成立。

#### D. タクト帯フード（走査で見つけたフレーム側の欠陥）

- 実形状の走査で判明: タクト帯ではフレーム上面の実材は
  x≈107 まで（well 縁の帯のみ）で、実測中心の受けは空中に
  浮く。v2.4.5 以来の想定「屋根の実材は x≈104.5〜背面
  フェイス」は誤りだった（過去の実物写真で穴が帯の縁に
  かかっていたこととも一致する）。
- さらにケース外形の背面は基板の歯形に沿ってタクト間で
  x≈106.25 まで窪むため、外形どおりの屋根では受けを囲えない。
- 対策: タクト帯（最初と最後のタクト中心 ±6.5）に限り、
  フレームの背面を歯の面（外形の最大 x）まで真っ直ぐに
  伸ばしたフードを z 13.2（スロット上面、フランジとの遊び
  0.3 を維持）〜16.1 に追加した。本家のアルミケースも背面は
  真っ直ぐで、これに倣う形。内側端 x=103 は従来の帯の前面に
  揃えた。トレイ／バンドの外形は変更しない（フードの下は
  窪みが残り、タクトの歯と本体が入る）。
- フレーム体積: short 22857.5 → 23153.4（+295.9）、long
  32662.6 → 32919.9（+257.3）。check_plunger のプローブで、
  フードが受けを囲むこと（座ぐり後ろ角の実材、座ぐり床の
  後方支持）を両半分とも確認。ドッキング（全幅 302.61、
  D* 干渉 0）にも影響なし。

#### E. 試作ピースの作り替え・番号・印刷向き

- 旧 trial_corner_*（6 点）と trial_trrs_*（6 点）を廃止し、
  **trial_back_{tray,band,frame}_{short,long}**（6 点）に統合。
  クリップ: x は角ピースと同じ 80〜117.3、y は TRRS 中心
  ∓13 から外側端まで（short 54.2〜146.4／long −3〜93.3）で、
  タクト角〜TRRS 帯＋余裕を一続きにした。
- バンドだけ幅いっぱい（x −3〜117.3）に切り出す: バンドの
  背面壁は断片的で（背面の壁は区間によりトレイ側が担う）、
  背面帯だけでは 2 個に割れるため。さらに TRRS 開口と
  パドル窓の間の背面リボン（short 42mm³／long 144mm³）は
  この範囲では島になる（実物では範囲外のリボン経由で
  つながる）ため、最大ソリッドのみ残して含めていない。
  この島が担う TRRS 開口脇の壁は、本体側 check_trrs で
  確認済み（check_trrs_trial は島側の壁を要求しない形に
  注記付きで変更）。
- 番号の浮き彫り（約 4mm 高さ・0.5mm 浮き出し）:
  1=階段バンド(short)／2=帯トレイ(short)／3=帯バンド
  (short)／4=帯フレーム(short)／5=階段バンド(long)／
  6=帯トレイ(long)／7=帯バンド(long)／8=帯フレーム(long)。
  プランジャは無印。配置はトレイ=床上面、バンド類=上面の
  平坦部、フレーム=外側端面（反転後に正しく読める向き）。
  いずれも単一ソリッド・watertight を維持し、体積増分で
  密着を検証した。
- trial_all は各ファイル 7 ピース（帯 3＋階段バンド 1＋
  プランジャ 3）に再構成。配置は 180×180 内・間隔実測
  最小 3.05・z=0 着座。
- サポートなし印刷: 帯フレームは trial_all の中で天地逆
  （天面をベッド側）に配置し、キャビティを上向きポケットに
  した。ガイド図に各ピースの「下にする面」を明記。
  点検で残る張り出し: (1) バンドのレッジ下面の棚（潜り
  1.5mm、短い張り出し）、(2) フレーム帯を反転せずに刷った
  場合のキャビティ天井（だから反転が前提）、(3) 差し込み口
  まわりの小さな天井面。朝の印刷失敗は、フレーム角ピースの
  天井面（キャビティ・スロット天井）がサポートなしで垂れる
  構造だったことが一因の可能性が高い（反転で解消する想定）。

#### F. 「10mm」実測の照合（マイコン端〜タクトタブ）

- 読み方の一つ（基板外側端→最遠タクト）ではモデルと整合:
  short 基板外形の背面側 y 最大 138.45 − 最遠タクト中心
  128.5 = **9.95 ≈ 10**。
- ただしモデルに MCU フットプリントの厳密形状はなく
  （MCU_ZONE は y 106.0〜143.4 の禁止域、トレイの MCU
  ポケットは外形 y=105.36 から）、もし実測が「フット
  プリントの内側端 → 最寄りタクト中心（109.5）」の意味なら
  フットプリントは y≈99.5 まで及ぶことになり、モデルと
  6.5mm 食い違う可能性がある。**指摘のみで、y 位置は
  変更していない**（実物での確認候補）。

#### G. 検証結果

- check_plunger: **ALL OK**（受けの開口・差し込み口・支持・
  フード実材のプローブ、静止／押下スイープ、差し込み
  スイープ 3 条件すべて干渉 0、両半分・全 6 タクト）。
- check_paddle_real: タクト実体（3.4×6.0 是正モデル）との
  干渉 全条件 0。check_trrs: OK。check_trrs_trial: OK
  （島側の壁注記あり）。check_v21: 壁キャップ内（max 2.19
  ≤ 2.2）。check_dock: 全幅 302.61 不変、D* 干渉 0。
  check_plate_ring／check_plate_openings: OK。
  check_usb_channel: PASS。check_socket_ledge: ALL OK。
- verify_stl: 個別ピース・本体は全て comp=1・nonmanifold=0。
  trial_all_1／2 は comp=7（ピース数どおり）・nonmanifold=0・
  minz=0。
- 体積の不変確認: トレイ（34260.6／44032.9）、バンド
  （3716.9／5129.9）、階段バンド（1566.2／2053.0）は
  v2.4.11 から完全一致。変わったのはプレート（B）、
  フレーム（C＋D）、プランジャ（C）と試作ピースのみ。

#### H. 変更ファイル

- build_case.py（TACT_X 半分別＋タクト形状定数、ノッチ
  範囲、差し込み口カット、プランジャの D クリップ＋通り溝、
  タクト帯フード、試作セクションを背面帯に置換）
- check_plunger.py（実プランジャ形状で検証、差し込み
  スイープ追加、受けプローブ更新）
- check_paddle_real.py（タクト実体を 3.4×6.0・半分別中心に）
- check_trrs_trial.py（trial_back_* に追随、島側注記）
- make_trial_all.py（新構成、番号浮き彫り、フレーム反転、
  ガイド図更新）
- render_guide_onboard.py（TACT_X 追随。staging 非対象）
- 新規 STL: trial_back_{tray,band,frame}_{short,long}、
  再生成: top_frame／switch_plate（両半分）、plunger、
  trial_all_1／trial_all_2、guide_trial_all_v22.png
- 削除（design 側）: trial_corner_*（6 点）、trial_trrs_*
  （6 点）

### 17.27 v2.4.13: 番号浮き彫りの一部撤回（2026-11-06）

#### A. 経緯

- v2.4.12 試作の実物確認で、本人から「番号を入れたせいで
  印刷がうまくいかない」と報告。問題があるのは番号
  1・3・5・7（階段バンド short／long と背面帯バンド
  short／long）で、180 度回して当てると数字の出っ張りが
  当て面に来て邪魔になるとのこと。他の 2・4・6・8
  （帯トレイ・帯フレーム）は大丈夫との本人申告。

#### B. 対応（浮き彫りの撤回範囲）

- make_trial_all.py に NO_DIGIT_NUMBERS = {1, 3, 5, 7} を
  導入し、この 4 ピースは浮き彫りなしで trial_all を
  再生成した。体積は彫刻前のソース STL と完全一致
  （階段バンド 1566.2／2053.0、帯バンド 2046.5／2021.6）。
- 浮き彫り自体は v2.4.12 から make_trial_all.py 内でのみ
  付けていたため、個別の trial_back_* STL と本体パーツは
  無変更（ハッシュ照合で変化は trial_all_1／2 のみ）。

#### C. 残した番号の面検証

- フレーム（4・8）: 浮き彫りの増分ソリッドで検証。数字は
  外側端面（y 端の垂直面）に片側だけ 0.50mm 出っ張り、
  z は 3.2〜7.2 で壁の内側に収まる。天地逆の印刷姿勢でも
  数字の下端は z=3.20 でベッド面に来ず、反転後も端面に
  ある。当て面でもベッド面でもないため残置。
- トレイ long（6）: 数字は床上面（z=2.5）に置くが、天面
  z=3.0 はソケット下面（z=2.7、§17.23 の張り出し 3.0mm
  仮定）より上に出る。そこで §17.23 の 14mm 角プロキシ
  （最も保守的なソケット包絡）に 0.3mm マージンを足して
  xy の重なりを判定した。既定位置など複数候補が重なったが、
  ケース座標 x 86.7〜90.7／y 61.7〜64.7 の位置で包絡を
  回避できたため残置。
- トレイ short（2）: 同じ探索で 12 候補すべてがソケット
  包絡に重なった（背面帯の床はソケットが密で、数字の
  置き場がない）。このピースだけ浮き彫りを外して無地に
  した。ガイド図の並びと形で見分ける。

#### D. ガイド図と検証

- guide_trial_all_v22.png を更新: 注記を「番号の浮き彫りは
  4・6・8 のピースにだけある。1・2・3・5・7 は無地なので
  図の並びと形で見分ける」に変更。図の番号自体は全ピース
  分を表示する（無地ピースの見分け用）。
- verify_stl: trial_all_1／2 とも comp=7（ピース数どおり）
  ・nonmanifold=0・minz=0。全ピース watertight・winding
  一貫。ピース間隔の実測最小 3.05、180×180 内、サポート
  なし前提の向き（帯フレームは天地逆）は v2.4.12 から維持。
- 変更ファイル: make_trial_all.py、DESIGN_NOTES.md
  （本節）、再生成: trial_all_1／trial_all_2、
  guide_trial_all_v22.png。staging へ同期済み（STL は
  ASCII 変換し体積一致を確認）。

### 17.28 v2.4.14: タクト中心 y のバンド基準是正（short・暫定）・位置バリエーション試作・TRRS／プランジャ高さの調査メモ・印刷向きの恒常ルール（2026-11-07）

#### A. 経緯と、ずれている軸の特定

- 実物報告の流れ: 差し込み口が合わない（写真 7496）→ フレームの
  タクト穴（座ぐり）が並び方向にずれている（写真 7498、3 個とも
  同じ向き・同じ量）→ タクトに合わせると基板の座りが浅い
  （写真 7499）→ 途中で止めたピース（v2.4.12 の trial_all の
  帯フレーム。フレーム形状は現行 v2.4.13 と同一で違いは番号
  だけ、と本人確認済み）をタクトに合わせて置くと、正しく
  座っているバンドに対して 1.8〜2.0mm ずれる（写真 7501）。
- 軸の判定: バンドは実物で合っており、フレームの座りは外形と
  座面で決まる。そのバンドを基準に測った 1.8〜2.0mm は、
  フレームの座面（基板の外側端）とタクト穴の相対関係そのもの
  であり、ずれている軸は並び方向（ケース座標 y）と特定した。
  写真 7500 でも、差し込んだプランジャがタクトの横（並び
  方向）にずれて見えることと一致する。
- x（奥行き、TACT_X −1.9）候補を棄却した根拠:
  (1) 奥行きは本人のノギス実測（基板の背面フチからタクトの
  端まで 0.5mm、タクトの奥行き 3.4mm、§17.26）が直接測定で、
  TACT_X はその換算値。
  (2) 写真 7498 の画素計測では、並び方向にタクト中心が座ぐり
  中心から画像左（外側端側）へ 6〜10px ずれる（座ぐりピッチ
  166.5px = 9.5mm からスケール 17.5px/mm、ずれ 0.34〜0.57mm。
  座らせ方に依存する参考値だが、向きは外側端側で一貫）。
  (3) 基板スキャン（7378／7379）の fit は回転をモデル化して
  おらず inlier も 3 点のみで、角部では mm 級の系統誤差が
  ありうる。tact_mat の blob 重心（x≈106）は端子パッドを
  含む重心で筐体の中心ではない。x の 1.9mm ずれを裏付ける
  実測はない。
- short と long の扱いの差: short の §17.18 値は対称性からの
  導出で直接実測がない（誤差が残る候補）。long は写真注記の
  チェーンによる直接導出で、実物の当たりも「よさげ」と確認
  済み。スキャンの blob 値（long y [35.99, 23.68, 14.17]）と
  旧モデル [34.0, 24.5, 15.0] の差は [+2.0, −0.8, −0.8] と
  非一様で、系統ずれは見えない。よって是正は short のみ。

#### B. 修正（暫定値、確定は C の実物判定）

- TACT_CENTERS["short"]: [109.5, 119.0, 128.5] →
  **[111.4, 120.9, 130.4]**（+1.9、外側端方向）。追随する
  形状: フレームのパドルスロット・連結帯・タクト帯フード・
  ガイド穴／座ぐり／差し込み口、プレート背面縁のタクト逃げ
  ノッチ（中心のみ。TACT_NOTCH_X0/X1 は x の値で不変更）。
- パドル窓（トレイ／バンド）・背面ネジ計画の除外帯・TRRS
  島区間は、旧中心のまま PADDLE_SPAN_CENTERS に分離して
  固定した。窓の合成帯（short 104.1〜133.9）に対し是正後の
  タクト実体は 108.4〜133.4 で内側に収まる。トレイ／バンド
  の体積は v2.4.11 から完全一致（34260.6／44032.9、
  3716.9／5129.9）で無変更。
- TACT_X は変更しない（short 111.57／long 111.04）。
  long の TACT_CENTERS も変更しない。

#### C. 位置バリエーション試作（trial_tact_variants.stl）

- 本人決定: 試作はフレームのタクト角だけ、ずらし量を変えた
  数種類を 1 回で印刷して決める。差し込み口も含める（角を
  そのまま切り出し、位置が合ったピースでプランジャの
  差し込みも試せるように）。
- 構成（short のみ）: y（外側端へ）{+1.5, +1.9, +2.3} ×
  x {0, −1.9} の 6 種の角フレーム（差し込み口込み）＋
  プランジャ各種 3 個（横倒し、F の向きルール）。
  単体 STL は trial_tact_frame_short_s{15,19,23}[_x19].stl
  （build_case を環境変数 TACT_VARIANT_STEP／TACT_VARIANT_DX
  で回して生成）。統合は make_tact_variants.py、ガイド図は
  guide_tact_variants.png。
- 判別: 外側端面（当て面でもベッド面でもない面、§17.27 で
  浮き彫り残置が OK だった面）に、彫り込み（凹み、深さ
  0.5mm）で 2 行「Y<量>」「X<量>」を入れた。組立向きで
  彫るため、ピースを当てる向きに戻せばそのまま読める。
  彫り込み体積は 1 行あたり 2.3〜4.5mm3、彫った後も各
  ピース 1 ソリッド・watertight を検証。
- 統合ファイル検証: comp=24（6 ピース＋プランジャ 18）、
  nonmanifold=0、minz=0、ピース間隔の最小 3.05、180×180 内。
- あわせて trial_all_1／2 はタクト角ピース（暫定 +1.9／
  long 従来値）＋プランジャ 3 個の構成に組み替えた
  （make_trial_all.py の GROUPS 変更）。

#### D. TRRS 端（帯フレーム）の調査メモ（本修正は位置確定後）

- モデル計測（帯フレーム・本番フレームとも）: TRRS ジャック
  本体の包絡（中心 y ±3.0、z 0.6〜5.7、x 104〜114.3）との
  干渉 0。プラグ包絡（Ø6.5、軸 z 2.6／3.0／3.4）との干渉も
  0。帯の TRRS 側の端とジャック本体の y 端との間隔は
  10.0mm（両半分とも）。
- 実物で当たる理由の説明: フレームをタクトに合わせて
  ずらすと、フレーム側の TRRS 逃げ（中心 ±5.5）も一緒に
  ずれる。ずらしが 2〜3mm になるとプラグ端（±3.25）が
  逃げの端を割り、z 5.7〜6.25 の帯で当たる計算になる。
  つまり B の δy と同じ根で、帯自体の長さの問題ではない。
  切り詰めはせず、位置が確定すれば逃げは中心に戻る。

#### E. プランジャ高さの調査メモ（本修正は位置確定後）

- モデル数値: 組立時の静止位置は、受け凹みの天井（z 12.8）
  とタクト先端（z 12.5）の間隔 0.3 で決まる。天面からの
  突出は +1.1（キャップ天面 z 17.2）。フレーム単体では
  キャップが座ぐり床（z 14.1）に落ちて静止より −1.1
  （突出 0、フランジ下面 z 10.8、タクト本体上面 10.6 の
  0.2 上）。
- 試作ピース（帯・タクト角とも）と本番フレームで、座ぐり床
  とスロット上面の z は同一（レイプローブで case z 14.1／
  13.2 を全ピースで確認）。ピース側に静止位置のずれはない。
- 写真 7500 の読み: フランジ下面の位置はフレーム単体の
  落下位置（組立静止より約 1.1 低い）に相当する。y ずれで
  タクト先端（Ø2）が受け凹み（Ø4）から外れ気味になり、
  プランジャを持ち上げられない状態と整合する。本人の
  「2mm ほど高く」は、落下量 1.1＋凹み深さ 0.9 の見え方
  とも合う。まず位置を確定し、それでも低いかで判断する。
- 用意した直し方（未実施）: (a) 単に低くて押しにくい場合:
  キャップ厚 2.0 → 3.0 で天面だけ +1.0（キャップ下面と
  ストッパの当たりは不変）。(b) 静止で押しっぱなし気味の
  場合: 軸 −0.5＋フランジ厚 +0.5 で凹み天井を +0.5
  （スロット上面 13.2 → 13.7 への追随が必要）。
- 差し込みスイープの落下高さ干渉（基板載せ＋dz −0.5〜
  −1.1 でタクト先端と 0.6〜2.5mm3）について: 先端が凹みに
  入る前提では、先端が dz −0.3 で天井に触れてプランジャを
  持ち上げるため、その状態は物理的に起きない。実際に
  起きていたのは y ずれで先端が凹みを外していたケースで、
  位置の確定後に再検証する。

#### F. 印刷向きの恒常ルール（本人指定）

- 本人の印刷時の向き: バンド・階段は 180 度、プランジャは
  90 度横倒し。以後の書き出しはこの向きで出す。
- 実装範囲: 印刷用統合ファイル（trial_all、
  trial_tact_variants）で適用する。バンド類（背面帯バンド・
  階段バンド）は平面内で 180° 回転し、pack の 90° 回転は
  かけない。プランジャは背面クリップでできた平らな面
  （D 字の平面）を下にした横倒し（軸は水平、下にする面は
  その平面）。単体の STL は組立座標の正本のままにする
  （check 群が座標に依存するため）。

#### G. 検証結果

- check_plunger: **ALL OK**（新中心で受け・差し込み口・
  支持・フードのプローブ、静止／押下／差し込みスイープ
  すべて干渉 0、両半分・全 6 タクト）。
- check_paddle_real: タクト実体との干渉 全条件 0。
  check_trrs: OK。check_trrs_trial: OK。
  check_v21: 壁キャップ内。check_dock: 全幅 302.61 不変、
  D* 干渉 0。check_plate_ring／check_plate_openings: OK。
  check_usb_channel: PASS。check_socket_ledge: DONE。
- verify_stl: 本体・個別ピースは comp=1・nonmanifold=0。
  trial_all_1／2 は comp=4、trial_tact_variants は comp=24
  （ピース数どおり）・nonmanifold=0・minz=0。
- 体積: フレーム short 23153.4 → 23061.0、long は
  32919.9 で v2.4.12 と一致（是正を差し戻したため）。
  プレート short 10443.3／long 12478.2（ノッチ中心の
  移動のみで v2.4.12 と同値）。帯フレーム short は
  5196.6（中心追随で変化）、long は従来どおり。

#### H. 変更ファイル

- build_case.py（TACT_CENTERS short 是正、PADDLE_SPAN_CENTERS
  の分離、タクト角ピース trial_tact_frame の追加、
  バリエーション用の環境変数 TACT_VARIANT_STEP／DX）
- make_trial_all.py（角ピースだけの構成、バンド 180°／
  プランジャ横倒しの向きルール、ガイド図の注記更新）
- make_tact_variants.py（新規: 彫り込み＋6 種統合＋ガイド図）
- 再生成 STL: top_frame_short、switch_plate_short
  （ノッチ中心の移動のみ、体積は同値）、
  trial_back_frame_short、trial_tact_frame_{short,long}、
  trial_all_1／2、trial_tact_frame_short_s{15,19,23}[_x19]
  （6 種・新規）、trial_tact_variants（新規）、
  guide_trial_all_v22.png、guide_tact_variants.png（新規）
- 無変更（体積一致で確認）: トレイ／バンド／プレート long／
  フレーム long、階段バンド、帯トレイ／帯バンド、プランジャ

#### I. リポジトリ収録時の分割（追記）

- trial_tact_variants.stl は ASCII で約 10.6MB あり、GitHub
  連携の単一ファイル上限（約 5MB）を超えるため、リポジトリへは
  次の 2 ファイルに分割して収録する:
  - design/trial_tact_variants_1.stl: x0 群（s15／s19／s23、
    各フレームにプランジャ 3 個ずつ、計 12 ピース、22,674 面）
  - design/trial_tact_variants_2.stl: x19 群（s15_x19／
    s19_x19／s23_x19、各フレームにプランジャ 3 個ずつ、
    計 12 ピース、22,512 面）
- 分割は統合ファイルのソリッドをそのまま群ごとに分けたもので、
  配置・向き・ピース間隔（最小 3.05）は統合版と同一。
  収録する 2 ファイルは単一ファイル上限に収めるため、ASCII の
  数値表記のみを短縮している（座標値は同一で、形状・配置・
  体積は変わらないことを再読み込みで確認済み）。
  ガイド図 guide_tact_variants.png の並びは 2 ファイルの合体と
  一致する。検証: 各ファイル comp=12・全ソリッド watertight・
  nonmanifold=0・minz=0、体積合計 16,858.5 で統合版と一致。
- ローカルの trial_tact_variants.stl が正本（make_tact_variants.py
  の再生成で統合版が得られる）。

### 17.29 v2.4.15: long タクト中心の同等検証（断定できず）・long 用バリエーション試作（2026-11-07）

#### A. 経緯と結論

- §17.28 で short のタクト中心が並び方向（y）に +1.9 ずれていた
  ことが判明したのを受け、本人指示「ショートがずれてるんだから、
  ロングも確認して」で、long 側の「フレームの座面（基板の外側端）
  からタクト穴中心までの相対関係」を short と同じ厳しさで検証した。
- **結論: 現行値 [15.0, 24.5, 34.0] が誤りという証拠はないが、
  「合っている」とも断定できない。** 残る不確かさは ±1mm 級で、
  座ぐり Ø8.6 とハウジング幅 6.0 の遊び（偏心 ±1.3 が上限）に対して
  無視できない。よって D のバリエーション試作で実物判定に回す。
  production 値（TACT_CENTERS["long"]、TACT_X["long"]）は無変更。

#### B. §17.18 導出の再点検（long は直接チェーン、鏡像は不使用）

- long の中心は写真 7464（long 裏面接写、本人赤注記）のノギス
  読みチェーンで導出されている: ピン線 83.5 −6.2 → 77.3
  （ジャック外面）−36.6 → 40.7 −29.5 → 11.2。端面（ケース座標
  y=5.11、outline3 の最小 y と一致）から 9.8 → 最寄り中心 14.91。
  間隔は画素計測 ≈9.5。背面列ソケット L17（DXF (36.56, 15.01)、
  スキャン実測 (36.60, 15.18)）と中心 14.91 が 0.10 一致。
- チェーン自体の内部のたるみ: 最後のホップ 11.2 は中心 14.91 の
  端（11.91）から約 0.7 ずれる。ソケットとの一致は整合性の確認で
  あって、機械的な証明ではない。
- **short の +1.9 の発生機序は long に及ばない**: short は
  (1) long の端面距離 9.8 を「位置関係はロング側と一緒」として
  流用する鏡像仮定と、(2) 写真 7466 の「10」アンカーで導出した。
  実物の short の端面距離は 8.05（是正後中心 130.4 から逆算）で、
  両半分はこの寸法が非対称だった。long は自基板の直接チェーンで、
  (1)(2) のどちらも使っていない。
- ただし例外が 1 つある: **TACT_X の奥行き 2.2mm は §17.26 で
  short 基板で実測した値を long に流用したもの**（背面プレーン
  だけ long 自身の 113.24）。同種の流用なので、バリエーション
  試作の x 軸（0 / −1.9）で併せて実物確認する。

#### C. 独立再導出の試行（いずれも決め手にならず）

1. 基板スキャン（マット写真 7378/7379）の tact_mat blob 重心:
   long y = [35.99, 23.68, 14.17]（現行比 [+1.0, −0.8, −0.8]、
   非一様）。ただし fit は inlier 3/33 点のみで、**同じ手法は
   short で実物 130.4 に対し 121.79（約 8.7 の誤差）を出す**
   ことが判明済み → 1mm 級の判定には無力。
2. スキャン 7375（表面）のガイド付きアフィン登録: 27/31
   inlier、RMS 0.177mm、特異値 6.918/6.862 px/mm（ほぼ等方）で
   登録自体は良好。しかしタクト帯は焦点・コントラスト不足で
   缶中心を決定的に測れなかった。
3. 写真 7464 の画素再計測: 缶 bbox 中心は元画像 px で
   1140.6 / 1294.4 / 1442.5（ピッチ ≈151px）。赤線の重心は
   422.1 / 525.6（"6.2" の線対）と 1063.6 / 1472.9 / 1632.9。
   区間ごとのスケールが 13.9〜16.7 px/mm とばらつき（斜め撮影）、
   タブ端エッジの読みも 1486〜1507px と揺れるため、端面→中心 #1
   の推定が前提次第で約 3〜12mm に分散する → 9.8 の肯定も
   否定もできない。
4. 実物の当たり（写真 7489「よさげ」）: 座ぐり Ø8.6 への収まり
   から誤差 ≲1.0〜1.3mm と言えるが定性的。1.9mm 級の誤差は
   否定的だが、±1mm 級は残る。

#### D. long 用バリエーション試作（short と同形式）

- 構成: y {−1.9, 0, +1.9}（現行中心比。**マイナス側が外側端
  方向 = short の誤差と同方向**）× x {0, −1.9} の角フレーム
  6 種（差し込み口込み）＋プランジャ各種 3 個（横倒し）。
  Y0.0 / X0.0 のピースが現行 production 形状そのもの（対照用）。
- build_case.py のバリエーション機構を一般化: 環境変数
  TACT_VARIANT_HALF（既定 "short"）と TACT_VARIANT_TAG を追加。
  既定では従来どおり short 用に動作し、通常ビルドの production
  STL は編集前後でハッシュ一致（無回帰）を確認済み。
  単体名は trial_tact_frame_long_{m19,s0,s19}[_x19].stl。
  s0 単体は production の trial_tact_frame_long.stl と
  バイト一致（機構が現行形状を正確に再現することの確認）。
- 彫り込み文字: long の外側端面（y 最小面）に "Y<量>" / "X<量>"
  （深さ 0.5）。**このとき副次的に判明: §17.28 の short 版の
  彫り込みは、組立向きで端面を外から見ると鏡像になる**
  （除去領域のラスタ実測で確認。印刷前のため実害はまだない）。
  long 版は文字ポリゴンを左右反転してから determinant が正の
  回転で配置し、同じラスタ確認で外から正しく読めることを
  検証済み（"Y-1.9" / "X0.0" を確認）。**short 版の彫り込み
  修正は本節では未実施**（make_tact_variants.py の text_cutter
  に同じ反転を入れて再生成すれば直る。印刷前に要対応）。
- 統合ファイル trial_tact_variants_long.stl（ローカル正本）と
  ガイド図 guide_tact_variants_long.png を生成。
  再生成は make_tact_variants_long.py。

#### E. 検証結果

- 単体 6 種: すべて単一ソリッド・watertight。穴位置プローブ
  合格（各バリエーションの座ぐり中心 3 点 = 空洞、隣接座ぐりの
  中点の壁 = 実材、を設定値どおりに確認）。
- 統合ファイル: 24 ピース（フレーム 6 + プランジャ 18）、
  bbox 176.6 × 172.4（A1 mini の 180×180 内）、最小間隔 3.05、
  nonmanifold = 0、minz = 0。verify_stl の verdict は複数
  ピースのため NG 表示だが、これは short 統合版（comp=24）と
  同じプロファイルで異常ではない。
- staging の ASCII 版 trial_tact_variants_long.stl は
  10,625,823 バイトで、**push する場合は §17.28-I と同じ
  2 ファイル分割（x0 群 / x19 群）が必要**（今回は staging
  同期までで、分割ファイルは未作成・push はしていない）。
  ASCII 変換は convert_stl.py が trial_tact_variants_{1,2}.stl
  （ASCII 既存）で落ちるため、当該 1 ファイルだけ同形式で
  個別変換した。再読み込みで 24 コンポーネント・体積合計
  17,346.16 の一致を確認済み。

#### F. 変更ファイル（staging 同期済み、push はしていない）

- build_case.py（バリエーション機構の一般化のみ、production
  形状は無変更）
- make_tact_variants_long.py（新規）
- trial_tact_frame_long_{m19,s0,s19,m19_x19,s0_x19,s19_x19}.stl
  （新規・単体）
- trial_tact_variants_long.stl（新規・統合、ローカル正本）
- guide_tact_variants_long.png（新規）
- DESIGN_NOTES.md（本節）

#### G. 次の判定（本人作業）

- short 版と long 版のバリエーション試作を印刷し、バンドを
  正しく座らせた状態でピースを当てて最良の 1 枚を選ぶ。
  long で Y0.0 が最良なら現行中心は実物で裏付けられる。
  選ばれたピースが production と異なる場合、その中心で
  TACT_CENTERS["long"]（および必要なら TACT_X）を是正する。

### 17.30 v2.4.15: フレーム背面壁は TRRS の手前で終わる（前提訂正）

#### A. 前提訂正の経緯

- 2026-11-07 未明、本人明言「壁は TRRS の手前で終わってる」。
  完成形では**フレームの背面壁は TRRS タブの区間に作らない**
  （バンドのタブ帯全高開口と同じ考え方）。
- §17.28-D では「帯が長い／TRRS に当たる」の原因を y ずれに求め、
  「モデル内の帯端とジャックの間隔は 10mm で干渉 0、帯は切り
  詰めない」と結論したが、その前提（壁が TRRS を過ぎても続く）
  自体が完成形と違っていた。y ずれの是正（§17.28 の +1.9 暫定）
  は維持し、壁については本節の訂正を正とする。

#### B. 壁の終了位置と根拠

- 壁なし区間は、トレイ床スロット／バンド全高開口と**同一定義**
  （TRRS_OPEN_W = 11.0 → TRRS 中心 ±5.5）を採用。
  - ジャック本体の包絡： 中心 ±3.25
  - プラグ胴体 Ø6.5： ±3.25（挿抜は背面側からで壁は無関係）
  - 残り： 両側 2.25mm の余裕
- **壁のタクト側端面： short y = 72.7 ／ long y = 74.8**
  （反対側の端面は short 61.7 ／ long 85.8）。short は TRRS
  中心 67.2 + 5.5、long は 80.3 − 5.5（long は TRRS が階段側）。
- 島セグメント区間（short 72.7〜104.1 / long 39.4〜74.8）の
  背面壁は**残す**。この区間はトレイ付属の壁（z 〜5.7）が背面を
  担い、バンドの開口拡張は 1 ソリッド維持のための処置で、壁
  形状自体はトレイ側に保存されている。「壁なし」は TRRS 中心
  ±5.5 の区間だけ。

#### C. 実装

- build_case.py: フレームの TRRS カットを、タブ区間の**全高
  取り除き**に置換（`box(TRRS_CUT_X0 = 100, xmax + 1,
  trrs_y ± 5.5, PCB_BOT − 0.1, FRAME_TOP + 0.3)`）。旧・下帯
  だけのプラグ逃げ（z 6.9 まで）は廃止し、定数 TRRS_FRAME_Z1
  は未使用として記録を残置。
- フード・連結帯はタクト帯（壁なし区間の外）で影響なし。
  背面ネジ穴との干渉もなし（short ネジ y = 29、long ネジ
  y = 59／71／118、71 の穴フチ 72.4 は区間端 74.8 の外側）。
- 帯フレーム試作に島処理を追加: 壁除去で帯クリップ内
  （x 80〜117.3）に階段側の壁セグメントが単体では島になる
  （short y 54.2〜61.7・451.7mm³ / long y 85.8〜93.3・
  716.5mm³）。本体フレームでは前面側を回って連続している
  ため、帯ピースでもバンドのリボン島と同じく最大ソリッド
  のみ残す。
- check_usb_channel.py の項目 4b を前提訂正に合わせて更新:
  旧「フレーム旧開口（z=10.45）が壁に戻っていること」の確認を、
  「区間内は z=10.45 でも開いていること＋区間のすぐ外側
  （|dy|=6.5）では壁が残っていること」に置き換えた。

#### D. 体積・形状の変化

- top_frame_short: 23,061.0 → 22,401（−660）
- top_frame_long: 32,919.9 → 32,179（−741）
- trial_back_frame_short: 5,196.6 → 4,085、y[72.7, 143.4]、
  **全長 70.7mm**（壁の終わる位置 72.7 まで）
- trial_back_frame_long: 5,021、y[0, 74.8]、**全長 74.8mm**
  （壁の終わる位置 74.8 まで）
- プローブ確認: TRRS 中心 y では x ≥ 100 にフレーム材なし。
  両フレームとも solids = 1 のまま。
- 角ピース範囲（short y 100〜146.4 / long y −3〜43）は壁なし
  区間を含まないため、trial_tact_frame_{short,long} の形状は
  不変（体積・面数で従来版と一致）。ただし trial_all_2 には
  §17.28 時点の角ピース（単体 STL と不一致の残り、帯込み
  vol 2,426.9）が入っていたため、現行の角ピース（同
  2,524.9）で組み直した。trial_all_1 は不変。

#### E. short バリエーション彫り込みの鏡像修正（§17.29-D の申し送り）

- §17.29 で判明した「§17.28 の short 版彫り込みは外から見る
  と鏡像」を、long 版と同じ方式で修正: make_tact_variants.py
  の text_cutter で文字ポリゴンを左右反転してから determinant
  が正の回転で配置する。
- 再生成し、カッターの投影ラスタで "Y1.9" / "X0.0" が外側
  （+y）から正しく読めることを確認（除去量は Y 行 4.4 → 5.0
  程度に変化、文字が壁の実材部に正しく乗るため）。
- 統合 trial_tact_variants.stl（ローカル正本）を再生成し、
  収録用の分割 _1 / _2 も作り直した（各 12 ピース・全ソリッド
  watertight、体積合計 16,853.9）。

#### F. long バリエーションの分割収録（§17.29-E の申し送り）

- trial_tact_variants_long.stl（統合 ASCII 約 10.6MB）も
  §17.28-I と同じ方式で 2 ファイルに分割して収録する:
  - trial_tact_variants_long_1.stl: x0 群（m19／s0／s19
    ＋プランジャ各 3、計 12 ピース、22,780 面、3,811,296 B）
  - trial_tact_variants_long_2.stl: x19 群（m19_x19／
    s0_x19／s19_x19 ＋プランジャ各 3、計 12 ピース、
    22,620 面、3,863,991 B）
- 分割は統合ファイルの facet テキスト抜き出し（配置・形状は
  そのまま）。検証: 各 12 ピース・全ソリッド watertight、
  体積合計 17,346.2 で §17.29-E の統合版と一致。
- staging の統合版は数値表記を短縮した形式で置き直した
  （形状は同一、再読み込みで 24 コンポーネント・体積一致）。

#### G. 検証結果

- check_plunger: ALL OK（差し込みスイープ干渉 0）
- check_paddle_real: 全姿勢で tray／band／frame とも 0.00
- check_trrs / check_trrs_trial: OK（プラグ胴体・ピンの
  干渉 0、開口幅スキャン OK）
- check_usb_channel: CHANNEL CHECK OK（更新した 4b の
  区間内 open／区間外 filled を含む）
- check_v21 / check_dock（干渉 0、全幅 302.61 不変）/
  check_plate_ring / check_plate_openings（63 穴 OK）/
  check_socket_ledge: 通過
- verify_stl: 本体・個別ピースは comp=1・nonmanifold=0・
  minz=0。trial_all_1／2 は comp=4（ピース数どおり）。

#### H. 変更ファイル

- build_case.py（TRRS カット全高化＋帯フレームの島処理）
- check_usb_channel.py（項目 4b の前提更新）
- make_tact_variants.py（彫り込みの反転処理）
- top_frame_short.stl / top_frame_long.stl
- trial_back_frame_short.stl / trial_back_frame_long.stl
- trial_all_2.stl（角ピースの組み直し）
- trial_tact_variants.stl / _1.stl / _2.stl（鏡像修正で再生成）
- trial_tact_variants_long_1.stl / _2.stl（§17.29 分割・新規）
- DESIGN_NOTES.md（本節）
- 無変更: トレイ／バンド／プレート、trial_tact_frame 単体、
  バリエーション単体 12 種、帯トレイ／帯バンド、プランジャ

### 17.31 v2.4.16: §17.28 是正方向の取り違え確定（−側が正）・逆向きバリエーション試作・マイコン基板の着座経路調査（2026-11-07）

#### A. 方向取り違えの確定（実物判定）

- 本人が +側バリエーション（s15／s19／s23）を実物に当てて判定:
  **元のピース（Y0、中心 109.5/119.0/128.5）が一番合い、+量が
  大きいほどずれが大きい（2.3 が最悪）**。ずれ量は +方向に単調
  であり、§17.28 の実測ギャップ 1.8〜2.0mm（バンド基準）の
  大きさと合わせると、真の中心は基準から −1.9（階段側）:
  **新しい暫定中心は [107.6, 117.1, 126.6]**。最終量は D の
  逆向きセットの実物判定で決める。
- よって **§17.28 の是正方向は逆だった**。§17.28 で production
  に入れた +1.9 暫定値 [111.4, 120.9, 130.4] は**誤り**。
  build_case.py の TACT_CENTERS["short"] は本節ではまだ
  変更しないが、**確定後に −側へ差し替える**こと。現行
  production の top_frame_short／trial_back_frame_short／
  trial_tact_frame_short は誤った +1.9 中心のままなので、
  本印刷には使わないこと。

#### B. 再監査（どこで符号が反転したか）

1. **生成ミスではない**: staging の STL を実測すると、座ぐり
   中心は s15 = 111.0/120.5/130.0、s19 = 111.4/120.9/130.4、
   s23 = 111.8/121.3/130.8 で、基準 [109.5, 119.0, 128.5] に
   対し正確に +1.5/+1.9/+2.3（外側端方向）。ファイルは
   §17.28 の意図どおりに作られていた。なお staging の
   trial_back_frame_short は §17.28 で再生成された +1.9 の
   ピース（実測 111.4/120.9/130.4）であり、元の Y0 ピース
   ではない（本人が「元のピース」と呼ぶのは §17.28 以前の
   印刷物の方）。
2. **反転箇所は写真の読み**: ギャップの大きさ 1.8〜2.0mm は
   写真 7501 のバンド基準実測で確かだが、その**向き**は
   §17.28-A(2) の写真 7498 画素判定（「タクト中心が座ぐり
   中心から画像左＝外側端側へずれる」）と本人の言葉「タクト
   スイッチの位置は 2mm か 3mm ぐらい右」に依存していた。
   これらの写真は基板の裏面（Light Side）側から見たもので、
   この向きではケース座標 +y（外側端方向）は画像の左右と
   逆になる。裏面ビューで「右／左」をそのまま表面ビューの
   方向に読み替えたため符号が反転した。
3. **端面距離の照合は循環していた**: §17.29 で short の裏付け
   とした端面距離 8.05 は、是正後中心 130.4 からの逆算
   （138.45 − 130.4）であり独立実測ではない（+1.9 と自明に
   整合するだけ）。−1.9 中心では 11.85、Y0 では 9.95 になる。
   独立アンカーのはずの写真 7466「10」も、SW1 中心 128.45
   自体が鏡像仮定による導出値（§17.29-B）を含むため、符号の
   判定には使えない。決め手は A の実物トレンドである。

#### C. 誤りセットの明記

- 次の +側セットは**方向が誤り**であり、実物判定には使わない:
  trial_tact_frame_short_s15／s19／s23（各 _x19 共）、
  trial_tact_variants_1.stl／_2.stl、および同中心で作られた
  production STL（A 項）。リポジトリには記録として残置する
  （push 済みの head a33c77d8 時点のもの）。

#### D. 逆向きバリエーション試作（trial_tact_variants_rev）

- 構成: short 角フレーム 6 種 = y {−1.5, −1.9, −2.3}（基準
  [109.5, 119.0, 128.5] 比、階段側）× x {0, −1.9} ＋
  プランジャ各種 3 個（横倒し）。中心の実測（座ぐり Ø8.6 の
  空洞プローブ）: r15 = 108.0/117.5/127.0、r19 = 107.6/
  117.1/126.6、r23 = 107.2/116.7/126.2 で設定どおり。
- 命名: 単体は trial_tact_frame_short_r{15,19,23}[_x19].stl
  （"r" = reverse。long 版の m19 等と混同しないため）。
  統合は trial_tact_variants_rev.stl、ガイド図は
  guide_tact_variants_rev.png、生成は make_tact_variants_rev.py
  （単体は build_case を TACT_VARIANT_STEP=−量 /
  TACT_VARIANT_TAG=r量 で生成）。
- 彫り込み文字: make_tact_variants の text_cutter（§17.30 で
  鏡像修正・ラスタ確認済みの方式）を共用し、「Y-1.5」等を
  外側端面へ。彫り込み後も各ピース 1 ソリッド・watertight
  （engrave の検証を通過）。
- 統合検証: 24 ピース（フレーム 6＋プランジャ 18）、全
  ソリッド watertight、bbox 169.3×173.5（180×180 内）、
  minz=0、ピース間隔の最小 3.05。穴位置プローブ（座ぐり
  中心＝空洞、隣接中点＝実材）合格。
- staging 収録: 単体 6 種と統合版は ASCII（数値表記短縮）で
  同期し、統合版は x0 群／x19 群の 2 ファイル
  （trial_tact_variants_rev_1.stl／_2.stl、各 12 ピース）に
  分割して収録する（push はしていない）。

#### E. マイコン基板の着座経路調査（写真 7517、本人の精密化）

- 本人報告: 端ピンにはギリギリかかっていない。問題は
  「この形ではマイコン（基板）が置けない」こと。対象包絡は
  check_usb_channel 項目 3 の定義（ヘッダ 2.5 前提）:
  モジュール基板 x[85.1, 102.9]／y[105.90, 138.90]／
  z[1.6, 3.2]、USB コネクタ x[89.55, 98.45]／y[131.50,
  138.90]／z[0.8, 4.0]、ヘッダ帯 2 条（x 85.13〜87.63 と
  100.37〜102.87、y 108.4〜136.4、z[3.2, 5.7]）。
- **着座状態では干渉 0**（モジュール／コネクタ／ヘッダ帯 ×
  トレイ／バンド／フレーム、全て 0.00mm3 を再実測。
  check_usb_channel の PASS と一致）。ただし余裕は薄い:
  モジュール階段側端 → トレイ MCU ポケット内壁（STL 実測
  y≈105.4、設計 105.36）で 0.4〜0.54mm、コネクタ端
  （y 138.90）→ バンド端壁キャビティ面（138.95）で
  **0.05mm**、コネクタ天面（z 4.0）→ バンド端レッジ下面
  （z≈4.55）で 0.55mm。
- **塞いでいるのは着座までの通り道**（トレイ＋バンド相手、
  フレームは無関係）:
  1. まっすぐ横滑り（並び方向 +y、最終高さ）: モジュール
     下面 z 1.6 がトレイ床上面 z 2.5 に **0.9mm** 食い込む。
     ポケット（内壁 y 105.36）に完全に入る dy ≥ −0.54 まで
     干渉が続く（重なり面積 dy=−1 で 5.5mm2、−5 で 72、
     −20 で 339）。奥行き方向 +x の滑りも同じ床干渉で
     dx < −2.1 では不可（ポケット x[83, 105] の余裕 2.1）。
  2. 真上からの垂直落下: 最後の約 0.45mm で**バンドの端
     レッジ**（端壁に沿うレッジ、z[約4.55, 5.7]、内側端
     y=137.45）がコネクタ端の上に 1.45mm 張り出しており、
     コネクタがその下に潜り込めない（干渉 dz=+0.7 で
     2.36mm3、+1.0 で 5.89mm3、接触開始 dz≈+0.45）。
  3. 水平を保ったままの複合経路も、dy ∈ (−1.45, −0.54) の
     区間で「床を避ける dz ≥ 0.9」と「レッジを避ける
     dz ≤ 0.55」が両立せず不可。置くには**端側を下げた
     傾け（約 2° 級）**で入れるか、形状側の逃げが要る。
- **必要な逃げ（次ラウンド候補、本節では形状変更しない）**:
  端レッジのコネクタ幅部分（x 約 88〜100、y 137.45〜138.95）
  の切り欠き、またはポケットの階段側への延長＋床の深さ
  確保。なお前提の感度: モジュール端の +0.45 張り出しは
  想定値で、実物のモジュール端が基板端から 1.0mm 以上内側
  （y ≤ 137.45）に収まれば垂直落下の干渉は消える（床の
  0.9mm 制約は残る）。実物 RP2040 ボード入手時に端位置を
  実測して確定する。
- **フレーム角ピースとの関係**: 角ピース（+側 s19／逆向き
  r19 とも）× マイコン包絡は全て 0.00mm3 で、タクト方向の
  問題とは独立。塞いでいるのはトレイ床とバンド端レッジで、
  どのバリエーションピースでも共通に残る。

#### F. 変更ファイル（staging まで、push はしていない）

- build_case.py: **無変更**（production の +1.9 は A のとおり
  誤りだが、差し替えは最終量の確定後）
- make_tact_variants_rev.py（新規）
- trial_tact_frame_short_r{15,19,23}[_x19].stl（新規・単体）
- trial_tact_variants_rev.stl（新規・統合、ローカル正本）
- trial_tact_variants_rev_1.stl／_2.stl（staging 分割収録）
- guide_tact_variants_rev.png（新規）
- DESIGN_NOTES.md（本節）

#### G. 次の判定（本人作業）

- 逆向きセット（r15／r19／r23）を印刷して当て、最終の
  ずらし量を決める。決まったら TACT_CENTERS["short"] を
  −側の確定値へ差し替え、production STL を再生成する。
- マイコンの置き方は、実物ボードの端位置の実測と合わせて
  次ラウンドで逃げ形状を決める。
