koorayworks/7spromax-case/template/NOTES.md

# 7sProMax 純正ケース図面 → 平面テンプレート抽出メモ

作成日: 2026-11-03
入力: `~/workspace/user/files/7sProMax_4_0uxl.pdf`（上面図、A3・1ページ、CAD→Microsoft Print To PDF のベクタ線画）
成果物: `7spromax_case_template.dxf`（単位mm）／ `preview_with_dimensions.png`

## 抽出方法

1. `pdftocairo -svg` で全パスを抽出。本文図形は fill:none・黒ストローク・変換係数0.749698 のパス群のみ（文字グリフは `<defs>`＋`<use>` 参照で分離）。
2. ジオメトリは全て直線セグメント（M/L/Z）のポリライン。円弧・フィレットは微小線分の近似として元データに入っている。
3. 端点を 0.25pt でクラスタリングしてグラフ化。寸法線の矢印（約9.96pt長の三角形）を分離したうえで、寸法矢印の頂点位置から「図面スパン(pt) ↔ 記載寸法(mm)」の対応を7組実測。
4. 輪郭は二重線ペア（約1.4pt≒0.5mm間隔）で描かれており、各ペアは両端で微小セグメントにより接続され、細いバンド状の閉ループになっている。外形・ポケットともこのバンドの**外側の線**を採用した。櫛歯（連結部の歯）プロファイルを含む外形は、名前付きチェーンを手組みで接続し、閉合ギャップ0.000ptを確認。
5. スイッチ穴は半辺フェイス走査で抽出した閉ループのうち穴サイズのもの **69個**（63キー＋隠し6と一致）。内訳: 短い半分30個（正方形27＋横長2＋縦長1）、長い半分39個（正方形33＋横長4＋縦長2）。

## 校正

- **スケール: 1 pt = 0.352971 mm**（7組の寸法スパンに対する原点通過の最小二乗）
- 残差: 116.53→-0.011 / 78.53→-0.033 / 174.18→+0.004 / 136.18→+0.024 / 31.08→-0.004 / 50.13→-0.001 / 24.05→+0.001 mm（最大±0.03mm）
- 座標変換: X = (x_pt − 367.42) × S、Y = (968.97 − y_pt) × S（Y軸反転、両半分を図面どおりの相対配置で1ファイルに収納）

## 検算結果

| 項目 | 実測 | 基準 | 判定 |
|---|---|---|---|
| スイッチ穴ピッチ（列内） | 53.98pt = **19.05mm** | 19.05mm | 一致（+0.02%） |
| 連結スロット幅 | 22.63pt = **7.99mm** | 図面記載 8mm | 一致 |
| 外形の幅（両半分共通） | 323.8pt = **114.3mm** | 側面図の奥行 114.2mm | 一致（+0.1mm） |
| 正方形スイッチ穴 | **14.95 × 14.95mm** | MX標準 14mm台 | 図面どおり |

寸法校正（図面寸法ベース）とピッチ校正（19.05mmベース）は矛盾しない。両者が同時に成立するため、採用スケールは正しいと判断。

## 外形の実測値（DXF内）

- 短い半分（上面図・上側）: **114.29 × 143.36 mm**、スイッチ穴30個
- 長い半分（上面図・下側）: **114.27 × 177.23 mm**、スイッチ穴39個
- 注意: 図面記載の 174.18 / 116.53 は外形の最大寸法ではなく、基準線（y=48.94相当）からスロットチャンネル端線までのフィーチャ間寸法。外形の実測長はこれより大きい（長い半分で +3.0mm）。ケース同士を並べた全長ではない点に注意。

## レイヤー構成（DXF）

- `OUTLINE`（赤）: 外形輪郭×2（櫛歯プロファイル含む、閉ポリライン）
- `SWITCH_HOLES`（青）: スイッチ穴×69（閉ポリライン）
- `POCKET`（緑）: 内側ポケット輪郭×2（閉ポリライン）
- `SLOT`（マゼンタ）: 連結スロットの東側壁線×2（開ポリライン）。スロット溝は西側＝POCKET右端線、東側＝SLOT線、下端＝POCKETの端キャップ線で囲まれた幅7.99mmのチャンネルとして読むこと

## 注意点・欠け（推測で作っていないもの）

- **ポケットと外形は段差部で1本の線を共有**する（図面に線が1本しかないため。上面図チェーン6／下面図チェーン77相当）。立体化の際はここをどう扱うか設計判断が必要。
- ポケット輪郭は二重線の外側を採用。内側線は約0.5mm内側に平行に存在する（壁の内外面のどちらを指すかは図面だけでは断定できない）。
- **図面に無いため作らなかったもの**: ネジ穴の位置・径、内部段差の深さ（ポケットの段差高さ）、側面のコネクタ開口（USB／TRRS）の位置・寸法、ボトムプレート／アクリル板の形状。これらは基板・ボトムプレートの実測から別途決める必要がある。
- 穴・輪郭の頂点は元図面の線分近似のまま（円弧への再フィットはしていない）。誤差はクラスタリング由来で最大約0.09mm程度。
