koorayworks/7spromax-case/template/PCB_NOTES.md

# PCB_NOTES.md — 7sProMax 基板裏面スキャンからのソケット中心・輪郭抽出

入力: 基板裏面スキャン `~/workspace/user/files/7346_33_3orv.jpg`（1448×2048px、パネル未分割のまま両半分入り）
比較対象: `7spromax_case_template.dxf`（純正ケース図面由来、スイッチ穴69個）
成果物: `pcb_sockets.csv`（69点）、`pcb_overlay.png`、`pcb_outline_short.csv` / `pcb_outline_long.csv`

## 座標系の定義
- `pcb_sockets.csv` の `dxf_x_mm / dxf_y_mm / meas_x_mm / meas_y_mm` は **DXFテンプレの各半分ローカル座標**（原点＝その半分の外形bbox最小コーナー、x＝図面の横方向＝キーボード奥行方向 0〜114.29mm、y＝図面の縦方向＝キーボード幅方向、単位 mm）。
- `img_x_px / img_y_px` は 7346 スキャン画像のピクセル座標（原点＝左上）。
- hole_id は各半分内の DXF エンティティ順（S01〜S30＝短い半分、L01〜L39＝長い半分）。

## スケールの確定方法と値
- JFIF の DPI メタデータは (1,1) で無効だったため実測から確定した。
- 上部マイコンのピンヘッダ（ProMicro系 12ピン×2列）で検証: ピン列間隔 105px ＝ 15.24mm、ピンピッチ 17.5px ＝ 2.54mm → **6.89 px/mm**。
- テンプレ全体の剛体フィットでも一致: 短い半分 **6.8908 px/mm**、長い半分 **6.8790 px/mm**。
  両半分で 0.17% の差がある（長い半分の全長では最大 ~0.26mm 相当）。基板自体の寸法差ではなく、スマホスキャンの面内歪み（位置によるスケール変動）が原因と推定する。各半分は自前のフィットで比較しているため、半分内の結論には影響しない。

## 配置の確定（重要な前提）
- パネル内では両半分とも **図面ローカル座標に対して 180° 回転** して配置されていた（短い半分＝パネル上側ボディ、長い半分＝パネル下側ボディ）。鏡像（反転）では一切フィットせず、反転なし回転180°でのみ全点が一致した。裏面スキャン＝裏から見た図であることと整合する。
- 両半分は組み立て位置関係のまま（階段状の境界で噛み合う配置）でパネル化されており、x 方向の原点もほぼ一致した（平行移動 x: 短 907.6px / 長 903.5px、いずれも回転180°込み）。
- フィット: 短い半分 s=6.8908 px/mm, 回転 −179.902°, t=(907.6, 986.4)px / 長い半分 s=6.8790 px/mm, 回転 −179.848°, t=(903.5, 2042.1)px。

## ソケット中心の抽出方法（根拠）
- 裏面で各スイッチ位置に見える **Kailh ソケット中央の円形ドーム状フィーチャ**（灰色の円盤。スイッチ中心穴＋ソケット円筒部の陰影）を中心の根拠とした。この円はスイッチ中心と同心であり、その重心＝ソケット中心とみなせる。
- 検出は2系統（円盤スコアによる候補抽出＋ドーム平均パッチの正規化相関）で行い、候補のパッチ統計（中心円盤の平均輝度 85〜172、周囲リング <44、最大輝度 <182＝飽和したはんだ/LEDと区別）で「ドームらしさ」を検証した。明るいはんだ接点クラスタに誤ロックしたフィットはこの検証で棄却した。
- 中心は候補の重心（サブピクセル）。全69点中 **51点を実測**（method=dome_centroid）。

## フィット残差＝「図面と実基板のズレ」（ソケット中心）
各半分ごとに相似変換（平行移動・回転・スケール）を最適合させた後の残差。つまりパネル内配置の差を除いた、図面と基板そのものの食い違い。

| 半分 | 実測点数 | 残差 RMS | 残差 最大 | 残差 平均 |
|---|---|---|---|---|
| 短い半分 (short) | 22 | **0.070 mm** | **0.102 mm** | 0.066 mm |
| 長い半分 (long) | 29 | **0.107 mm** | **0.213 mm** | 0.098 mm |

→ ソケット中心は図面と実基板で **0.1mm 級で一致**。スキャンのぼけ（±0.1mm 級の測定ノイズ）を考えると、系統的なズレは検出限界以下。ケース設計は図面テンプレの穴中心をそのまま使って問題ないレベル。

## 未確認・注意範囲
1. **暗いドーム 12点**（short 6点: S01, S03, S09, S14, S18, S30 / long 6点: L05, L07, L12, L14, L27, L34 ※CSVの method=fit_prediction_dark_dome）
   パネル端部では同じドームが低コントラストの黒い円盤として写り、重心抽出ができなかった。4箇所を 3倍拡大で目視し、いずれも予測位置にドームが同心に存在することを確認済み。CSV の座標は剛体フィット予測値（フィット RMS ≤0.11mm が不確かさの根拠）で、実測列は空にしてある。
2. **タクトスイッチ用横長開口 6点**（short: S07, S20 / long: L01, L11, L22, L36、method=fit_prediction）
   ケース側の開口中心は裏面のどのフィーチャ（ドーム等）とも一致しない（予測位置はスイッチ間の空き地に落ちる）。タクトスイッチ本体は表面/タブ側実装で裏面からは対応点が取れないため、裏面スキャンからは実測不能。座標はフィット予測値のみ。
3. 白いゲージ板の被さり: 差し替え後の 7346 には被さりなし（7345 の被さりは本解析では不使用）。

## 基板輪郭と図面外形の一致度
- 輪郭はスキャンの基板マスクを階段状の隙間（両ボディ間の白い帯）で上下に分け、各ボディの最大連結成分から抽出した（`pcb_outline_short.csv` / `pcb_outline_long.csv`、テンプレローカル座標 mm）。
- 外形寸法（bbox）の比較 ※DXF 側はケース外形であり、基板が一回り小さいのは設計通り:

| 半分 | 項目 | 基板（実測） | ケース図面 | 差 |
|---|---|---|---|---|
| short | 幅 (x) | 110.34 mm | 114.29 mm | −3.95 mm |
| short | 長さ (y) | 136.46 mm | 143.36 mm | −6.90 mm |
| long | 幅 (x) | 110.77 mm | 114.27 mm | −3.50 mm |
| long | 長さ (y) | 173.35 mm | 177.23 mm | −3.88 mm |

- 点対輪郭の距離は中央値で 3.0〜3.5mm（ケース壁厚＋クリアランス相当）。ただし階段境界の噛み合い部では、輪郭抽出の分割線が相手側の歯を横切るため局所的に大きな誤差（最大 ~14mm、short の歯先では ~33mm の飛び）があり、その部分の輪郭は信頼できない。オーバーレイ画像（橙線）でも同箇所にギザギザが出ている。
- short の長さ差 (−6.90mm) が long (−3.88mm) より大きい。ケース側の接続スロット側の張り出し等、ケース固有形状の影響とみられる（基板側の異常ではない）。

## 再現用の中間ファイル
`~/workspace/7spromax-case/work_pcb/`（gray.npy, mask.npy, pure_domes.npy=検証済みドーム候補120件, final_fits.npy, dxf_layers.json, crops/ に検証用拡大図）。
