koorayworks/7spromax-case/design/archive/README.md

# archive — 旧世代ファイル置き場

現行設計（v2 系）では使わない、旧世代のファイルをまとめた場所です。削除はせず、履歴として残してあります。

| ファイル | 内容 |
|---|---|
| bottom_case_short.stl / bottom_case_long.stl | v1 の底ケース（現行は bottom_tray + side_band の構成） |
| trial_boss_bottom_short.stl / trial_boss_bottom_long.stl | ボス試作用の試作片（引退） |
| trial_boss_frame_short.stl / trial_boss_frame_long.stl | ボス試作用の試作片・フレーム側（引退） |
| trial_corner_short.stl | 旧コーナー試作片（現行は trial_corner_tray / band / frame） |
| trial_screw_short.stl / trial_screw_long.stl | ネジ試作用の試作片（引退） |
| trial_stair_short.stl / trial_stair_long.stl | 旧階段試作片（現行は trial_stair_band_*） |
