koorayworks/7spromax-case/design/trial_tact_frame_short_r15.stl

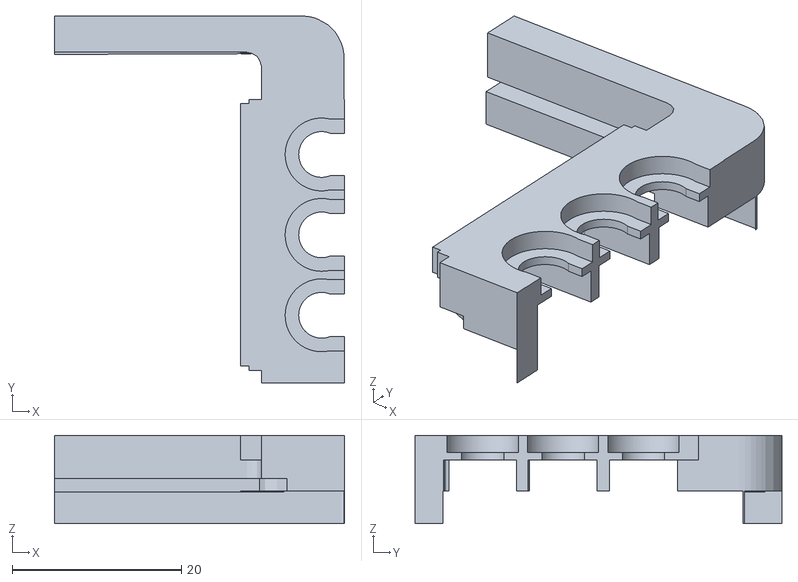
[picture p1: CAD file, 2026-11-07]
design/trial_tact_frame_short_r15.stl
34.3 x 43.4 x 10.4
