koorayworks/7spromax-case/design/trial_tact_variants_long_2.stl

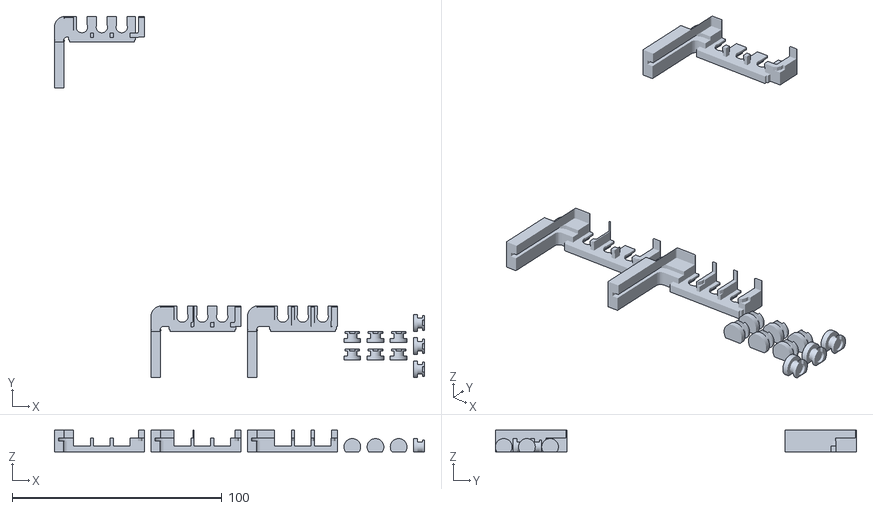
[picture p3: CAD file, 2026-11-07]
design/trial_tact_variants_long_2.stl
176.6 x 172.4 x 10.4
