koorayworks/7spromax-case/design/trial_tact_variants_long_1.stl

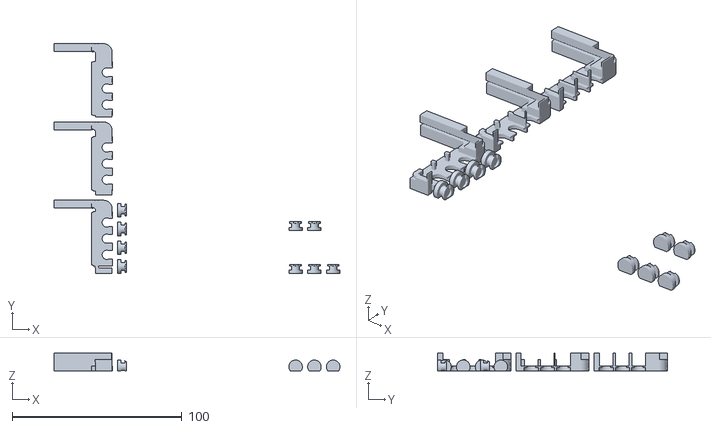
[picture p4: CAD file, 2026-11-07]
design/trial_tact_variants_long_1.stl
168.2 x 135.1 x 10.4
