koorayworks/7spromax-case/design/trial_tact_frame_long_m19_x19.stl

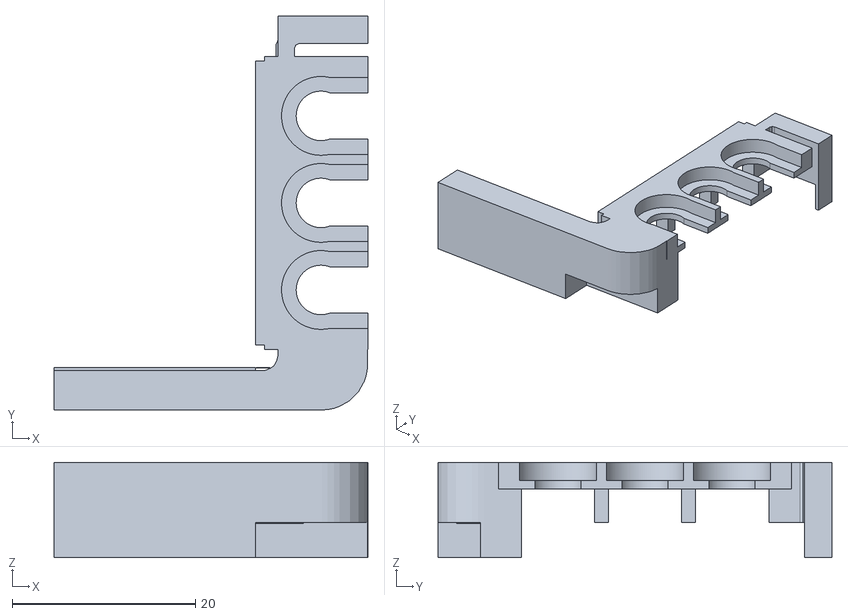
[picture p6: CAD file, 2026-11-07]
design/trial_tact_frame_long_m19_x19.stl
34.3 x 43.0 x 10.4
