koorayworks/7spromax-case/design/trial_tact_variants_2.stl

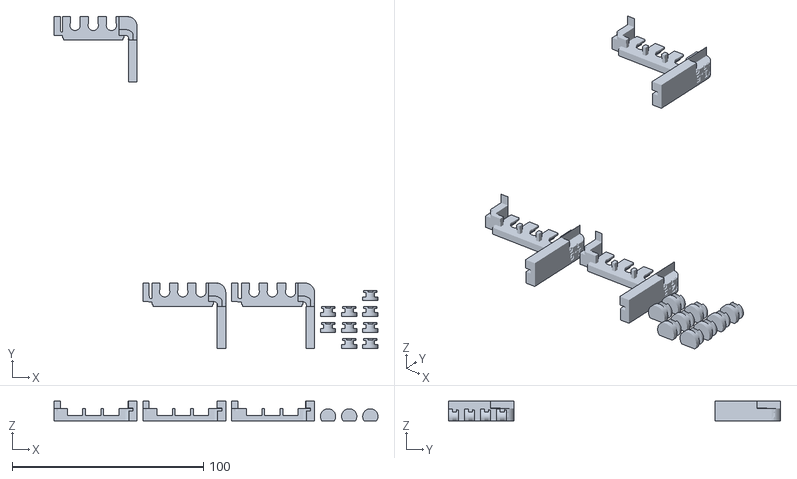
[picture p7: CAD file, 2026-11-07]
design/trial_tact_variants_2.stl
169.3 x 173.5 x 10.4
