koorayworks/7spromax-case/design/trial_tact_variants_1.stl

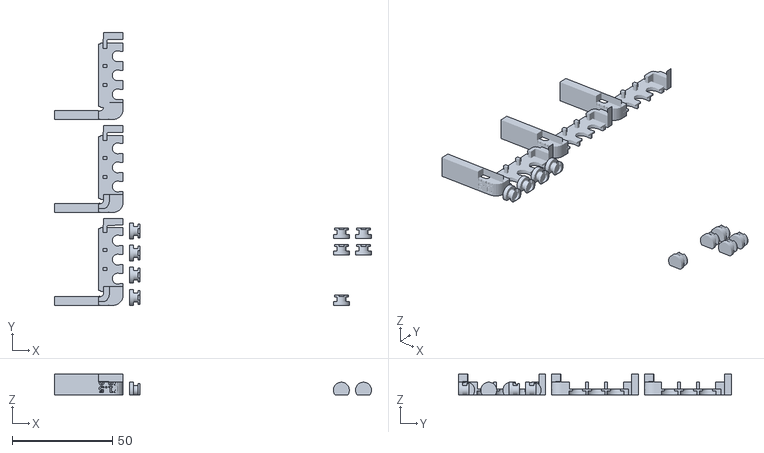
[picture p8: CAD file, 2026-11-07]
design/trial_tact_variants_1.stl
158.3 x 136.2 x 10.4
