koorayworks/7spromax-case/design/trial_all_2.stl

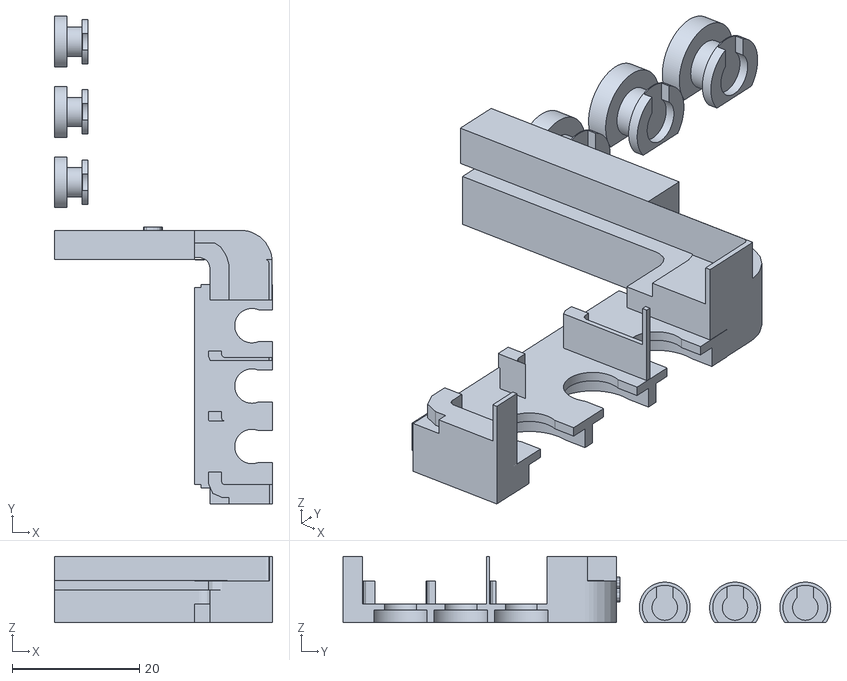
[picture p9: CAD file, 2026-11-07]
design/trial_all_2.stl
34.3 x 76.6 x 10.4
