koorayworks/7spromax-case/design/trial_back_frame_short.stl

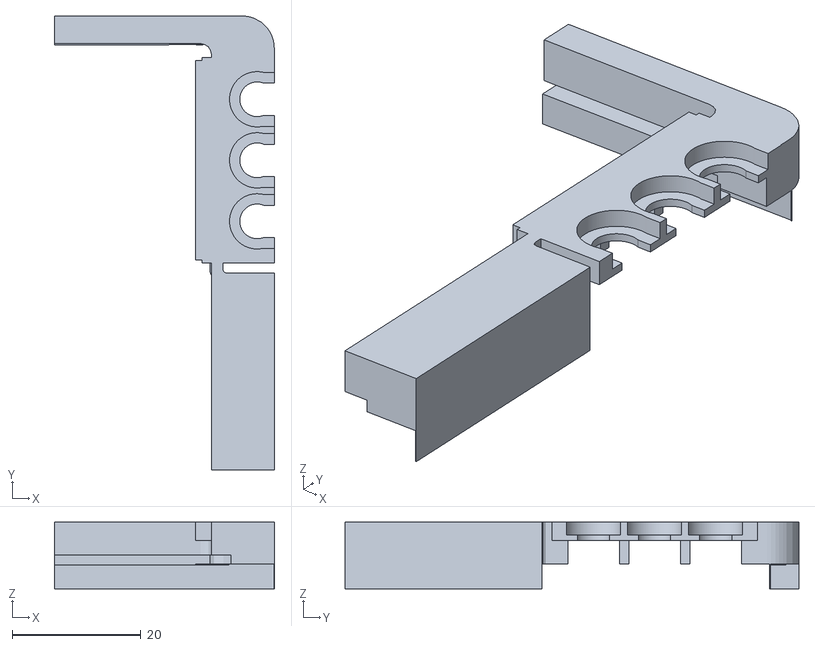
[picture p10: CAD file, 2026-11-07]
design/trial_back_frame_short.stl
34.3 x 70.7 x 10.4
