koorayworks/7spromax-case/design/trial_back_frame_long.stl

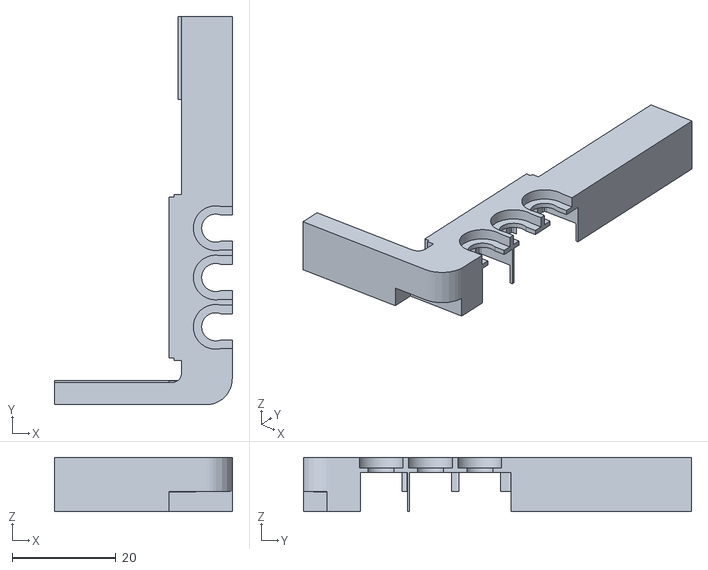
[picture p11: CAD file, 2026-11-07]
design/trial_back_frame_long.stl
34.3 x 74.8 x 10.4
