koorayworks/7spromax-case/design/top_frame_short.stl

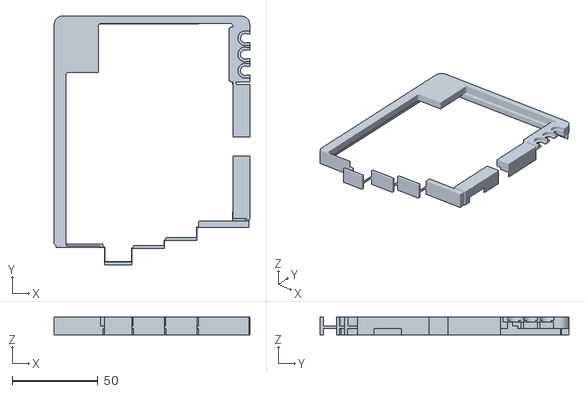
[picture p12: CAD file, 2026-11-07]
design/top_frame_short.stl
114.3 x 145.4 x 10.4
