koorayworks/7spromax-case/design/top_frame_long.stl

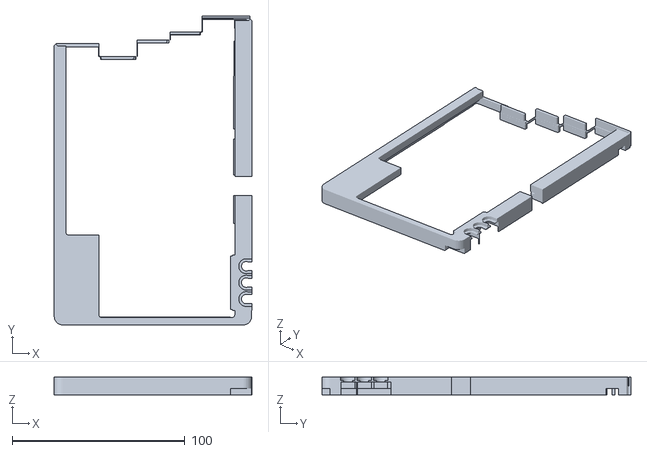
[picture p13: CAD file, 2026-11-07]
design/top_frame_long.stl
114.3 x 178.7 x 10.4
