koorayworks/7spromax-case/design/trial_all_1.stl

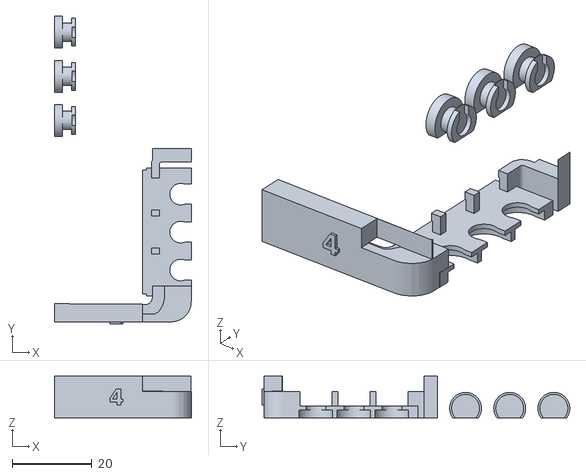
[picture p14: CAD file, 2026-11-06]
design/trial_all_1.stl
34.3 x 77.0 x 10.4
