koorayworks/7spromax-case/design/trial_back_tray_short.stl

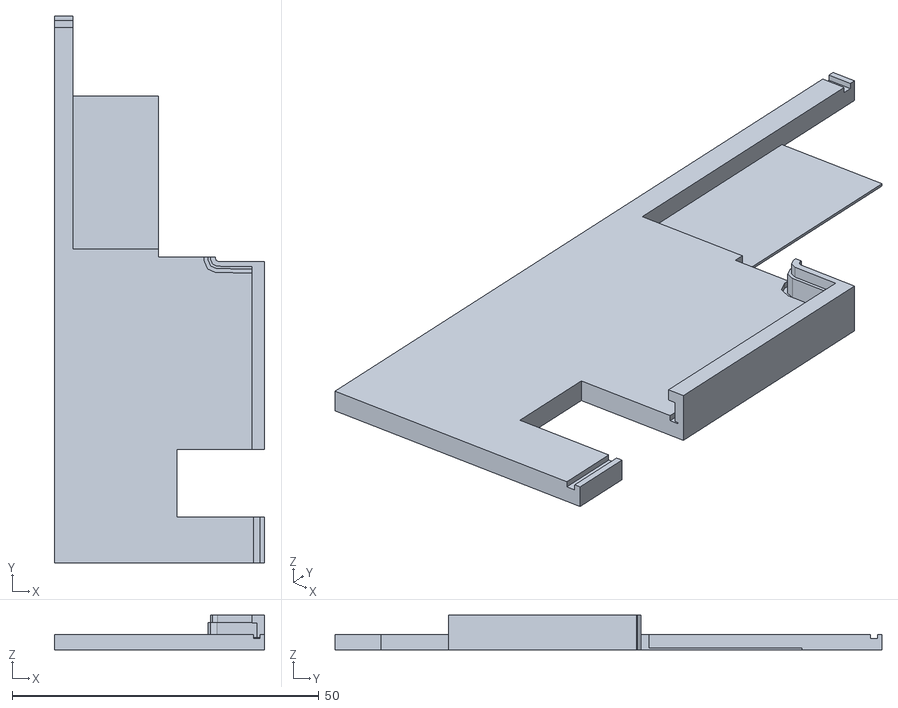
[picture p15: CAD file, 2026-11-06]
design/trial_back_tray_short.stl
34.3 x 89.2 x 5.70
