koorayworks/7spromax-case/design/trial_back_band_long.stl

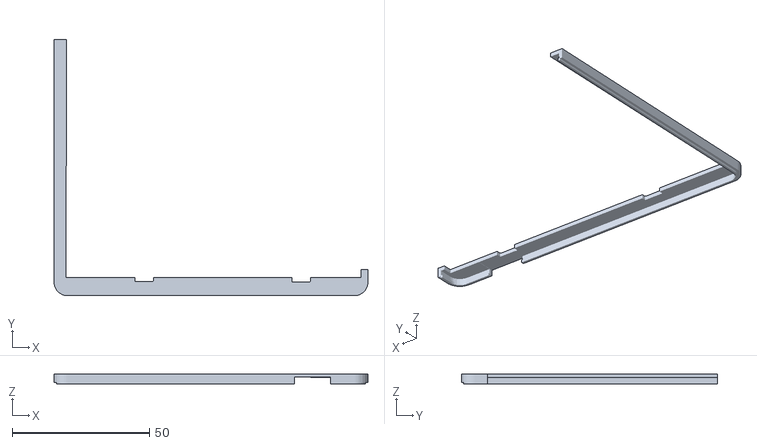
[picture p16: CAD file, 2026-11-06]
design/trial_back_band_long.stl
114.2 x 93.3 x 3.80
