koorayworks/7spromax-case/design/trial_back_band_short.stl

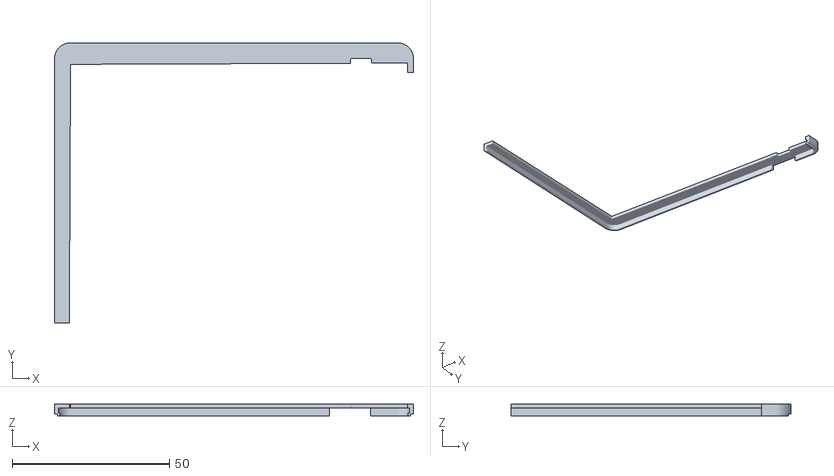
[picture p17: CAD file, 2026-11-06]
design/trial_back_band_short.stl
114.2 x 89.2 x 3.80
