koorayworks/7spromax-case/design/trial_back_tray_long.stl

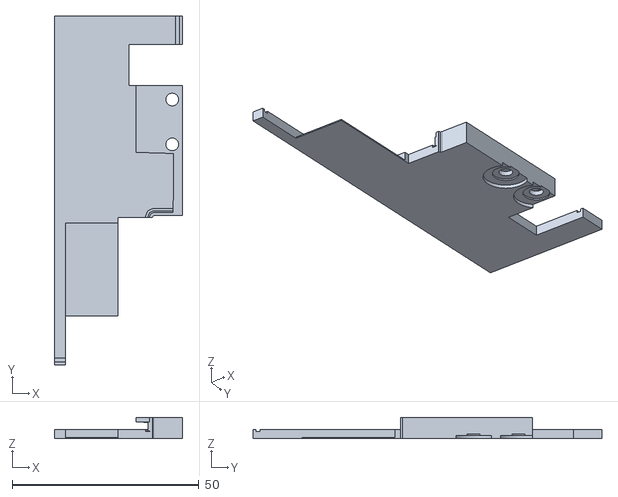
[picture p18: CAD file, 2026-11-06]
design/trial_back_tray_long.stl
34.3 x 93.3 x 5.70
