koorayworks/7spromax-case/design/plunger.stl

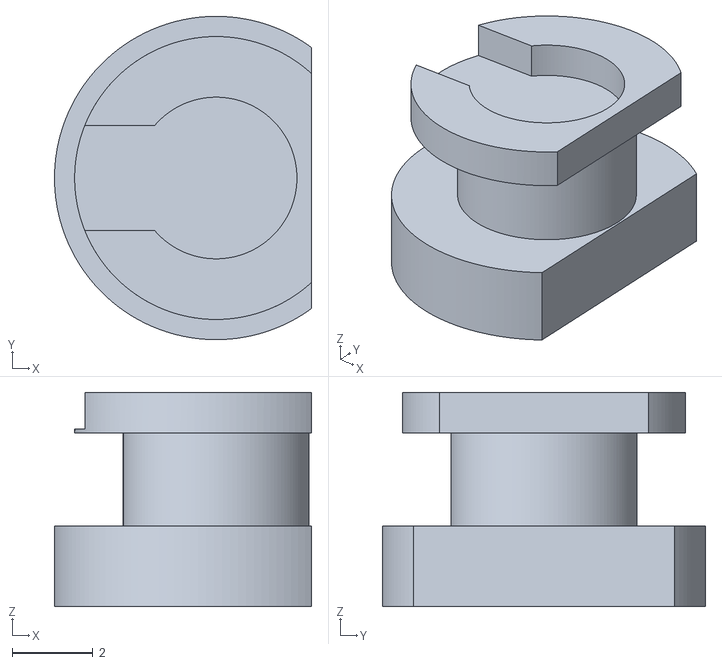
[picture p19: CAD file, 2026-11-06]
design/plunger.stl
6.36 x 8.00 x 5.30
