koorayworks/7spromax-case/design/switch_plate_short.stl

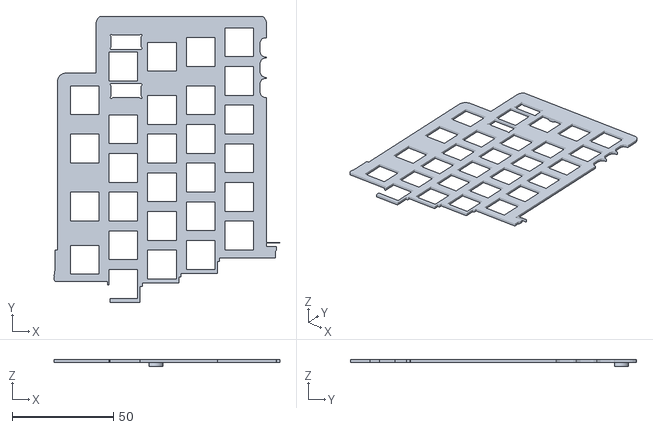
[picture p20: CAD file, 2026-11-06]
design/switch_plate_short.stl
111.4 x 141.1 x 3.65
