koorayworks/7spromax-case/design/switch_plate_long.stl

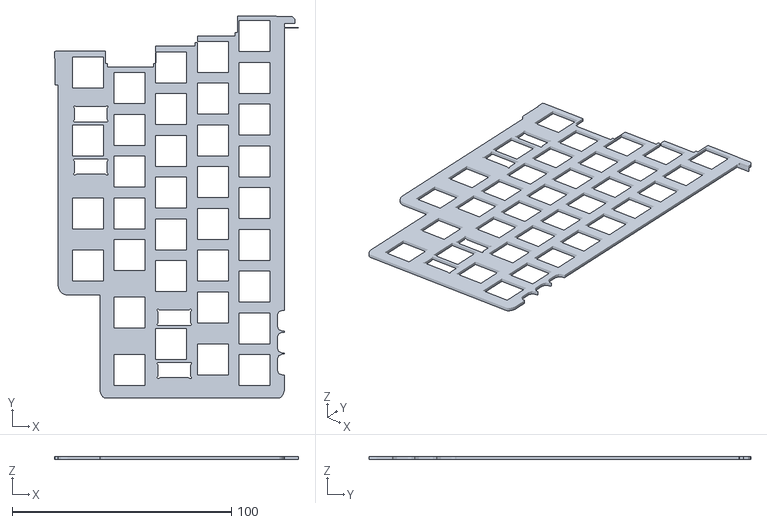
[picture p21: CAD file, 2026-11-06]
design/switch_plate_long.stl
111.5 x 174.3 x 1.50
