koorayworks/7spromax-case/design/trial_stair_band_long.stl

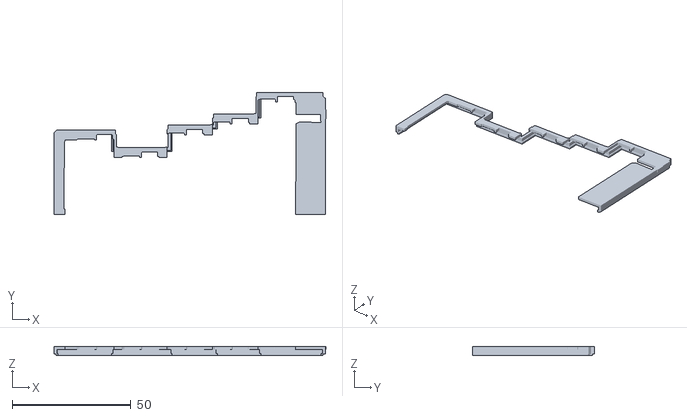
[picture p22: CAD file, 2026-11-05]
design/trial_stair_band_long.stl
114.6 x 51.5 x 3.80
