koorayworks/7spromax-case/design/trial_stair_band_short.stl

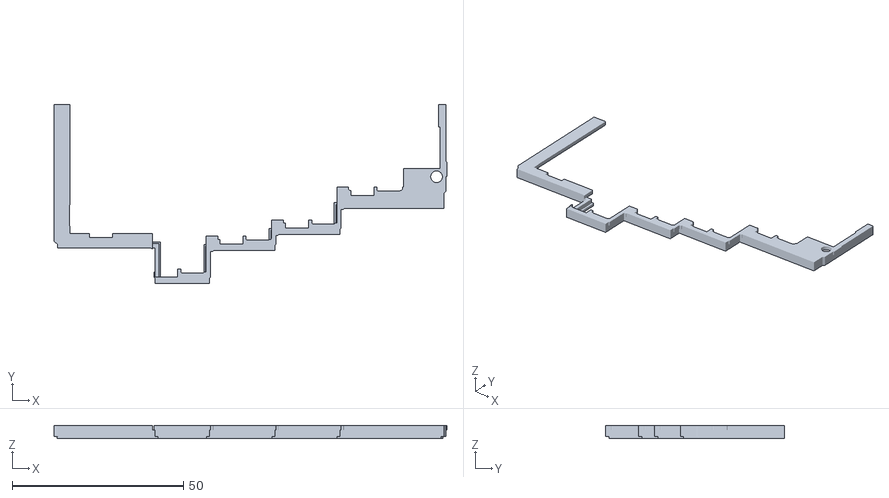
[picture p23: CAD file, 2026-11-05]
design/trial_stair_band_short.stl
114.6 x 52.0 x 3.80
