koorayworks/7spromax-case/design/side_band_short.stl

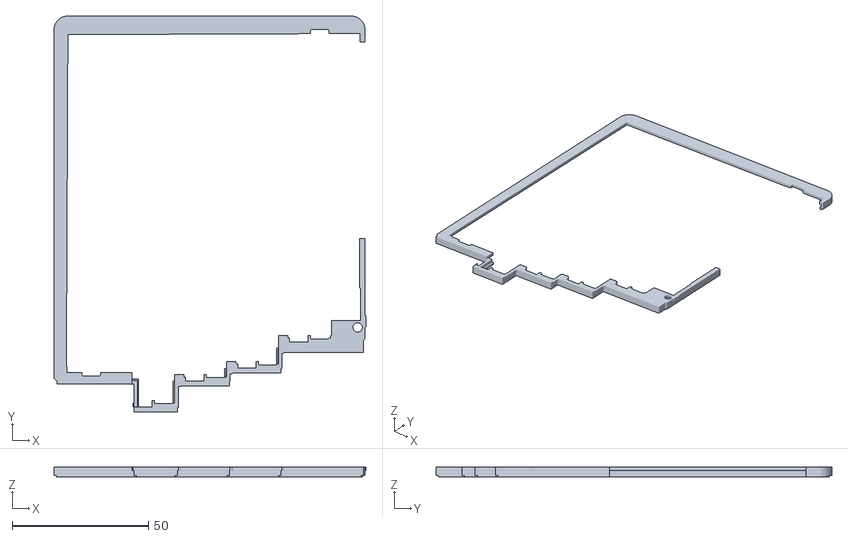
[picture p24: CAD file, 2026-11-05]
design/side_band_short.stl
114.6 x 145.4 x 3.80
