koorayworks/7spromax-case/design/side_band_long.stl

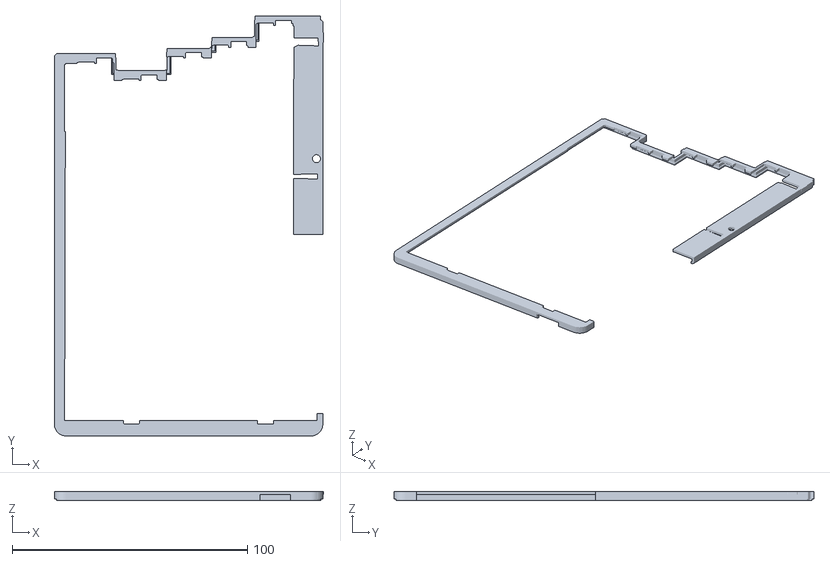
[picture p25: CAD file, 2026-11-05]
design/side_band_long.stl
114.6 x 178.7 x 3.80
