koorayworks/7spromax-case/design/bottom_tray_short.stl

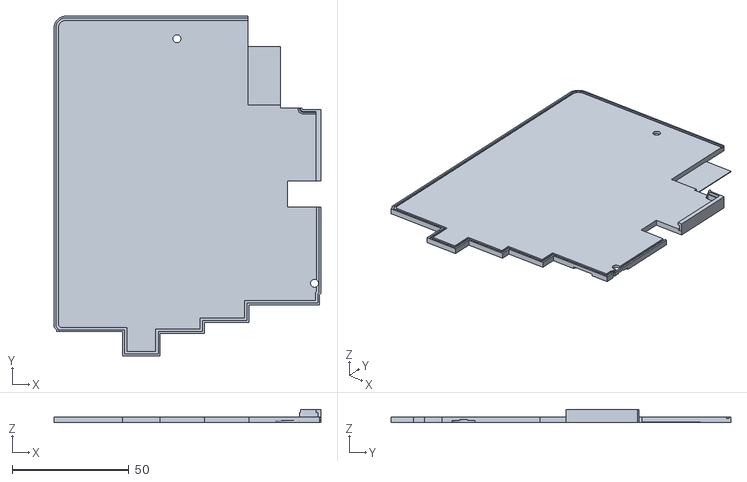
[picture p26: CAD file, 2026-11-05]
design/bottom_tray_short.stl
114.3 x 145.4 x 5.70
