koorayworks/7spromax-case/design/bottom_tray_long.stl

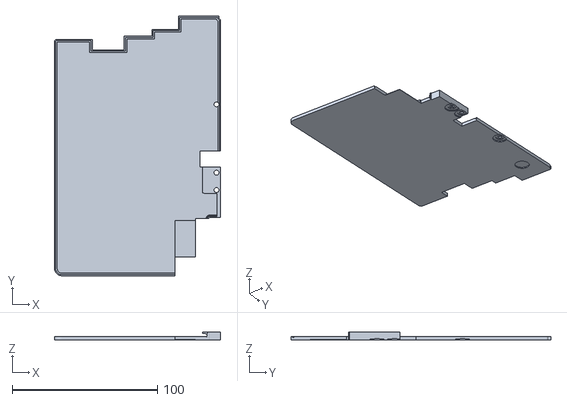
[picture p27: CAD file, 2026-11-05]
design/bottom_tray_long.stl
114.3 x 178.7 x 5.70
