koorayworks/7spromax-case/(list of files, cad)

Other CAD files:
template/7spromax_case_template.dxf
design/trial_tact_frame_short_r15_x19.stl
design/trial_tact_frame_short_r23_x19.stl
design/trial_tact_frame_short_r19_x19.stl
design/trial_tact_frame_short_r23.stl
design/trial_tact_frame_short_r19.stl
design/trial_tact_frame_long_s0_x19.stl
design/trial_tact_frame_long_s19_x19.stl
design/trial_tact_frame_long_m19.stl
design/trial_tact_frame_short_s15_x19.stl
design/trial_tact_frame_short_s19_x19.stl
design/trial_tact_frame_short_s23.stl
design/trial_tact_frame_short_s23_x19.stl
design/trial_tact_frame_short_s15.stl
design/trial_tact_frame_short.stl
design/trial_tact_frame_long_s0.stl
design/trial_tact_frame_short_s19.stl
design/archive/bottom_case_long.stl
design/archive/bottom_case_short.stl
design/archive/trial_boss_bottom_long.stl
design/archive/trial_boss_bottom_short.stl
design/archive/trial_boss_frame_long.stl
design/archive/trial_boss_frame_short.stl
design/archive/trial_corner_short.stl
design/archive/trial_screw_long.stl
design/archive/trial_screw_short.stl
design/archive/trial_stair_long.stl
design/archive/trial_stair_short.stl
design/trial_tact_variants_rev_1.stl
