koorayworks/7spromax-case/design/PADDLE_MEASUREMENTS.md

# 金属パドル（エクストラスイッチ用）実測メモ

測定日：2026-11-03（本人がノギスで測定した写真から読み取り）
主ソース：`~/workspace/user/files/7369_47_g6ny.jpg` / `7370_48_mbvr.jpg` / `7371_49_lan8.jpg` / `7372_50_xpbe.jpg`
参考：`7328`〜`7333` 番台（外観・金属定規併写・装着状態）、設計者の実装写真 `7353` / `7354`

## ノギスについて

- 品番19515の樹脂製ノギス。副尺は「×0.1mm」表記。
- 副尺は **10目盛で主尺19mm** を覆うロングバーニア（1目盛＝1.9mm、最小読取0.1mm）。4枚とも副尺の目盛間隔÷主尺間隔≒1.9で検算済み。
- 読み取り方法：主尺0点の位置は「数字0の真下の長目盛」と「数字の重心位置」で固定し、副尺0点直前の主尺目盛（整数mm）＋副尺の一致線（小数）で読んだ。画像解析で目盛列の格子間隔も検算している。

## 座標系（このメモでの呼び方）

- **軸方向**：バーの長手方向。ブロックがある側を「後端」、バーの先端側を「先端」。
- **幅方向**：バーの広い面に平行で、軸に直交する方向（装着時は基板の面内・前後方向）。
- **高さ方向**：バーの広い面に直交する方向（装着時は基板から離れる向きが上）。

## 寸法一覧

| # | 寸法 | 値 | 確度 | 根拠 |
|---|---|---|---|---|
| 1 | 全長（軸方向、先端〜ブロック後端面） | **27.3〜27.4mm** | 確定 | 7372 の副尺読み（下記）。7328 の金属定規併写でも約27mmで整合 |
| 2 | 羽根込み幅（幅方向最大） | **約8.7mm**（8.6〜8.8） | 推定 | 7369 の副尺読み |
| 3 | ブロック幅（幅方向、羽根を除く） | **4.8mm**（±0.1） | ほぼ確定 | 7370 の副尺読み。7332 の端面写真でも「ブロック幅≒羽根込み幅の55%」で整合 |
| 4 | バー幅（幅方向） | 約4.8mm（ブロックとほぼ同幅） | 推定 | 7370 の測定部はブロックだが、7370・7328 でバーもほぼ同幅に見える |
| 5 | バー厚さ（付け根の段差部） | **約1.5mm**（±0.2） | 推定 | 7371 の副尺読み。7329 の側面写真では先端寄りが約2mmに見え、場所により差がある可能性 |
| 6 | ブロック高さ（高さ方向） | 約8.5mm | 推定 | 7329 の金属定規併写からの読み（ノギス実測なし） |
| 7 | ブロック長さ（軸方向） | 約9.5〜10mm | 推定 | 全長27.3 − バー露出長 約17〜18mm（7328 定規併写） |
| 8 | バー露出長（ブロック前面〜先端） | 約17〜18mm | 推定 | 7328 の定規併写 |
| 9 | 羽根の張り出し（片側） | 約2.0mm | 推定 | (羽根込み幅8.7 − ブロック幅4.8) ÷ 2 |
| 10 | クリップ内側の間隔（タブが入る窪みの高さ） | **未測定**（3.5〜4mm程度か） | 未測定 | 4枚のノギス写真にこの測定はない。7329 の側面形状からの目安のみ |
| 11 | スイッチ押し突起の大きさ・突出量 | 約2.5×2mm、突出 約1.5〜2mm | 推定 | 7328・7329・7372 の外観から |

## 各写真の読み取り詳細

### 7372（全長）→ 27.3〜27.4mm
- 何を測ったか：パドル全体を軸方向に挟み、先端（バー先端）と後端（ブロック後端面）の間隔。
- 読み：副尺0点は主尺27mm目盛を過ぎて28mm目盛の手前、27mm目盛から約0.35mm先（目盛間隔21.5px/mmで実測）。副尺の一致線は3〜4本目付近。よって **27.3〜27.4mm**。
- 検算：7328（金属定規併写）でパドルの両端が定規の約27mm幅に収まることと一致。

### 7370（ブロック幅）→ 4.8mm
- 何を測ったか：パドルを正面（バーの広い面）から見て、ブロック部を幅方向に挟んだ寸法。ジョーの先端は羽根より上のブロック側面に当たっている。
- 読み：主尺0点（数字0重心・長目盛とも x=85px で一致）から副尺0点まで 89px、主尺間隔19.3px/mm。整数部4mm（副尺0点は主尺4mm目盛と5mm目盛の間）、小数部は副尺一致線が7〜9本目に寄るため0.7〜0.85。中心値 **4.8mm**。
- 検算：7332（端面写真）でブロック幅が羽根込み幅の約55% → 0.55×8.7≒4.8 で一致。

### 7369（羽根込み幅）→ 約8.7mm
- 何を測ったか：正面から見て、ブロック両側面の羽根（小さい角柱状の突起）の外側同士を幅方向に挟んだ寸法。ジョー先端は羽根の高さで羽根外面に当たっている。
- 読み：主尺0点は数字0の重心（285px）と長目盛（282px）で固定、主尺間隔15.7px/mm（0〜40mmの長目盛列で検算）。副尺0点は主尺8mm目盛と9mm目盛の間で、8mm目盛から約0.7〜0.8mm先。一致線は7〜8本目。よって **8.6〜8.8mm、中心 8.7mm**。
- 推定とする理由：この写真は目盛面に傷・汚れが多く目盛列の検出ノイズが大きい。小数部に ±0.1 の読み幅がある。

### 7371（付け根の段差部の厚み）→ 約1.5mm
- 何を測ったか：バーの付け根（ブロックとの段差部）で、バーの厚み方向を挟んだ寸法。ジョー先端が段差部の上面に当たっている。
- 読み：ノギスが約12°傾いた写真のため補正して読み、主尺間隔22.0px/mm、副尺0点は主尺1mm目盛と2mm目盛の中間付近 → **約1.5mm（±0.2）**。
- 注意：7329 の側面写真ではバーの厚みが約2mmに見える。付け根だけ薄い（段差で落ちている）可能性と、写真の読み誤差の可能性が両方ある。ケース側の逃げ設計では **厚み2.0mm前提＋余裕** を推奨。

## 形状の文章化（設計用）

一体物の金属部品（表面は梨地仕上げ）。後端のブロックが基板端のタブに被さり、ブロックから前方へ平板状のバーが伸びる。装着状態ではバーがケース奥側（マイコン側）の縁を乗り越え、先端がケース天面の縁に銀色の長方形として顔を出す（7353・7354）。

- **ブロック部**：軸方向 約9.5〜10mm × 幅 4.8mm × 高さ 約8.5mm の直方体状。下面側（装着時に基板を向く側）が開いたコの字状で、基板端のタブ＋追加タクトスイッチを中に入れる窪みになっている。後端側の下面角には斜めの面取りがある（7329）。
- **羽根**：ブロックの幅方向両側面、バーの付け根寄りの位置に、小さな角柱状の突起が左右対称に張り出す。羽根込みの幅 8.7mm（片側の張り出し約2.0mm）、羽根自体の軸方向の厚みは約2.5mm（7371 の外観からの推定）。ケース側のポケットに引っ掛けて位置決め・抜け止めにする部分とみられる。
- **バー**：ブロック前面から先端へ伸びる平板。露出長 約17〜18mm、幅 約4.8mm、厚さ 約1.5〜2.0mm。先端は軽く角が落とされている。ケースの縁を乗り越えるため、装着姿勢ではバー下面と基板上面の間にブロック高さ分の段差がある。
- **スイッチ押し突起**：ブロック下面（基板を向く面）の、バー付け根寄りの位置に付く小さな角柱。約2.5×2mm、突出 約1.5〜2mm（推定）。追加タクトスイッチのボタンを押す部分。軸方向の位置はブロック前面（バー側の面）から約2〜3mm内側（7372 の外観からの推定）。
- **クリップ内側**：タブ（基板厚1.6mm）とタクトスイッチ（本体上面が基板表面から約+3.3mm、ボタン上端 約+5.0mm）が収まる必要がある。窪みの高さの直接測定は未実施（項目10）。ケース設計ではブロック外形（高さ約8.5mm）側で逃げを取るのが安全。
  - **2026-11-05 実測で更新（写真 7463）**：基板の反対面からスイッチ外面（プランジャ先端）までの総厚は **6.8mm**（ノギス実測）。基板厚 1.6 を引くとスイッチの突出は **5.2mm** で、従来の写真推定「ボタン上端 約+5.0」はこれに置き換える。内訳は本体 約+3.3（従来推定のまま）＋プランジャ 約1.9。
  - **向きの訂正（2026-11-05 本人確認）**：タクトスイッチはキースイッチ側（基板の**上面**）に付き、ボタンは上向き・押下方向は下向き。ケース座標では基板上面 z=7.3 から約5.2 突出し、スイッチ上面（ボタン先端）は **z≈12.5**（フレーム天面 16.1 まで約3.6）。以前この欄に書いた「ボタン先端 z=0.5（裏面側）」は向きの誤解によるもので誤り。
  - **本人決定（2026-11-05）：金属パドルは取り付けない。** 高さが合わず（要求位置と約3.4〜4.2mm の不一致、§17.18）、純正ケースの傾斜前提の部品と推定される。本書の実測値は記録として残す。代替は印刷製プランジャを次ラウンドで検討（§17.18）。

## ケース設計への要点

- ポケット幅（幅方向）は羽根込み **8.7mm が最大寸法**。これに印刷公差分の余裕を足すこと。従来設計が入らなかった主因はこの羽根込み幅とみてよい。
- 軸方向の占有は **全長27.3mm**（ブロック後端〜バー先端）。バー先端の出代はブロック前面から約17〜18mm。
- 高さ方向の占有はブロック高さ **約8.5mm**（基板裏面側基準の配置は別途、基板・タクトスイッチの実測と突き合わせること）。
- バー厚みは 1.5〜2.0mm の範囲で読みが割れているため、逃げは 2.0mm 前提で設計すること。

## 未測定・要追加測定

1. クリップ内側の間隔（窪みの高さ・幅）— ブロックを裏返してノギスの内側ジョーで測定が必要。
2. スイッチ押し突起の正確な位置（ブロック前面からの距離）と大きさ。
3. ブロック高さ 8.5mm は定規併写の推定値。ノギスでの実測があると確度が上がる。
4. バー厚さ：付け根（1.5mm）と先端寄り（約2mm）のどちらが正しいか、バーの中間部での再測定。

## 追記（2026-11-04 本人再読）
- バー厚みは本人が実物で再読し **2.7mm** と確定。本文中の1.5〜2.0mmの推定はこれに置き換える。v2設計は2.7mm前提＋クリアランスで実施済み。

## 追記2（2026-11-05 本人ノギス実測、写真 7455 / 7456）— これを正とする

試作の実物確認で「パドルが全然はまらない」と判明し、本人がノギスで
再実測した（赤字注記つき写真 `7455_13_0rjx.jpg`（上面視）/
`7456_14_tktf.jpg`（側面視））。従来値は写真読みの推定が多く、
全長は 2mm 以上ずれていることが確定した。

| 寸法 | 旧値（写真推定） | 実測（2026-11-05） | 確度 | 根拠 |
|---|---|---|---|---|
| 全長（軸方向） | 27.3〜27.4 | **25.2** | 確定 | 7455: ノギス自体が 25.2 を挟んで表示 |
| バー幅（幅方向） | 約4.8（ブロックと同幅と推定） | **4.8** | 確定 | 7455: 上面視でバーを幅方向に挟んだ注記 |
| バー厚 | 2.7（本人再読） | **2.8** | 確定 | 7456: ノギスがバーを厚み方向に挟持（副尺読みも 2.8） |
| ブロック高さ（高さ方向） | 約8.5（定規併写の推定） | **8.6** | ほぼ確定 | 7456: 側面視でブロック全高を挟んだ注記。7329 の定規読み（約8.5）とも整合 |
| 羽根込み幅 | 約8.7（推定） | **8.2**（下記注記参照） | 推定（有力） | 7455: 上面視でブロック部の鉛直方向ブラケットが 8.2 を指す。7332 端面写真の画素比（羽根込み幅÷ブロック幅）からも 8.1〜8.2 で整合 |
| ブロック長さ（軸方向） | 約9.5〜10（推定） | 未確定（下記注記） | 未測定 | 8.2 の対応づけ次第で 8.2 になる。設計モデルでは 8.2 を採用し、感度確認として前後させる |
| ブロックの段差/ツメ状部分の高さ | （なし） | **3.6** | 推定 | 7456: ブロック下部の段差（窪みの下側の唇/ツメ）高さを指す注記と読んだ。側面プロファイル上、バーの上面付近〜窪み下端の段差に相当 |

### 8.2 の対応づけについての注記（未確定）
7455 の「8.2」のブラケットは上面視でブロック部の幅方向（羽根の
張り出し方向）を挟む位置に引かれており、羽根込み幅と読むのが
最も自然。ただし「ブロックの長さ方向（軸方向）寸法」の可能性も
完全には排除できない（全長 25.2 − バー露出 約17 = 約8.2 とも
計算が合う）。設計では両解釈をカバーする: 羽根込み幅は大きい方
（旧推定 8.7）を窓寸法の安全側として残し、ブロック長さは 8.2 を
中心に感度確認する（§17.18）。

### 形状の再確認（7456 側面視・7329・7332 から）
- 側面プロファイルは L 字: 下辺にバー（厚 2.8）が全長にわたり、
  後端でブロックが高さ 8.6 まで立ち上がる。後端下面に面取り。
- ブロック前面（バー付け根側）に窪み（クリップ部）があり、その
  下側の唇が 3.6 の段差に相当する（推定）。
- 端面視（7332）: 基板タブはブロック上部（上面から約1.0下に
  タブ上面）に入り、羽根はタブの板面レベルで両側に張り出す。
  羽根はブロック前面寄りの小さい角柱で、全長にわたる脚ではない。
- 装着姿勢: 配置B（基板縁を幅方向に跨ぐコの字チャネル、バーは
  ブロック上部から後方へ出る）は写真と矛盾しない。バーの鉛直
  位置はブロック上面とほぼ面一（チャネルの天板がタブ上面に
  乗る前提では バー下端 = 基板上面 + 天板厚 − 2.8）。
