koorayworks/7spromax-case/(commit log)

2026-11-03 Initial import: measurements, design v1 scripts and trial-piece STLs (ASCII)
    [7spromax_case_template.dxf, pcb_outline_long.csv, pcb_outline_short.csv, pcb_sockets.csv, plate_holes.csv, plate_holes_v2.csv, trial_boss_bottom_long.stl, trial_boss_bottom_short.stl]
2026-11-03 Add short trial stair piece and top frame (ASCII STL)
    [top_frame_short.stl, trial_stair_short.stl]
2026-11-03 Add long trial stair piece and top frame (ASCII STL)
    [top_frame_long.stl, trial_stair_long.stl]
2026-11-03 Add switch plates (ASCII STL)
    [switch_plate_long.stl, switch_plate_short.stl]
2026-11-03 Add bottom cases (ASCII STL)
    [bottom_case_long.stl, bottom_case_short.stl]
2026-11-03 Fix STL export: single solid per part, dropped to z=0, fused bosses
    [trial_boss_bottom_long.stl, trial_boss_bottom_short.stl, trial_boss_frame_long.stl, trial_boss_frame_short.stl, trial_corner_short.stl]
2026-11-03 Update short stair trial and top frame (single solid, z=0)
    [top_frame_short.stl, trial_stair_short.stl]
2026-11-03 Update long stair trial and top frame (single solid, z=0)
    [top_frame_long.stl, trial_stair_long.stl]
2026-11-03 Update short switch plate and long bottom case (single solid, z=0)
    [bottom_case_long.stl, switch_plate_short.stl]
2026-11-03 Update long switch plate (single solid, z=0)
    [switch_plate_long.stl]
2026-11-03 Update short bottom case (single solid, z=0)
    [bottom_case_short.stl]
2026-11-03 Design v2: measured PCB outline cavity, 14.0mm plate holes, paddle envelope, no FR4 layer
    [pcb_outline2_long.csv, pcb_outline2_short.csv, pcb_screw_holes.csv, trial_plate_holes.stl]
2026-11-03 v2 STL: short bottom case, long screw trial
    [bottom_case_short.stl, trial_screw_long.stl]
2026-11-03 v2 STL: long bottom case, short stair trial
    [bottom_case_long.stl, trial_stair_short.stl]
2026-11-03 v2 STL: screw and stair trials, switch plates
    [switch_plate_long.stl, switch_plate_short.stl, trial_screw_short.stl, trial_stair_long.stl]
2026-11-03 v2 STL: top frames, corner trial
    [top_frame_long.stl, top_frame_short.stl, trial_corner_short.stl]
2026-11-04 v2.1: frame inner wall fix, paddle slots, stair wall blocks, white side band parts, consolidated trials (scripts and docs)
    [trial_corner_band_short.stl, trial_stair_band_long.stl]
2026-11-04 v2.1: top frames and corner frame trial (ASCII STL)
    [top_frame_long.stl, top_frame_short.stl, trial_corner_frame_short.stl]
2026-11-04 v2.1: bottom trays, side band long, switch plate short (ASCII STL)
    [bottom_tray_long.stl, bottom_tray_short.stl, side_band_long.stl, switch_plate_short.stl]
2026-11-04 v2.1: side band short, switch plate long, remaining trial pieces (ASCII STL)
    [side_band_short.stl, switch_plate_long.stl, trial_corner_band_long.stl, trial_corner_frame_long.stl, trial_corner_tray_long.stl, trial_corner_tray_short.stl, trial_stair_band_short.stl]
2026-11-04 v2.2: bridge stair inner profile (remove phantom-bay spikes), fix USB/TRRS opening positions (scripts, notes, band and small trials)
    [side_band_short.stl, trial_corner_band_long.stl, trial_corner_band_short.stl, trial_stair_band_long.stl, trial_stair_band_short.stl]
2026-11-04 v2.2: top frames and switch plates (ASCII STL)
    [switch_plate_long.stl, switch_plate_short.stl, top_frame_long.stl, top_frame_short.stl]
2026-11-04 v2.2: bottom trays, side band long, corner trial pieces (ASCII STL)
    [bottom_tray_long.stl, bottom_tray_short.stl, side_band_long.stl, trial_corner_frame_long.stl, trial_corner_frame_short.stl, trial_corner_tray_long.stl, trial_corner_tray_short.stl]
2026-11-04 v2.2: combined trial print file - all 9 trial pieces laid out on one 180x180 plate (trial_all_v22.stl)
    [trial_all_v22.stl]
2026-11-04 v2.3: rebuild stair PCB outline as clean steps (outline3), remove triangular wall excess (scripts, notes, template, small trials)
    [pcb_outline3_long.csv, pcb_outline3_short.csv, trial_corner_band_long.stl, trial_corner_band_short.stl, trial_stair_band_long.stl, trial_stair_band_short.stl]
2026-11-04 v2.3: bottom trays, top frame short, corner frame trial (ASCII STL)
    [bottom_tray_long.stl, bottom_tray_short.stl, top_frame_short.stl, trial_corner_frame_short.stl]
2026-11-04 v2.3: top frame long, switch plates, side bands (ASCII STL)
    [side_band_long.stl, side_band_short.stl, switch_plate_long.stl, switch_plate_short.stl, top_frame_long.stl]
2026-11-04 v2.3: combined trial file and remaining corner trials (ASCII STL)
    [trial_all_v22.stl, trial_corner_frame_long.stl, trial_corner_tray_long.stl, trial_corner_tray_short.stl]
2026-11-04 v2.4: docking seam reshape plan-2 without magnets (scripts, notes, study, small trials)
    [trial_corner_band_long.stl, trial_corner_band_short.stl, trial_stair_band_long.stl, trial_stair_band_short.stl]
2026-11-04 v2.4: bottom trays, top frame short, corner frame trial (ASCII STL)
    [bottom_tray_long.stl, bottom_tray_short.stl, top_frame_short.stl, trial_corner_frame_short.stl]
2026-11-04 v2.4: top frame long, switch plates, side bands (ASCII STL)
    [side_band_long.stl, side_band_short.stl, switch_plate_long.stl, switch_plate_short.stl, top_frame_long.stl]
2026-11-04 v2.4: combined trial file and remaining corner trials (ASCII STL)
    [trial_all_v22.stl, trial_corner_frame_long.stl, trial_corner_tray_long.stl, trial_corner_tray_short.stl]
2026-11-04 v2.4.1: bridge plate stair edge so all switch holes regain full rim support (plates, scripts, notes)
    [switch_plate_long.stl, switch_plate_short.stl]
2026-11-04 v2.4.1: top frames follow bridged plate pocket on stair band (ASCII STL)
    [top_frame_long.stl, top_frame_short.stl]
2026-11-04 v2.4.2: straighten PCB outline edges (trays, bands)
    [bottom_tray_long.stl, side_band_long.stl, side_band_short.stl]
2026-11-04 v2.4.2: straighten PCB outline edges (plates, frames); clean plate corner comb
    [switch_plate_long.stl, switch_plate_short.stl, top_frame_long.stl, top_frame_short.stl]
2026-11-04 v2.4.2: regenerate trial set from straightened final geometry
    [trial_all_v22.stl, trial_corner_band_long.stl, trial_corner_band_short.stl, trial_corner_frame_long.stl, trial_corner_frame_short.stl, trial_corner_tray_long.stl, trial_stair_band_long.stl, trial_stair_band_short.stl]
2026-11-04 v2.4.2: build script, notes (17.15), straightened outline3
    [pcb_outline3_long.csv, pcb_outline3_short.csv]
2026-11-04 archive: move obsolete v1/trial files into design/archive/ (1/5)
    [bottom_case_long.stl, trial_boss_frame_long.stl]
2026-11-04 archive: move obsolete v1/trial files into design/archive/ (2/5)
    [bottom_case_short.stl]
2026-11-04 archive: move obsolete v1/trial files into design/archive/ (3/5)
    [trial_boss_bottom_short.stl, trial_stair_short.stl]
2026-11-04 archive: move obsolete v1/trial files into design/archive/ (4/5)
    [trial_screw_long.stl, trial_screw_short.stl]
2026-11-04 archive: move obsolete v1/trial files into design/archive/ (5/5)
    [trial_boss_bottom_long.stl, trial_boss_frame_short.stl, trial_corner_short.stl, trial_stair_long.stl]
2026-11-04 archive: moved to design/archive/
    [bottom_case_short.stl]
2026-11-04 v2.4.3: restore corner switch hole to 14.15; make USB opening actually through
    [switch_plate_long.stl, top_frame_long.stl, top_frame_short.stl]
2026-11-04 v2.4.3: regenerate corner frame trials and trial_all with USB through-cut
    [trial_all_v22.stl, trial_corner_frame_long.stl, trial_corner_frame_short.stl]
2026-11-05 v2.4.4: 実測是正のソース・記録・テンプレート（DESIGN_NOTES §17.18、TRRS/タクト軸是正、階段段境界の実測置換、USB開口移設とプランジャ検討、ピンヘッダ2.5mm確定）
    [pcb_outline3_long.csv, pcb_outline3_short.csv]
2026-11-05 v2.4.4: 本体STL（ボトムトレイ／サイドバンド）— MCUポケット追加、階段段境界の実測是正
    [bottom_tray_long.stl, bottom_tray_short.stl, side_band_long.stl, side_band_short.stl]
2026-11-05 v2.4.4: 本体STL（スイッチプレート／トップフレーム）— タクト逃げ拡大、旧USB開口の閉塞
    [switch_plate_long.stl, switch_plate_short.stl, top_frame_long.stl, top_frame_short.stl]
2026-11-05 v2.4.4: 試作STL再生成（trial_all・角ピース・階段バンド）
    [trial_all_v22.stl, trial_corner_band_long.stl, trial_corner_band_short.stl, trial_corner_frame_long.stl, trial_corner_frame_short.stl, trial_corner_tray_long.stl, trial_corner_tray_short.stl, trial_stair_band_long.stl]
2026-11-05 v2.4.5: プランジャ実装のソース・記録（DESIGN_NOTES §17.19、check_plunger追加）
2026-11-05 v2.4.5: プランジャ本体とトップフレームSTL（ガイド穴・座ぐり追加）
    [plunger.stl, top_frame_long.stl, top_frame_short.stl]
2026-11-05 v2.4.5: 試作角フレームSTL再生成（プランジャガイド穴入り）
    [trial_corner_frame_long.stl, trial_corner_frame_short.stl]
2026-11-05 v2.4.5: trial_all再生成（17ピース、プランジャ6個追加）
    [trial_all_v22.stl]
2026-11-05 v2.4.6: 設計是正（階段クリアランス0.8化・蹴上クリップ解消・L21逃げ・タクト逃げ8.0化、プレート背面縁タクト逃げ追加）とDESIGN_NOTES §17.20
2026-11-05 v2.4.6: 本体STL再生成（トレイ／バンド）
    [bottom_tray_long.stl, bottom_tray_short.stl, side_band_long.stl, side_band_short.stl]
2026-11-05 v2.4.6: 本体STL再生成（プレート／フレーム／プランジャ）
    [plunger.stl, switch_plate_long.stl, switch_plate_short.stl, top_frame_long.stl, top_frame_short.stl]
2026-11-05 v2.4.6: 試作ピースSTL再生成（角・階段・穴ピース）
    [trial_corner_band_long.stl, trial_corner_band_short.stl, trial_corner_frame_long.stl, trial_corner_frame_short.stl, trial_corner_tray_long.stl, trial_corner_tray_short.stl, trial_plate_holes.stl, trial_stair_band_long.stl]
2026-11-05 v2.4.6: trial_all再生成（17ピース）
    [trial_all_v22.stl]
2026-11-05 v2.4.7: スクリプト＋DESIGN_NOTES §17.21
2026-11-05 v2.4.7: 本体STL フレーム再生成
    [top_frame_long.stl, top_frame_short.stl]
2026-11-05 v2.4.7: 試作ピースSTL再生成（角フレーム）
    [trial_corner_frame_long.stl, trial_corner_frame_short.stl]
2026-11-05 v2.4.7: trial_all再生成（17ピース）
    [trial_all_v22.stl]
2026-11-05 v2.4.8 TRRS裏面実装対応: チェックスクリプトとトレイ系STL (§17.22)
    [bottom_tray_long.stl, bottom_tray_short.stl, trial_corner_tray_long.stl, trial_corner_tray_short.stl]
2026-11-05 v2.4.9 レッジ切り欠き: チェックスクリプトとバンド系STL (§17.23)
    [side_band_long.stl, side_band_short.stl, trial_corner_band_long.stl, trial_corner_band_short.stl]
2026-11-05 v2.4.9 階段バンド試作ピース更新 (§17.23)
    [trial_stair_band_long.stl, trial_stair_band_short.stl]
2026-11-05 v2.4.10 long最上段の歯の是正: スクリプト・輪郭・記録 (§17.24)
    [pcb_outline3_long.csv]
2026-11-05 v2.4.10 フレームSTL更新 (§17.24)
    [top_frame_long.stl, top_frame_short.stl]
2026-11-05 v2.4.10 プレート/プランジャ/角試作STL更新 (§17.24)
    [plunger.stl, switch_plate_long.stl, switch_plate_short.stl, trial_corner_frame_long.stl, trial_corner_frame_short.stl, trial_plate_holes.stl]
2026-11-05 v2.4.11 TRRS確認ピース追加: スクリプト・記録 (§17.25)
2026-11-05 v2.4.11 TRRS確認ピースSTL (§17.25)
    [trial_trrs_band_long.stl, trial_trrs_band_short.stl, trial_trrs_frame_long.stl, trial_trrs_frame_short.stl, trial_trrs_tray_long.stl, trial_trrs_tray_short.stl]
2026-11-05 v2.4.11 試作セット分割1: trial_all_1 (§17.25)
    [trial_all_1.stl]
2026-11-05 v2.4.11 試作セット分割2: trial_all_2 (§17.25)
    [trial_all_2.stl]
2026-11-05 v2.4.11 スイッチ穴ピースを削除（不要のため） (§17.25)
    [trial_plate_holes.stl]
2026-11-05 v2.4.11 旧試作セット trial_all_v22 を削除（分割版 trial_all_1/2 へ移行） (§17.25)
    [trial_all_v22.stl]
2026-11-06 v2.4.12 スクリプト・記録：タクト中心是正・プランジャ差し込み口・背面帯ピース (§17.26)
2026-11-06 v2.4.12 フレーム再生成：top_frame (§17.26)
    [top_frame_long.stl, top_frame_short.stl]
2026-11-06 v2.4.12 プレート／プランジャ再生成 (§17.26)
    [plunger.stl, switch_plate_long.stl, switch_plate_short.stl]
2026-11-06 v2.4.12 背面帯試作ピース trial_back 6点（新規） (§17.26)
    [trial_back_band_long.stl, trial_back_band_short.stl, trial_back_frame_long.stl, trial_back_frame_short.stl, trial_back_tray_long.stl, trial_back_tray_short.stl]
2026-11-06 v2.4.12 試作セット再構成1: trial_all_1 (§17.26)
    [trial_all_1.stl]
2026-11-06 v2.4.12 試作セット再構成2: trial_all_2 (§17.26)
    [trial_all_2.stl]
2026-11-06 v2.4.12 旧試作 trial_corner_band_long を削除（背面帯ピースへ移行） (§17.26)
    [trial_corner_band_long.stl]
2026-11-06 v2.4.12 旧試作 trial_corner_band_short を削除（背面帯ピースへ移行） (§17.26)
    [trial_corner_band_short.stl]
2026-11-06 v2.4.12 旧試作 trial_corner_frame_long を削除（背面帯ピースへ移行） (§17.26)
    [trial_corner_frame_long.stl]
2026-11-06 v2.4.12 旧試作 trial_corner_frame_short を削除（背面帯ピースへ移行） (§17.26)
    [trial_corner_frame_short.stl]
2026-11-06 v2.4.12 旧試作 trial_corner_tray_long を削除（背面帯ピースへ移行） (§17.26)
    [trial_corner_tray_long.stl]
2026-11-06 v2.4.12 旧試作 trial_corner_tray_short を削除（背面帯ピースへ移行） (§17.26)
    [trial_corner_tray_short.stl]
2026-11-06 v2.4.12 旧試作 trial_trrs_band_long を削除（背面帯ピースへ移行） (§17.26)
    [trial_trrs_band_long.stl]
2026-11-06 v2.4.12 旧試作 trial_trrs_band_short を削除（背面帯ピースへ移行） (§17.26)
    [trial_trrs_band_short.stl]
2026-11-06 v2.4.12 旧試作 trial_trrs_frame_long を削除（背面帯ピースへ移行） (§17.26)
    [trial_trrs_frame_long.stl]
2026-11-06 v2.4.12 旧試作 trial_trrs_frame_short を削除（背面帯ピースへ移行） (§17.26)
    [trial_trrs_frame_short.stl]
2026-11-06 v2.4.12 旧試作 trial_trrs_tray_long を削除（背面帯ピースへ移行） (§17.26)
    [trial_trrs_tray_long.stl]
2026-11-06 Remove obsolete TRRS trial tray piece (short)
    [trial_trrs_tray_short.stl]
2026-11-06 v2.4.13 番号浮き彫りの一部撤回: スクリプトと記録 (§17.27)
2026-11-06 v2.4.13 番号浮き彫りの一部撤回: trial_all_1 (§17.27)
    [trial_all_1.stl]
2026-11-06 v2.4.13 番号浮き彫りの一部撤回: trial_all_2 (§17.27)
    [trial_all_2.stl]
2026-11-06 v2.4.14: スクリプトと設計記録（タクト中心 y 是正・位置バリエーション試作、§17.28）
2026-11-06 v2.4.14: 本体パーツ再生成（フレーム／プレート／プランジャ）
    [plunger.stl, switch_plate_long.stl, switch_plate_short.stl, top_frame_long.stl, top_frame_short.stl]
2026-11-06 v2.4.14: 背面帯ピース再生成
    [trial_back_band_long.stl, trial_back_band_short.stl, trial_back_frame_long.stl, trial_back_frame_short.stl, trial_back_tray_long.stl, trial_back_tray_short.stl]
2026-11-06 v2.4.14: trial_all_1（タクト角ピース構成）
    [trial_all_1.stl]
2026-11-06 v2.4.14: trial_all_2（タクト角ピース構成）
    [trial_all_2.stl]
2026-11-06 v2.4.14: タクト角ピース単体（フレーム＋x0 群）
    [trial_tact_frame_long.stl, trial_tact_frame_short.stl, trial_tact_frame_short_s15.stl, trial_tact_frame_short_s19.stl]
2026-11-06 v2.4.14: タクト角ピース単体（x19 群＋s23）
    [trial_tact_frame_short_s15_x19.stl, trial_tact_frame_short_s19_x19.stl, trial_tact_frame_short_s23.stl, trial_tact_frame_short_s23_x19.stl]
2026-11-06 v2.4.14: タクト位置バリエーション統合 x0 群（分割 1/2）
    [trial_tact_variants_1.stl]
2026-11-06 v2.4.14: タクト位置バリエーション統合 x19 群（分割 2/2）
    [trial_tact_variants_2.stl]
2026-11-06 v2.4.14: §17.28 追記（分割収録と数値表記短縮の注記）
2026-11-06 v2.4.15: §17.29 long検証・§17.30 TRRS壁の前提訂正（スクリプトと設計ノート）
2026-11-07 v2.4.15: フレーム背面壁をTRRS手前で終了（フレーム・帯フレーム）
    [top_frame_long.stl, top_frame_short.stl, trial_back_frame_long.stl, trial_back_frame_short.stl]
2026-11-07 v2.4.15: trial_all_2 を現行角ピースで組み直し
    [trial_all_2.stl]
2026-11-07 v2.4.15: shortバリエーション彫り込み鏡像の修正（分割収録）
    [trial_tact_variants_1.stl]
2026-11-07 v2.4.15: longタクト位置バリエーション単体6種（§17.29）
    [trial_tact_frame_long_m19.stl, trial_tact_frame_long_m19_x19.stl, trial_tact_frame_long_s0.stl, trial_tact_frame_long_s0_x19.stl, trial_tact_frame_long_s19.stl, trial_tact_frame_long_s19_x19.stl]
2026-11-07 v2.4.15: longバリエーション統合の分割収録（§17.29）
    [trial_tact_variants_long_1.stl]
2026-11-07 v2.4.16: shortタクト位置の是正方向を修正（§17.31、逆向きバリエーション rev 統合1）
    [trial_tact_variants_rev_1.stl]
2026-11-07 v2.4.16: shortタクト位置の是正方向を修正（§17.31、逆向きバリエーション rev 統合2）
    [trial_tact_variants_rev_2.stl]
2026-11-07 v2.4.16: shortタクト位置の是正方向を修正（§17.31、逆向きバリエーション単体6種・生成スクリプト・記録）
    [trial_tact_frame_short_r15.stl, trial_tact_frame_short_r15_x19.stl, trial_tact_frame_short_r19.stl, trial_tact_frame_short_r19_x19.stl, trial_tact_frame_short_r23.stl, trial_tact_frame_short_r23_x19.stl]
